FrameworkComputer/InputModules/Electrical/MinimalSmallInputModule/README.md

# Minimal Small Input Module


This is a blank Small Input Module that you can start from.

## License
Input Modules © 2023 by Framework Computer Inc is licensed under CC BY 4.0. To view a copy of this license, visit http://creativecommons.org/licenses/by/4.0/

## Fabrication and Assembly
We recommend using either a 0.8mm or 1.0mm PCB for Input Modules.
