FrameworkComputer/InputModules/Mechanical/Touchpad.md

# Touchpad

Touchpad mechanical CAD has been published in the
[Framework-Laptop-16](https://github.com/FrameworkComputer/Framework-Laptop-16/tree/main/Touchpad)
repository.
