FrameworkComputer/InputModules/Electrical/LEDMatrix/README.md

# LED Matrix Input Module
This is a 34x9 LED Matrix powered by a Raspberry Pi RP2040 microcontroller.

## Pre-production Unit
rp2040

Note that the KiCAD version of this project is incomplete and untested, and is only provided as a reference.

The Atemitech prototype was made and tested, but is missing
use of the #SLEEP signal in the current revision.
It is not the version that is shipping to customers.

## Mass Production Unit

Below are the pinouts of the mass production units.

###### RP2040 MCU Pinouts

| Pin | Name | To | Direction | Config |
|---|---|---|---|---|
| GPIO0  | Sleep | EC | IN | Pullup, low active |
| GPIO25 | DIP1 | DIP Switch | IN | Pullup |
| GPIO26 | I2C1_SDA | IS31FL3741 | IN/OUT | |
| GPIO27 | I2C1_SCL | IS31FL3741 | OUT | |
| GPIO28 | INTB | IS31FL3741 | IN | Floating (unused)  |
| GPIO29 | SDB | IS31FL3741 | OUT | High active |

###### Test Pads

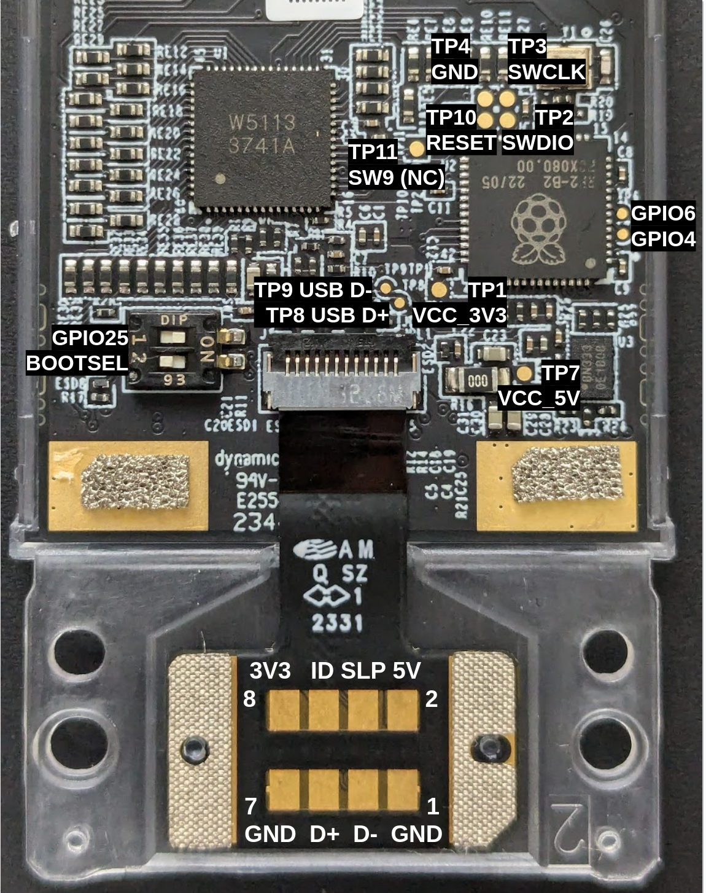
[picture p9: Electrical/LEDMatrix/test-pads.png]
Annotated picture with test pads


| Pad  | Name | Function |
|---|---|---|
| TP1  | VCC_3V3  | |
| TP2  | SWDIO | SWD Debug  |
| TP3  | SWCLK | SWD Debug  |
| TP4  | GND | SWD Debug  |
| TP5  | GPIO4 | |
| TP6  | GPIO5 | |
| TP7  | VCC_5V | |
| TP8  | USB DP | USB 2.0 |
| TP9  | USB DM | USB 2.0 |
| TP10 | RESET | |
| TP11 | SW9 | |
| DIP1 | GPIO25 | |
| DIP2 | BOOTSEL  | |

TP2-4 are used for SWD debugging and can be used with [picoprobe](https://www.raspberrypi.com/documentation/microcontrollers/debug-probe.html) or similar.

RESET and BOOTSEL are also useful. If RESET is shorted to GND it resets the RP2040.
If BOOTSEL is shorted to GND while the RP2040 comes out of reset, it boots into UF2 bootlaoder for firmware update.

###### IS31FL3741 LED Controller

[Documentation](https://www.lumissil.com/applications/industrial/appliance/major-appliances/range-hood/is31fl3741a)
and [Datasheet](https://www.lumissil.com/assets/pdf/core/IS31FL3741A_DS.pdf)
of this controller are publicly available.

It drives a matrix of 9x34 (306) LEDs.

| Pin | To | Direction | Config |
|---|---|---|---|
| SDA | RP2040 | IN/OUT | |
| SCL | RP2040 | IN | |
| INTB | RP2040 | OUT | Floating (unused) |
| SDB | RP2040 | IN | High active |
| ISET | 27k to GND  | | |
| ADDR | 100k to GND | | |
| SW1-SW8  | LED | OUT | See table below |
| SW9 | NC | | Unused |
| CS1-CS39 | LED | OUT | See table below |

The ISET and ADDR wiring results in I2C Address 0x30.

Below is the table describing how the LEDs are placed on the matrix
and how they are wired up to the LED controller.

- X is the X location in the matrix (from left to right)
- Y is the Y location in the matrix (from bottom to top)
- ID is the numerical identifier of the LED
- Address and Page describe the memory location in the IS31FL3741's registers
- SW and CS are the pins

Please refer to the controller's datasheet for additional information about how to
program it.

| X | Y  | ID  | Address | Page | SW | CS |
|---|----|-----|---|---|----|----|
| 1 | 1  | 1 | 0x00 | 0 | 1  | 1  |
| 2 | 1  | 2 | 0x1e | 0 | 2  | 1  |
| 3 | 1  | 3 | 0x3c | 0 | 3  | 1  |
| 4 | 1  | 4 | 0x5a | 0 | 4  | 1  |
| 5 | 1  | 5 | 0x78 | 0 | 5  | 1  |
| 6 | 1  | 6 | 0x96 | 0 | 6  | 1  |
| 7 | 1  | 7 | 0x00 | 1 | 7  | 1  |
| 8 | 1  | 8 | 0x1e | 1 | 8  | 1  |
| 9 | 1  | 9 | 0x5f | 1 | 1  | 36 |
| 1 | 2  | 10  | 0x01 | 0 | 1  | 2  |
| 2 | 2  | 11  | 0x1f | 0 | 2  | 2  |
| 3 | 2  | 12  | 0x3d | 0 | 3  | 2  |
| 4 | 2  | 13  | 0x5b | 0 | 4  | 2  |
| 5 | 2  | 14  | 0x79 | 0 | 5  | 2  |
| 6 | 2  | 15  | 0x97 | 0 | 6  | 2  |
| 7 | 2  | 16  | 0x01 | 1 | 7  | 2  |
| 8 | 2  | 17  | 0x1f | 1 | 8  | 2  |
| 9 | 2  | 18  | 0x60 | 1 | 1  | 37 |
| 1 | 3  | 19  | 0x02 | 0 | 1  | 3  |
| 2 | 3  | 20  | 0x20 | 0 | 2  | 3  |
| 3 | 3  | 21  | 0x3e | 0 | 3  | 3  |
| 4 | 3  | 22  | 0x5c | 0 | 4  | 3  |
| 5 | 3  | 23  | 0x7a | 0 | 5  | 3  |
| 6 | 3  | 24  | 0x98 | 0 | 6  | 3  |
| 7 | 3  | 25  | 0x02 | 1 | 7  | 3  |
| 8 | 3  | 26  | 0x20 | 1 | 8  | 3  |
| 9 | 3  | 27  | 0x61 | 1 | 1  | 38 |
| 1 | 4  | 28  | 0x03 | 0 | 1  | 4  |
| 2 | 4  | 29  | 0x21 | 0 | 2  | 4  |
| 3 | 4  | 30  | 0x3f | 0 | 3  | 4  |
| 4 | 4  | 31  | 0x5d | 0 | 4  | 4  |
| 5 | 4  | 32  | 0x7b | 0 | 5  | 4  |
| 6 | 4  | 33  | 0x99 | 0 | 6  | 4  |
| 7 | 4  | 34  | 0x03 | 1 | 7  | 4  |
| 8 | 4  | 35  | 0x21 | 1 | 8  | 4  |
| 9 | 4  | 36  | 0x62 | 1 | 1  | 39 |
| 1 | 5  | 37  | 0x04 | 0 | 1  | 5  |
| 2 | 5  | 41  | 0x22 | 0 | 2  | 5  |
| 3 | 5  | 45  | 0x40 | 0 | 3  | 5  |
| 4 | 5  | 49  | 0x5e | 0 | 4  | 5  |
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

## License
Input Modules © 2023 by Framework Computer Inc is licensed under CC BY 4.0. To view a copy of this license, visit http://creativecommons.org/licenses/by/4.0/
