FrameworkComputer/InputModules/Mechanical/Medium/fw_b_size_design_ref_0-1.dxf

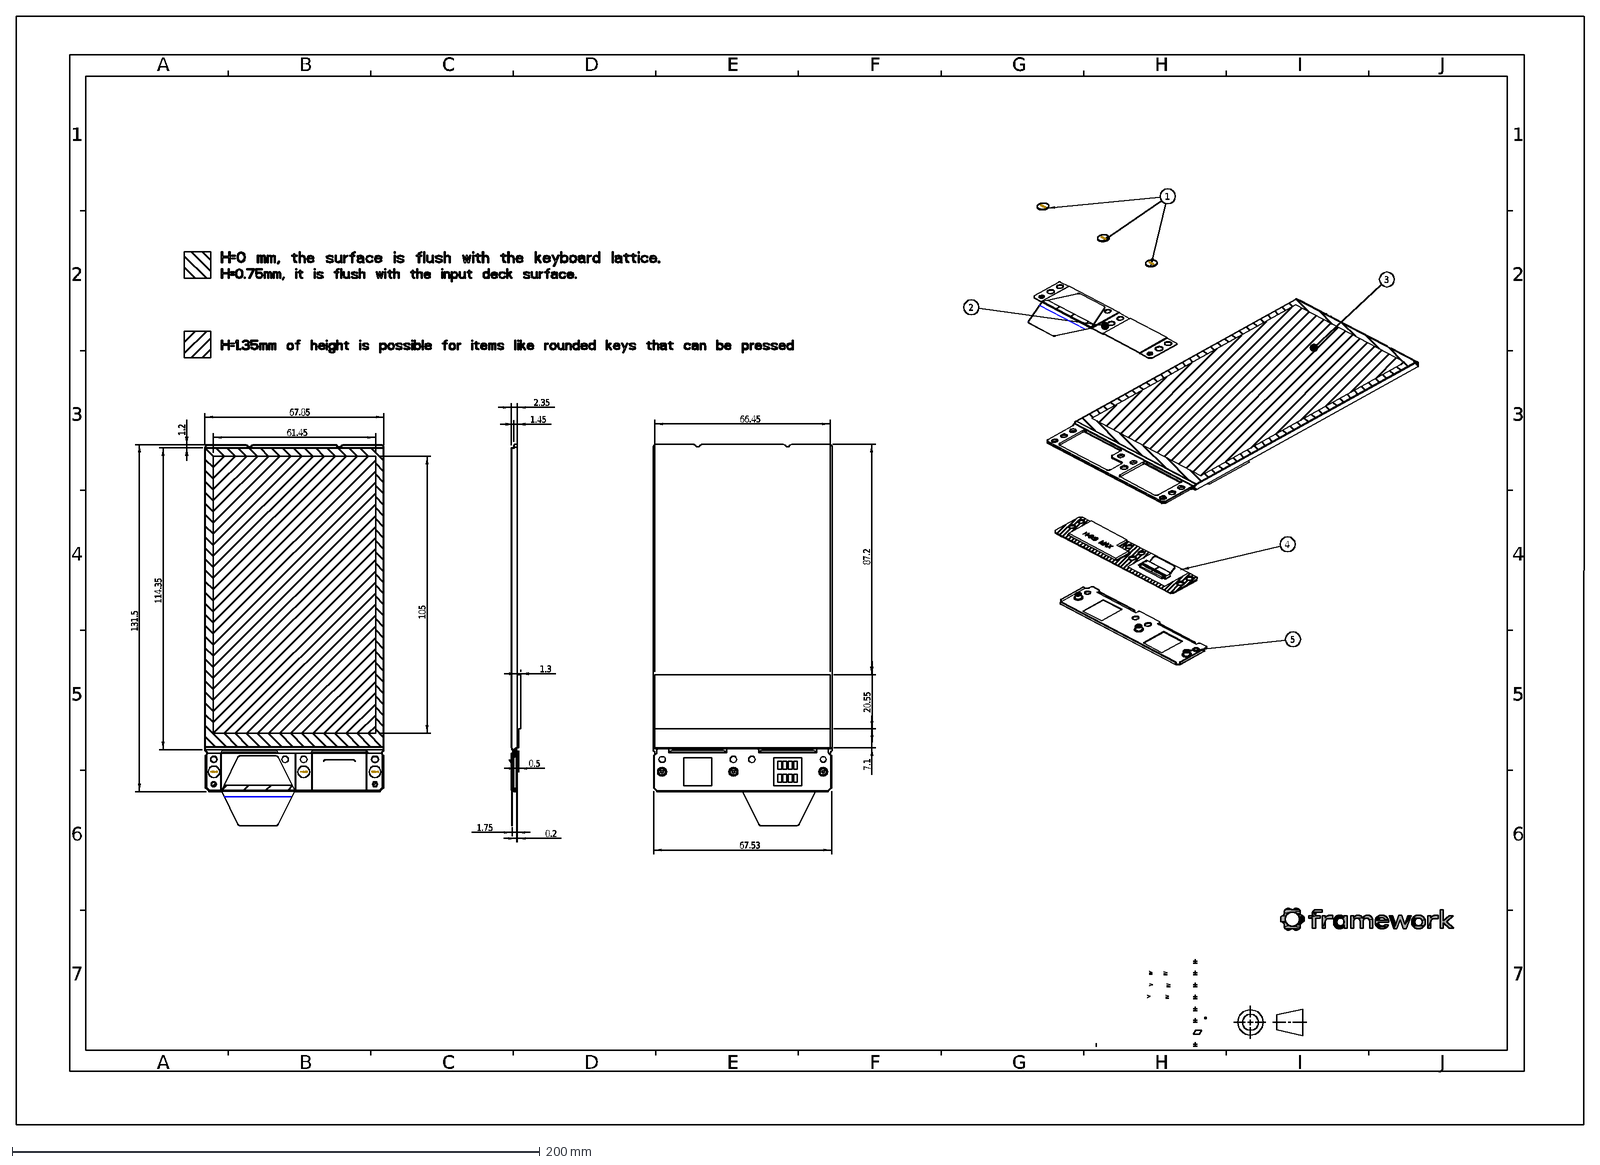
[picture p10: CAD file, 2023-03-12]
Mechanical/Medium/fw_b_size_design_ref_0-1.dxf
A
7
6
5
C
B
D
1
4
3
2
E
F
G
H
I
J
67.85
131.5
2.35
1.45
1.2
114.35
105
61.45
1.3
0.5
0.2
1.75
67.53
87.2
20.55
7.1
66.45
