FrameworkComputer/InputModules/Mechanical/Small/Module/c1_design_space_ref_3.dxf

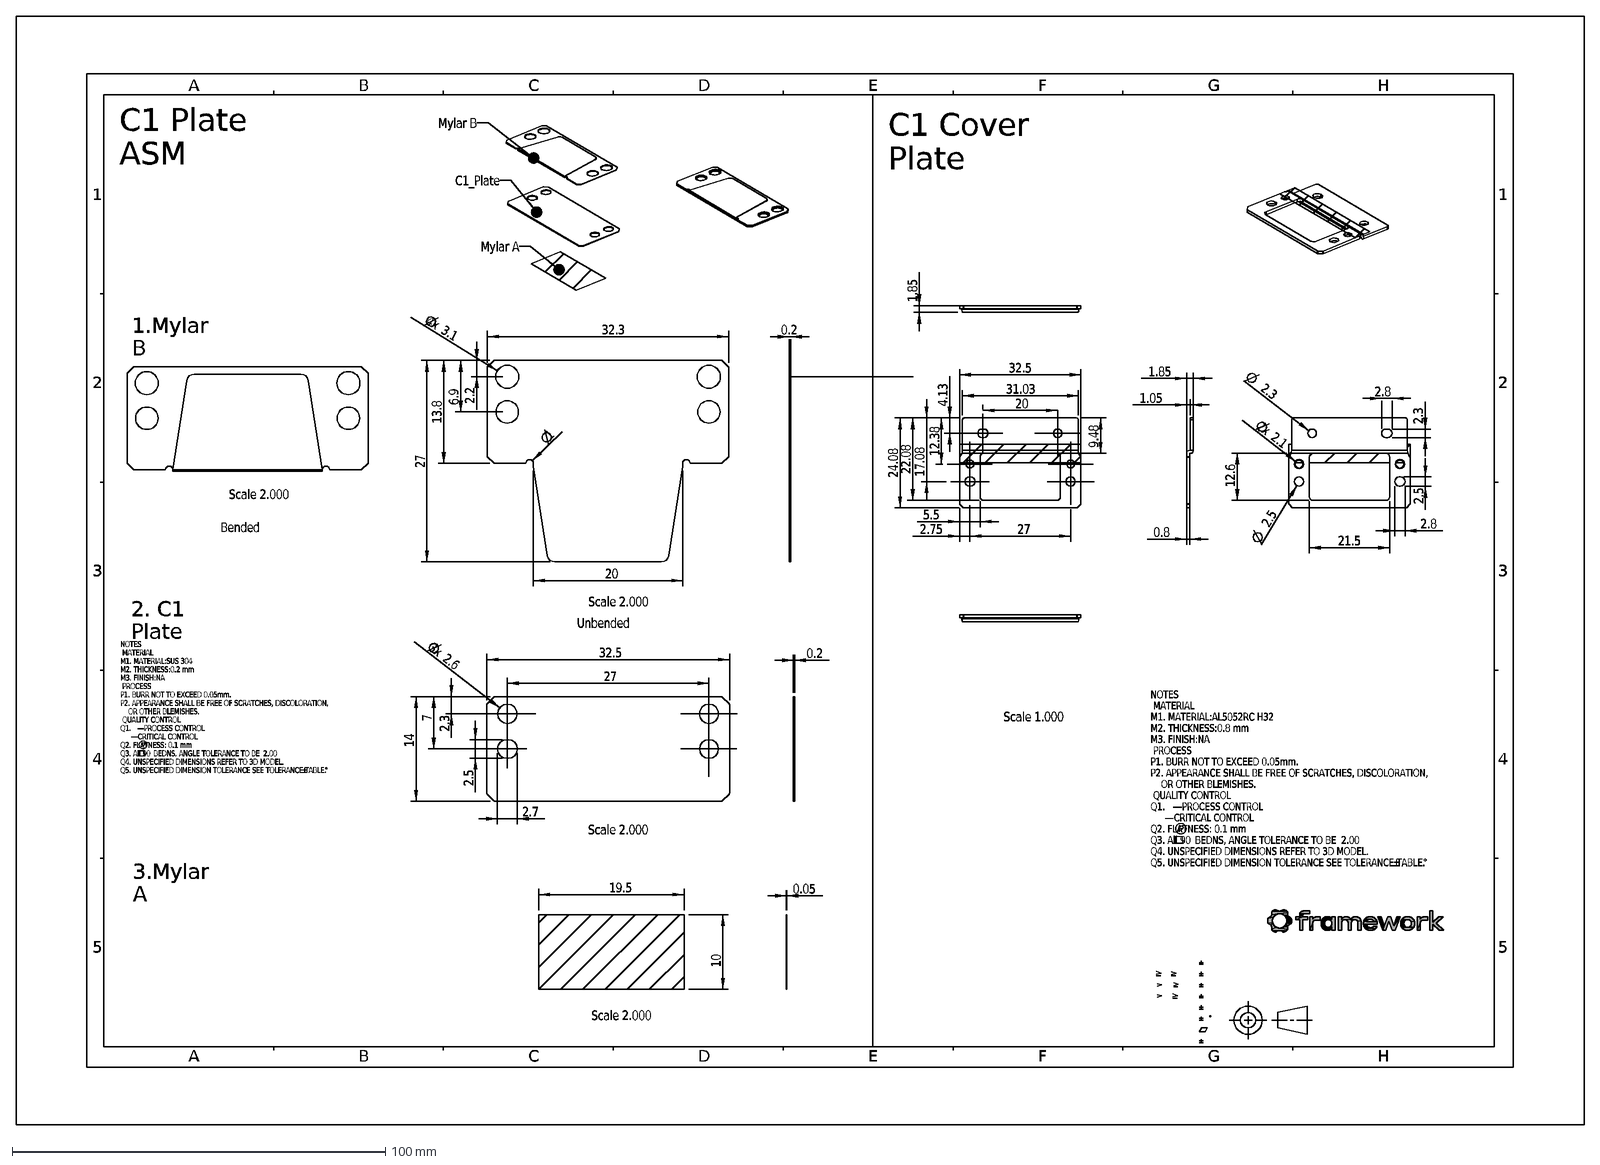
[picture p11: CAD file, 2023-03-12]
Mechanical/Small/Module/c1_design_space_ref_3.dxf
A
B
5
4
3
2
1
C
D
E
F
G
H
32.5
14
27
2.3
0.2
32.3
3x \~2.6
2.5
2.7
4x \~3.1
7
13.8
2.2
6.9
20
19.5
10
0.05
31.03
2x \~2.1
2.8
1.85
0.8
1.05
24.08
22.08
12.38
4.13
17.08
21.5
12.6
2.75
5.5
9.48
NOTES MATERIAL M1. MATERIAL:SUS 304 M2. THICKNESS:0.2 mm M3. FINISH:NA PROCESS P1. BURR NOT TO EXCEED 0.05mm. P2. APPEARANCE SHALL BE FREE OF SCRATCHES, DISCOLO
Bended
Unbended
C1 Plate ASM
1.Mylar B
3.Mylar A
2. C1 Plate
C1 Cover Plate
NOTES MATERIAL M1. MATERIAL:AL5052RC H32 M2. THICKNESS:0.8 mm M3. FINISH:NA PROCESS P1. BURR NOT TO EXCEED 0.05mm. P2. APPEARANCE SHALL BE FREE OF SCRATCHES, DI
Scale 2.000
Mylar B
C1_Plate
Mylar A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
