FrameworkComputer/InputModules/Mechanical/Small/PCB/c1_pcb_concept_design_ref_2.dxf

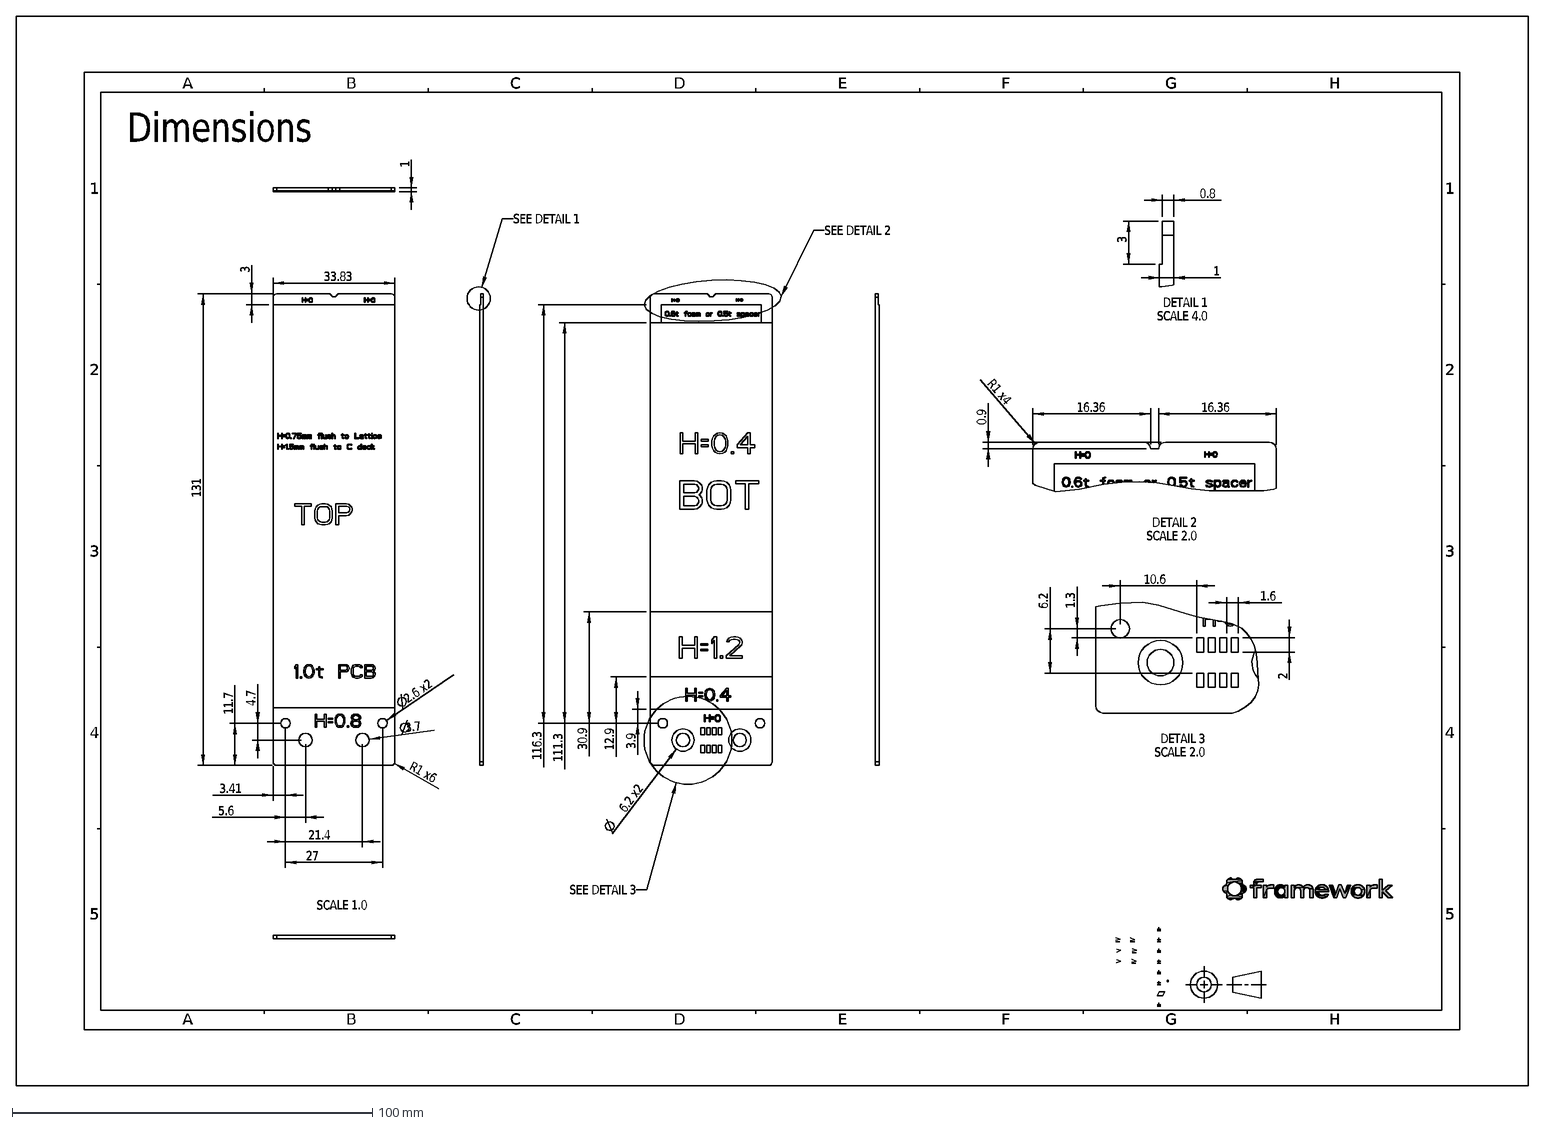
[picture p12: CAD file, 2023-03-12]
Mechanical/Small/PCB/c1_pcb_concept_design_ref_2.dxf
A
B
5
4
3
2
1
C
D
E
F
G
H
33.83
131
0.8
16.36
0.9
R1 x4
R1 x6
11.7
2.6 x2
3.7
3.41
5.6
4.7
27
21.4
3.9
12.9
30.9
111.3
116.3
6.2 x2
10.6
1.3
6.2
1.6
Dimensions
SCALE 1.0
SEE DETAIL 1
SEE DETAIL 2
SEE DETAIL 3
DETAIL 1 SCALE 4.0
DETAIL 2 SCALE 2.0
DETAIL 3 SCALE 2.0
