FrameworkComputer/InputModules/OneKeyModule/Mechanical/One_Key_Module_CAD.stp

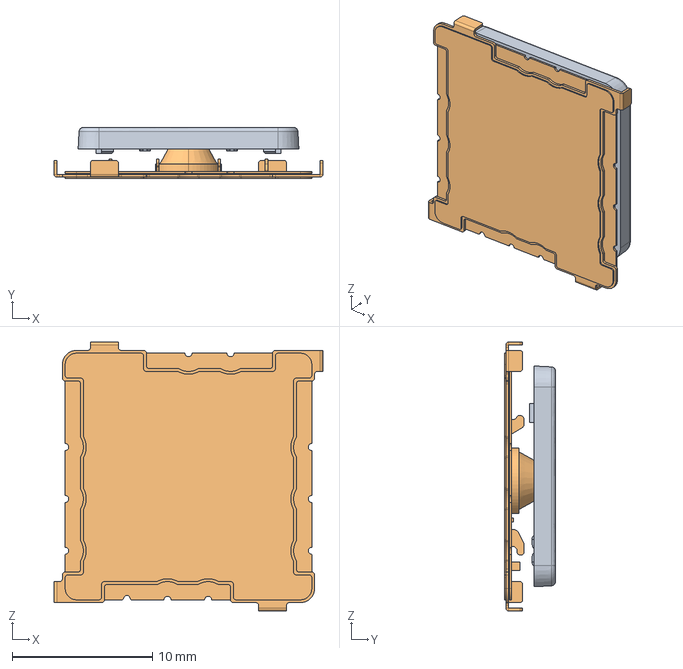
[picture p13: CAD file, 2025-12-29]
OneKeyModule/Mechanical/One_Key_Module_CAD.stp
19.2 x 3.64 x 19.2 mm
