FrameworkComputer/InputModules/Mechanical/Medium/fw_b_size_design_ref_0-2.dxf

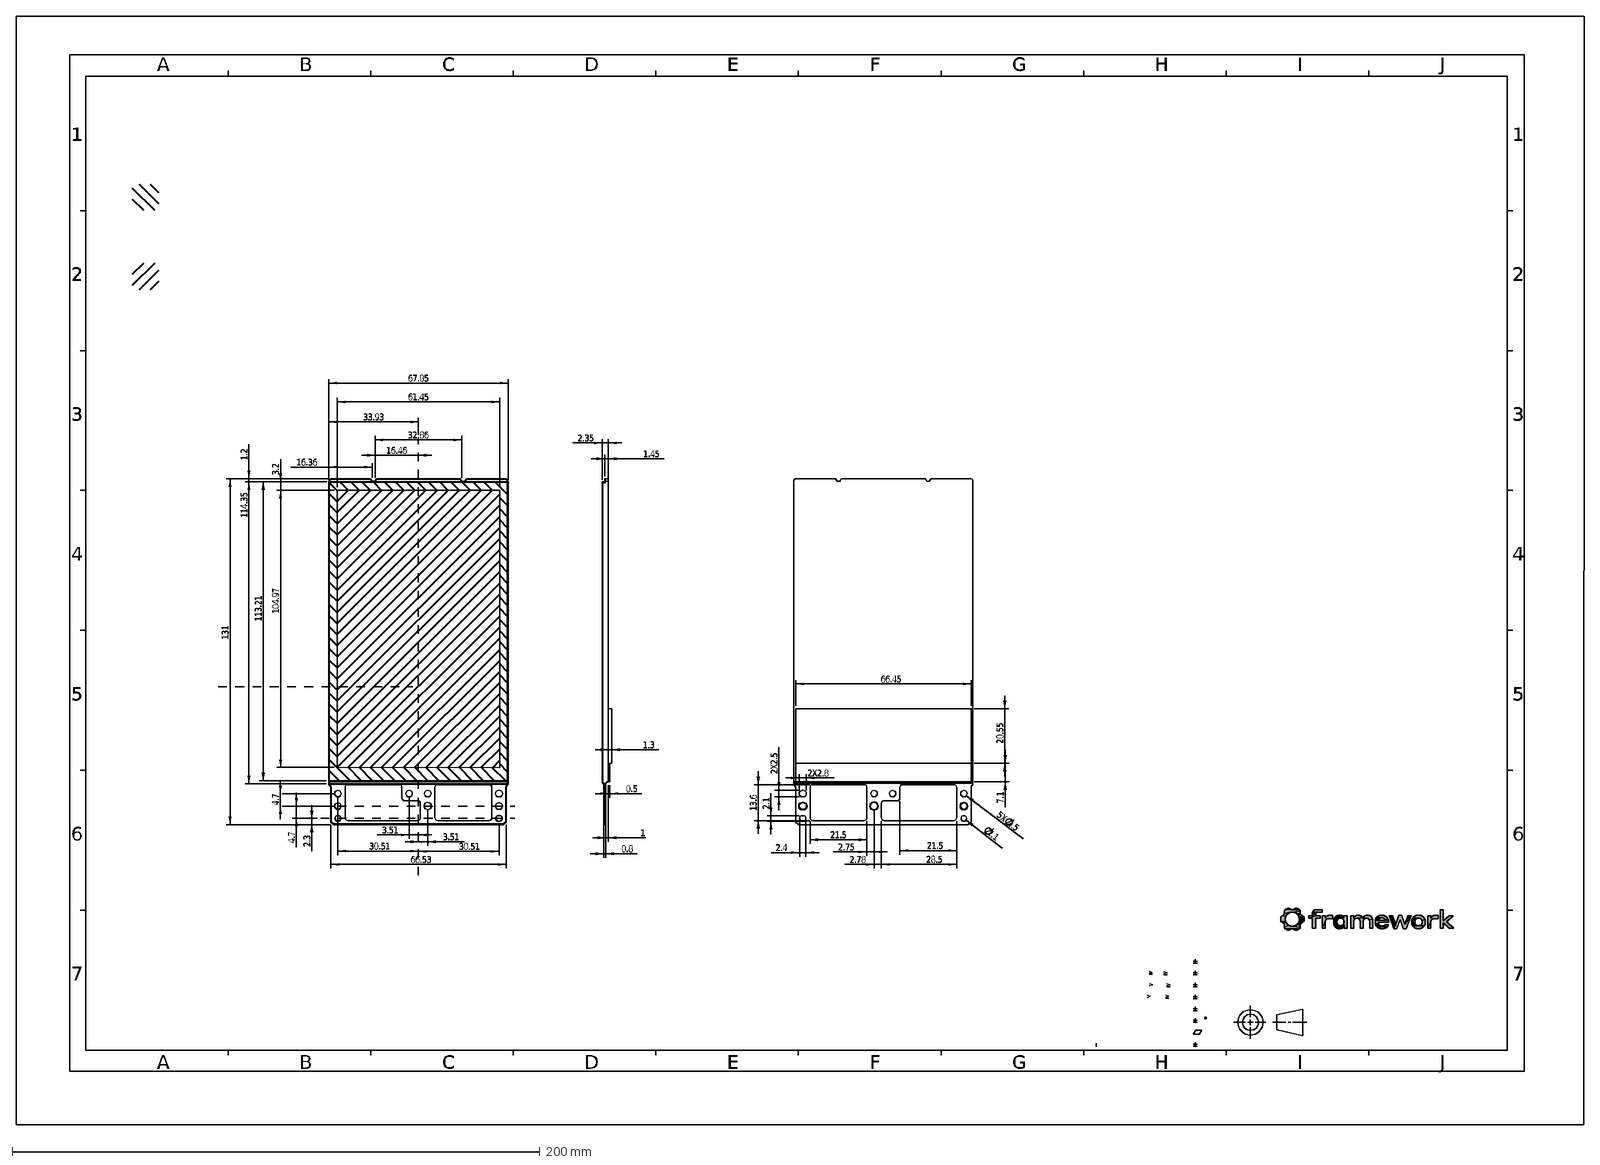
[picture p14: CAD file, 2023-03-12]
Mechanical/Medium/fw_b_size_design_ref_0-2.dxf
A
7
6
5
C
B
D
1
4
3
2
E
F
G
H
I
J
16.46
33.93
3.51
30.51
2.3
4.7
67.85
32.86
16.36
1.2
131
114.35
104.97
3.2
113.21
61.45
66.53
2.35
1.45
0.8
0.5
1.3
66.45
20.55
7.1
13.6
21.5
28.5
2.78
2.75
2.1
5X \~2.5
2.4
2X2.8
2X2.5
