FrameworkComputer/InputModules/Mechanical/Small/Module/c1_design_space_ref_4.dxf

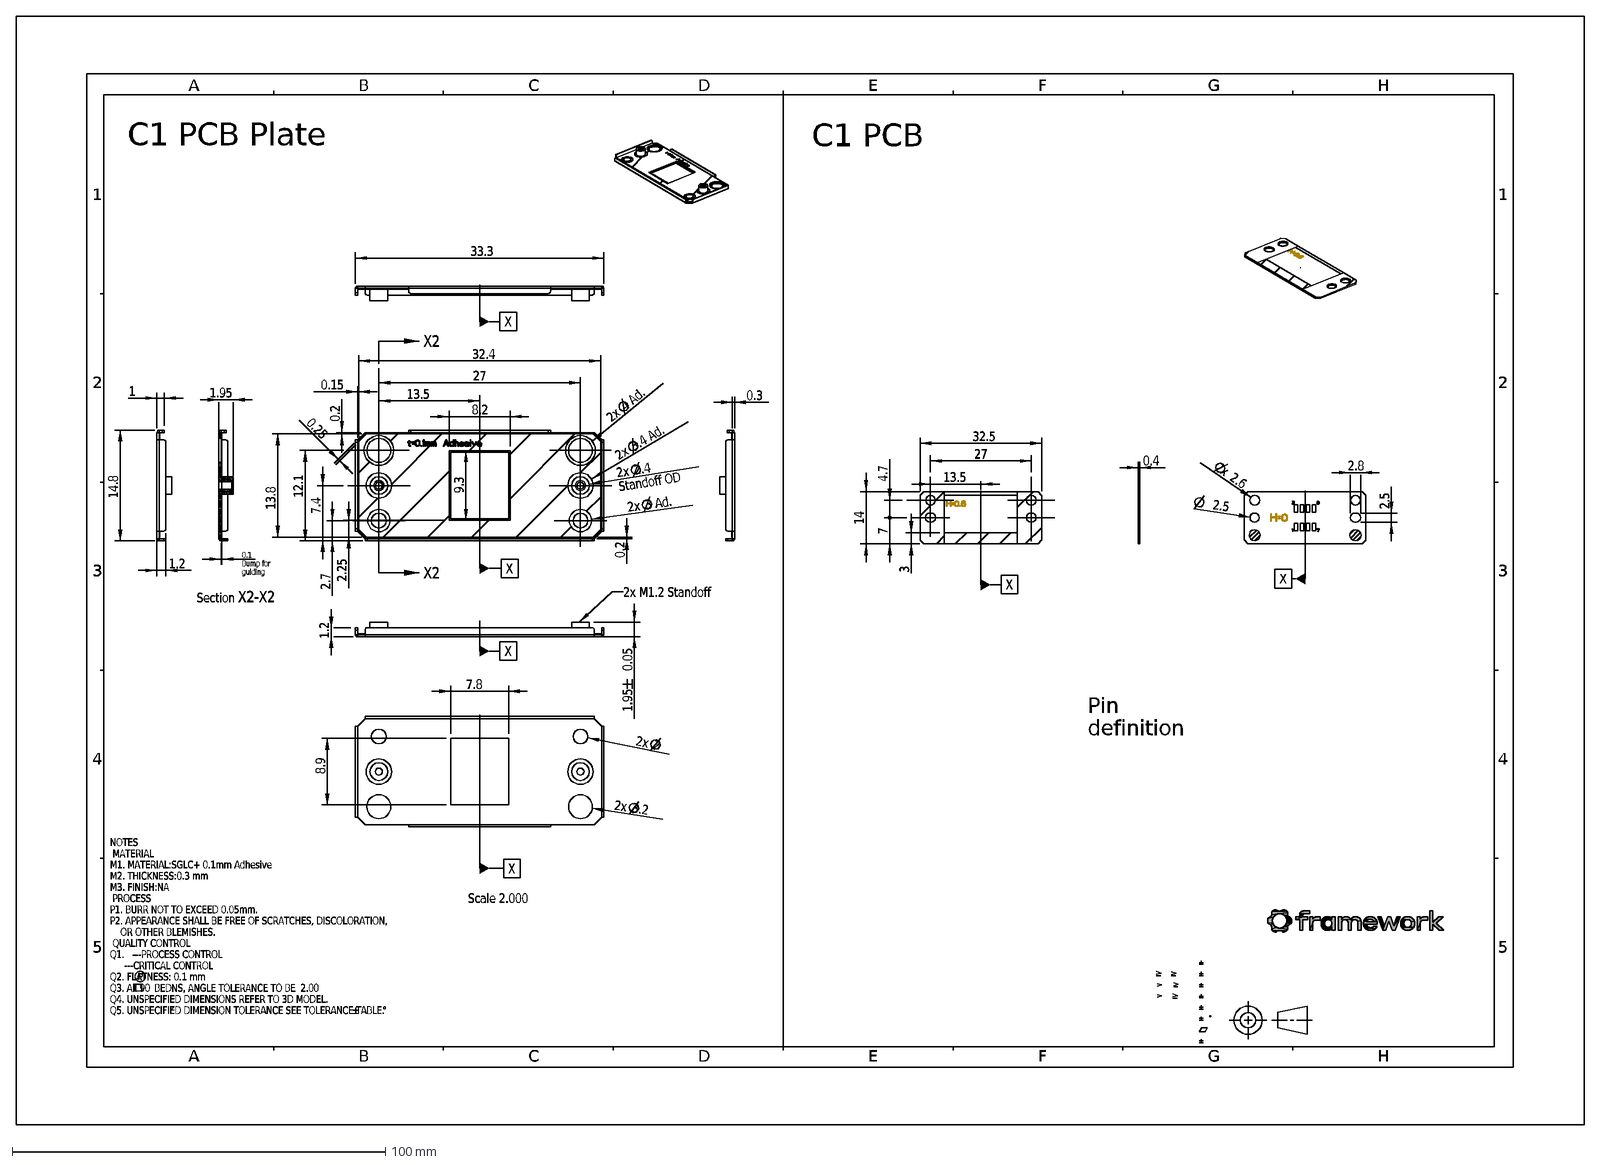
[picture p15: CAD file, 2023-03-12]
Mechanical/Small/Module/c1_design_space_ref_4.dxf
A
B
5
4
3
2
1
C
D
E
F
G
H
X
X2
33.3
14.8
8.9
7.8
1.95
0.05
13.5
27
12.1
2.7
7.4
0.2
0.15
0.25
2x \~4 Ad.
2x \~3.4 Ad.
2x \~3 Ad.
8.2
9.3
2.25
32.4
13.8
0.3
1.2
2x \~2.4 Standoff OD
2x \~2
2x \~3.2
0.4
32.5
14
4.7
7
2x \~2.6
2.5
2.8
0.1 Bump for guiding
C1 PCB Plate
NOTES MATERIAL M1. MATERIAL:SGLC+ 0.1mm Adhesive M2. THICKNESS:0.3 mm M3. FINISH:NA PROCESS P1. BURR NOT TO EXCEED 0.05mm. P2. APPEARANCE SHALL BE FREE OF SCRAT
C1 PCB
Pin definition
Scale 2.000
2x M1.2 Standoff
Section X2-X2
