FrameworkComputer/InputModules/Mechanical/Small/PCB/c1_pcb_concept_design_ref_1.dxf

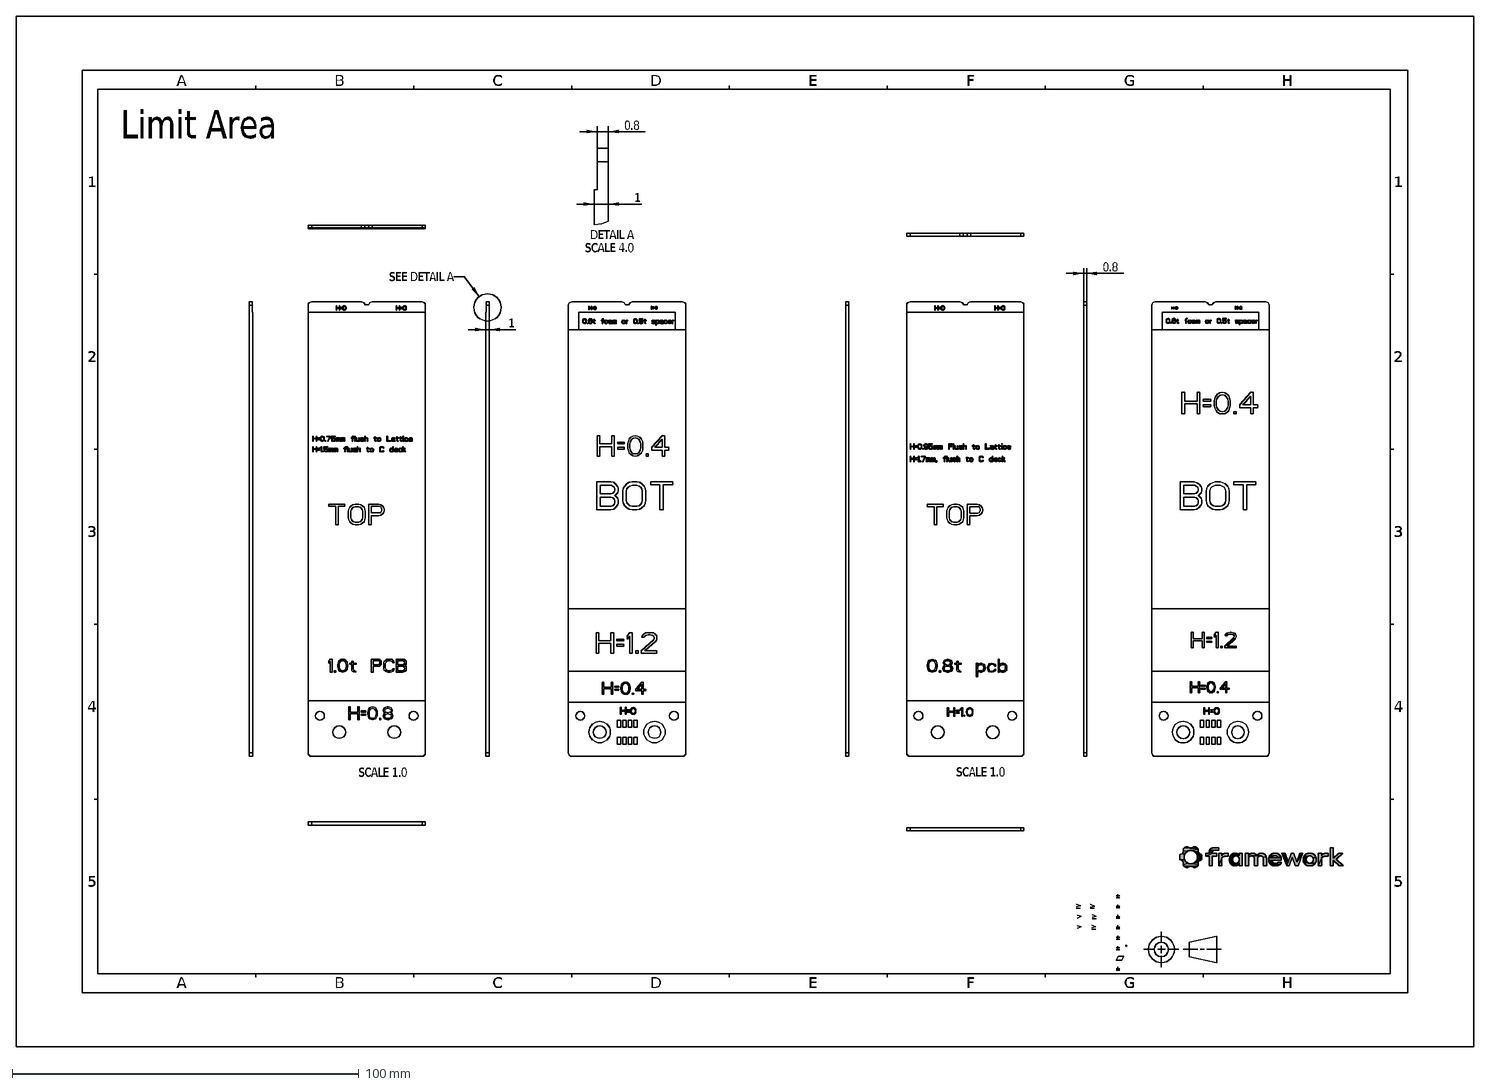
[picture p16: CAD file, 2023-03-12]
Mechanical/Small/PCB/c1_pcb_concept_design_ref_1.dxf
A
B
5
4
3
2
1
C
D
E
F
G
H
0.8
Limit Area
SCALE 1.0
SEE DETAIL A
DETAIL A SCALE 4.0
