FrameworkComputer/InputModules/Mechanical/Medium/fw_b_size_design_ref_0-3.dxf

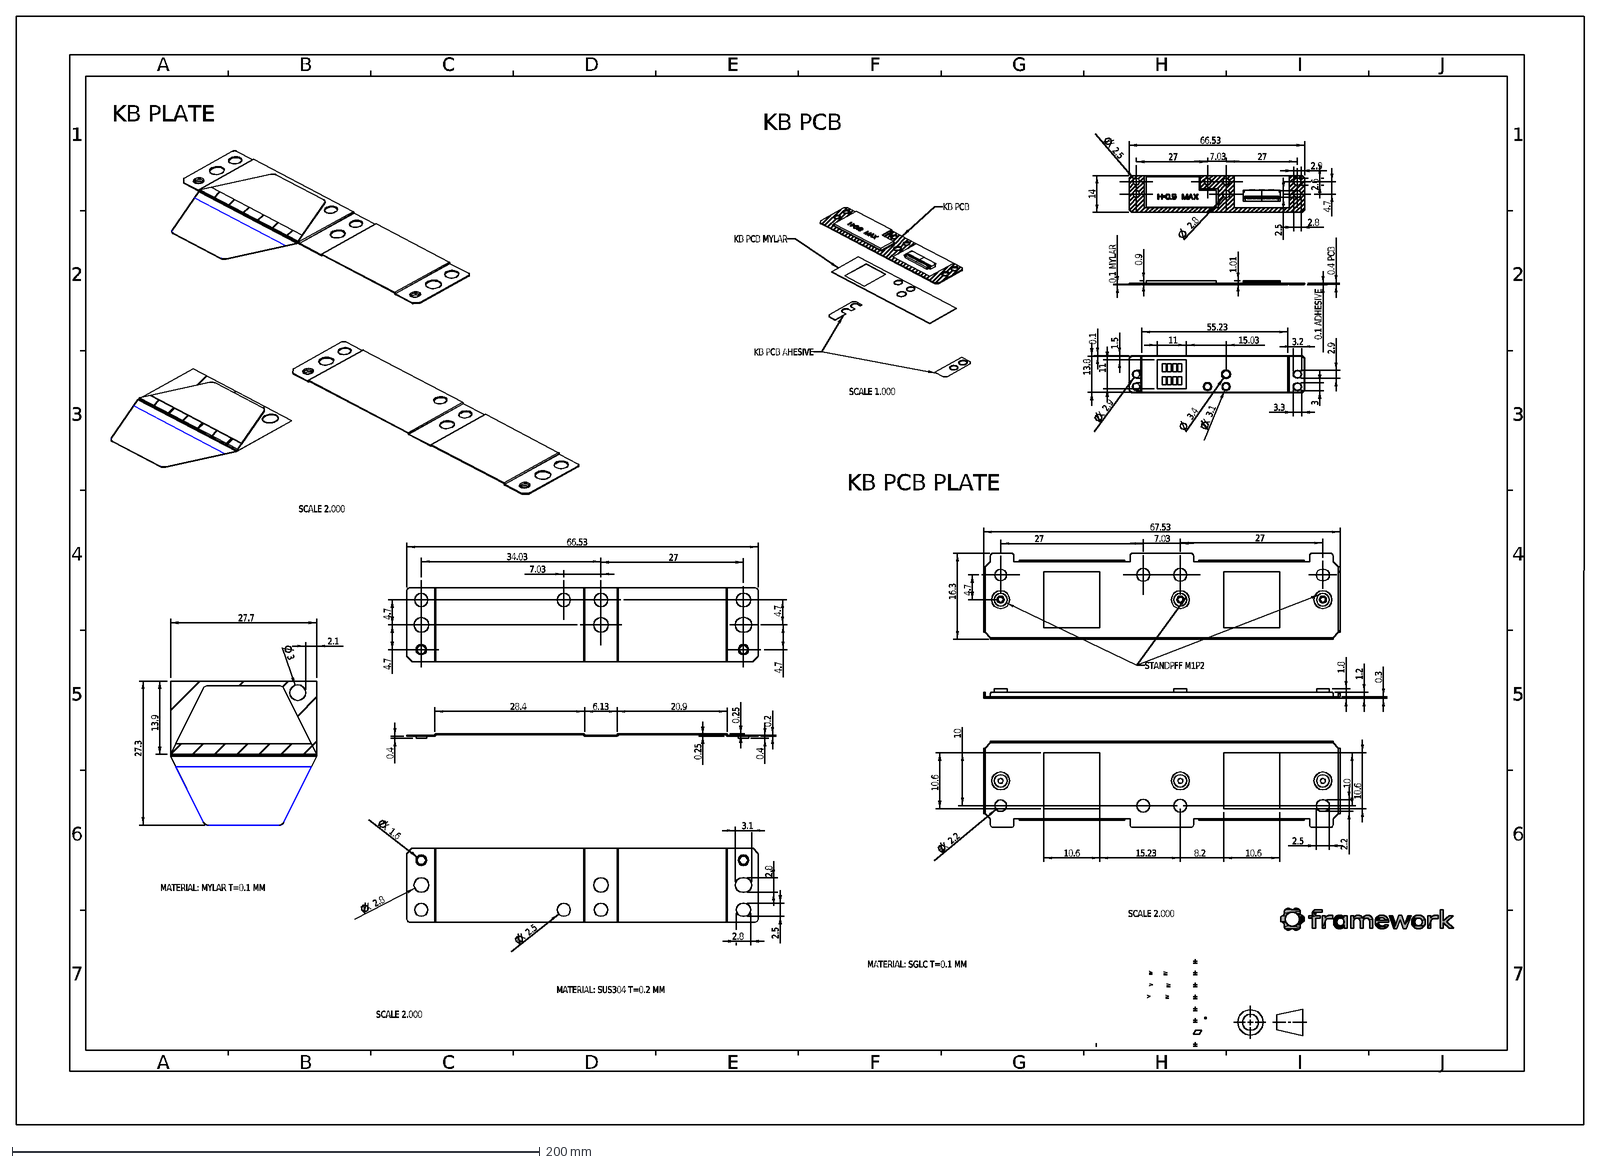
[picture p17: CAD file, 2023-03-12]
Mechanical/Medium/fw_b_size_design_ref_0-3.dxf
A
7
6
5
C
B
D
1
4
3
2
E
F
G
H
I
J
66.53
14
27
7.03
4.7
0.4 PCB
0.1 ADHESIVE
0.9
1.01
0.1 MYLAR
2.8
4X \~2.5
2.9
2.6
2.5
11
1.5
15.03
2X \~2.9
3.4
2X \~3.1
3.2
3.3
13.8
0.1
55.23
67.53
16.3
0.3
1.2
1.8
10.6
15.23
10
8.2
3X \~2.2
2.2
34.03
0.4
0.2
0.25
6.13
28.4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
