FrameworkComputer/InputModules/Mechanical/Small/Module/c1_design_space_ref_1.dxf

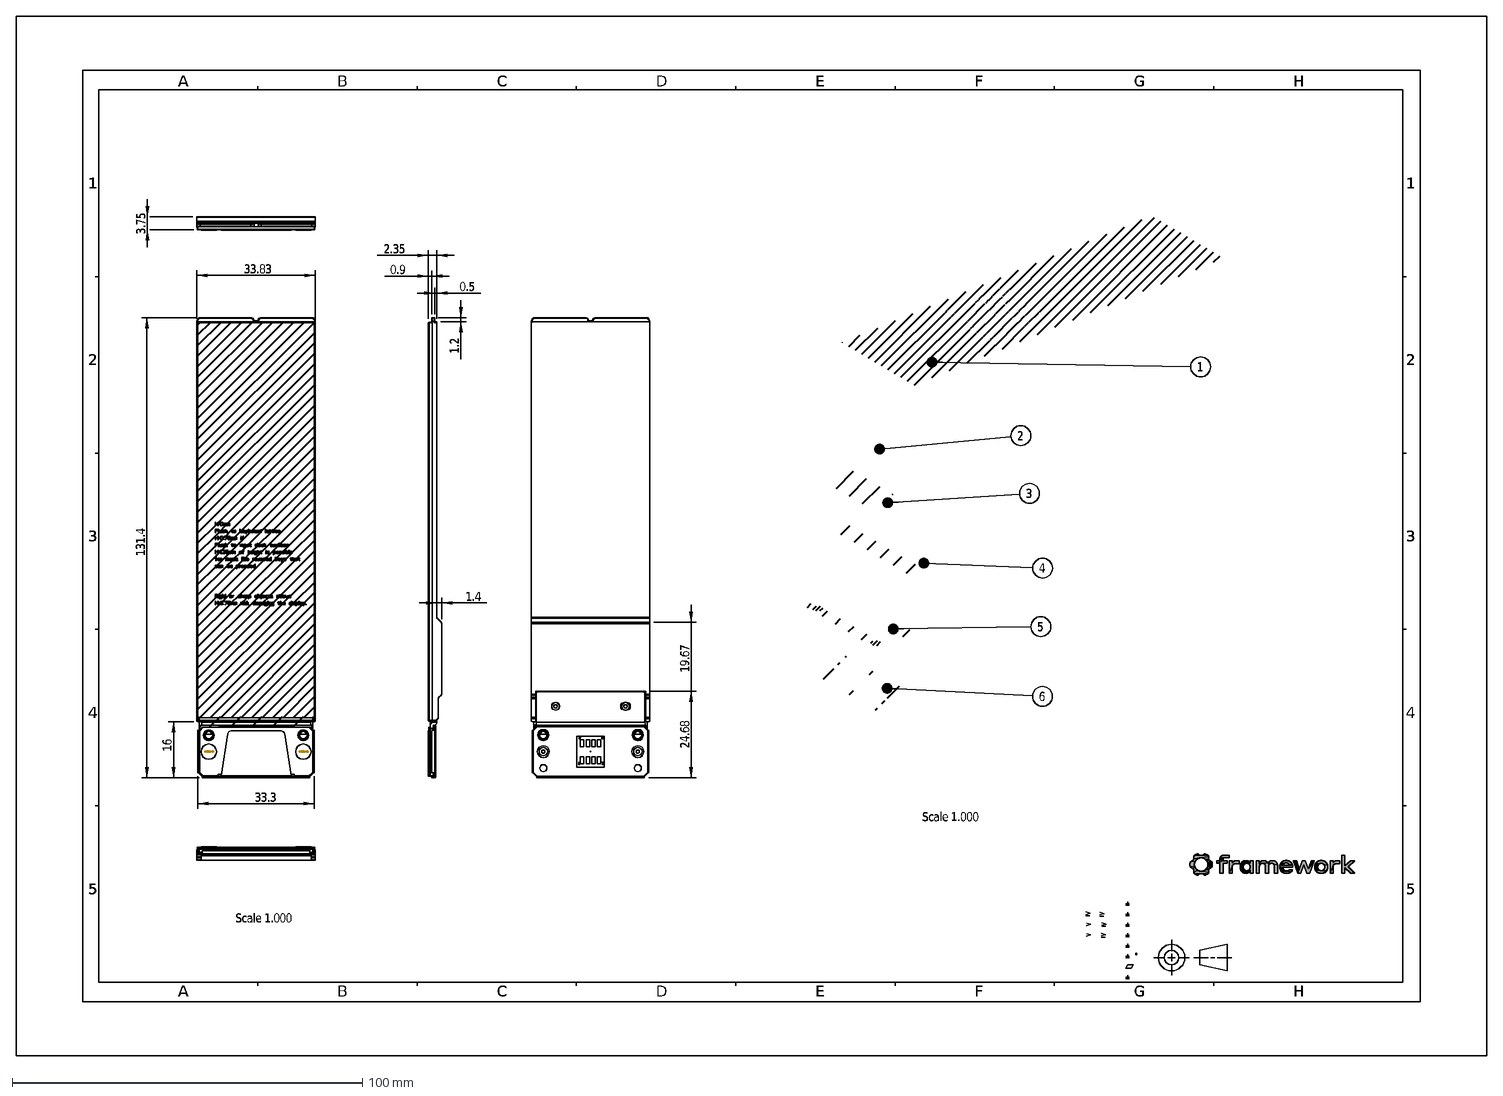
[picture p18: CAD file, 2023-03-12]
Mechanical/Small/Module/c1_design_space_ref_1.dxf
A
B
5
4
3
2
1
C
D
E
F
G
H
131.4
33.83
0.9
2.35
0.5
1.2
33.3
16
3.75
24.68
19.67
1.4
Scale 1.000
6
