FrameworkComputer/InputModules/Mechanical/Small/PCB/C1_pcb_ref_design_0_8t_00.stp

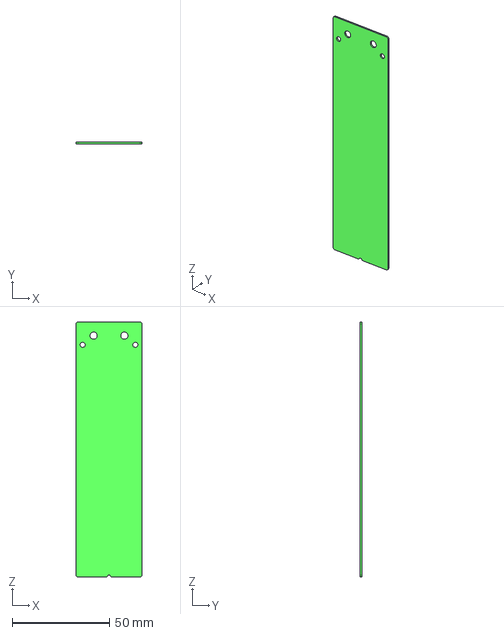
[picture p19: CAD file, 2023-03-12]
Mechanical/Small/PCB/C1_pcb_ref_design_0_8t_00.stp
33.8 x 0.8 x 131.0 mm
