FrameworkComputer/InputModules/Mechanical/Small/Module/c1_design_space_ref_2.dxf

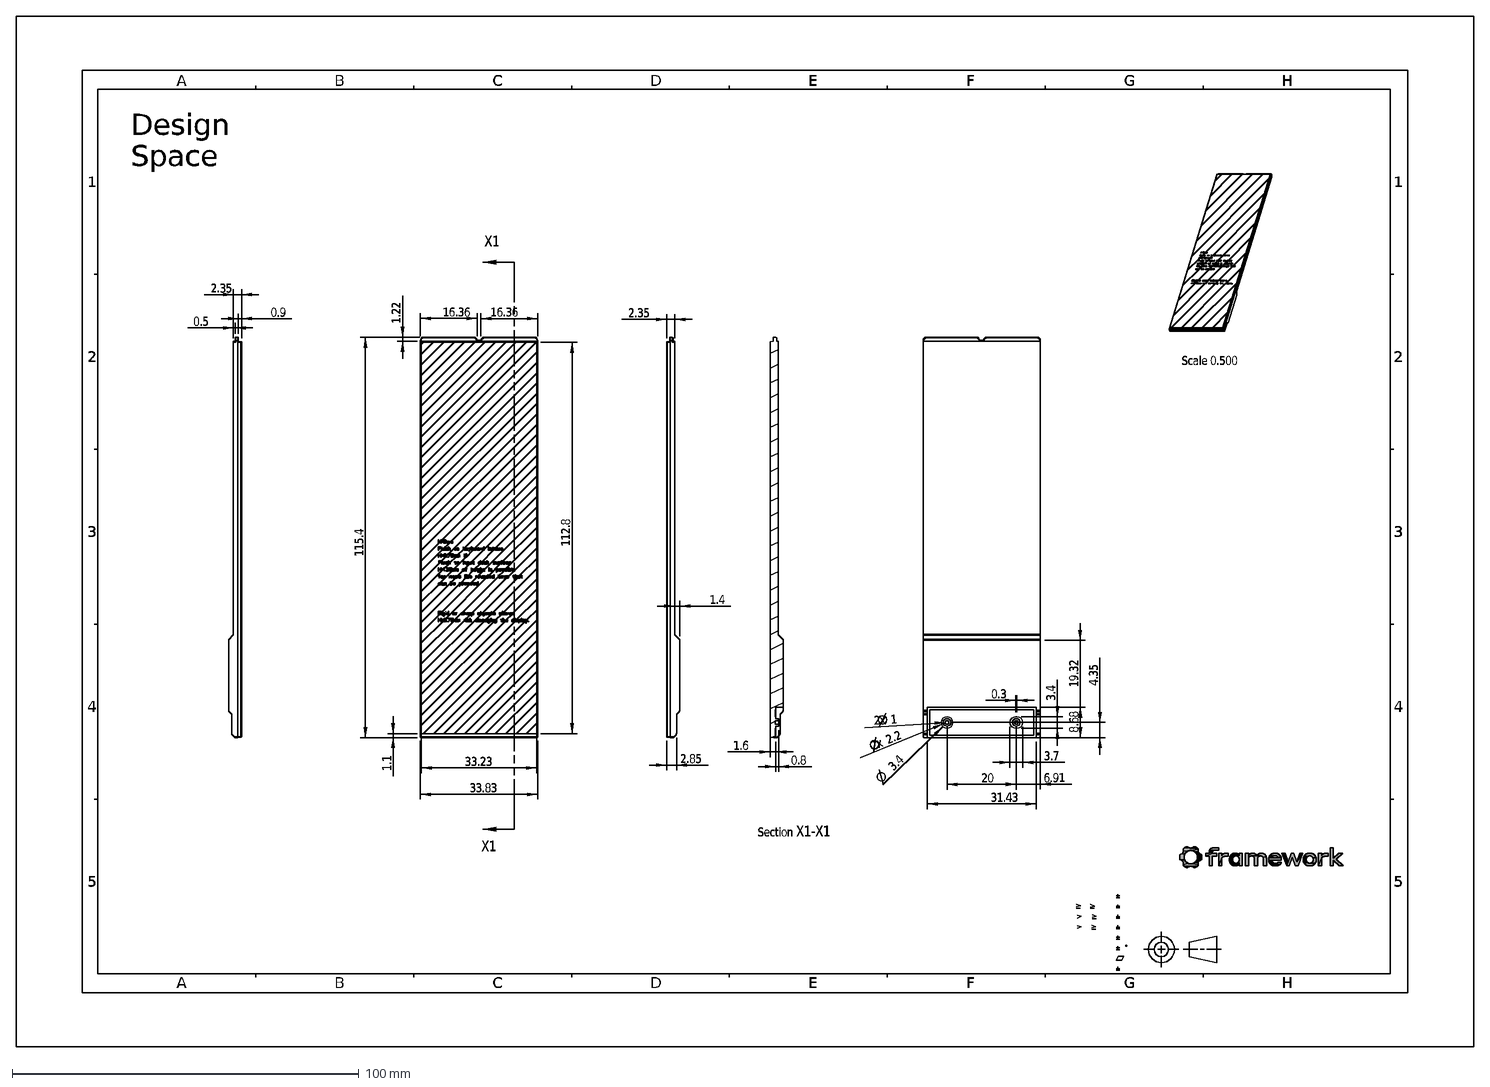
[picture p20: CAD file, 2023-03-12]
Mechanical/Small/Module/c1_design_space_ref_2.dxf
A
B
5
4
3
2
1
C
D
E
F
G
H
X1
115.4
1.22
16.36
112.8
33.23
33.83
1.1
0.5
0.9
2.35
1.4
2x \~2.2
2x \~1
3.4
8.68
19.32
31.43
20
6.91
0.3
3.7
0.8
1.6
4.35
2.85
Design Space
Scale 0.500
Section X1-X1
