FrameworkComputer/InputModules/Mechanical/Small/PCB/C1_pcb_ref_design_1_0t_00.stp

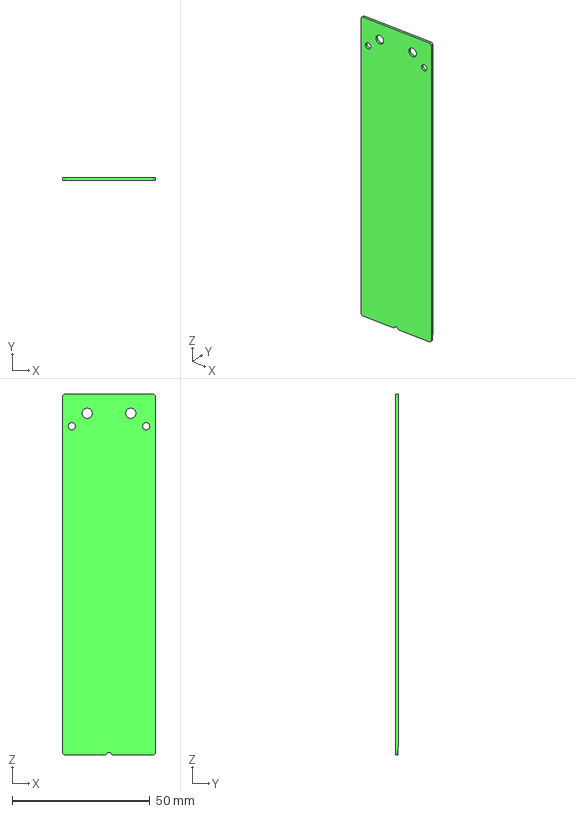
[picture p21: CAD file, 2023-03-12]
Mechanical/Small/PCB/C1_pcb_ref_design_1_0t_00.stp
33.8 x 1.00 x 131.0 mm
