FrameworkComputer/InputModules/Mechanical/Small/Module/c1_design_space_ref.stp

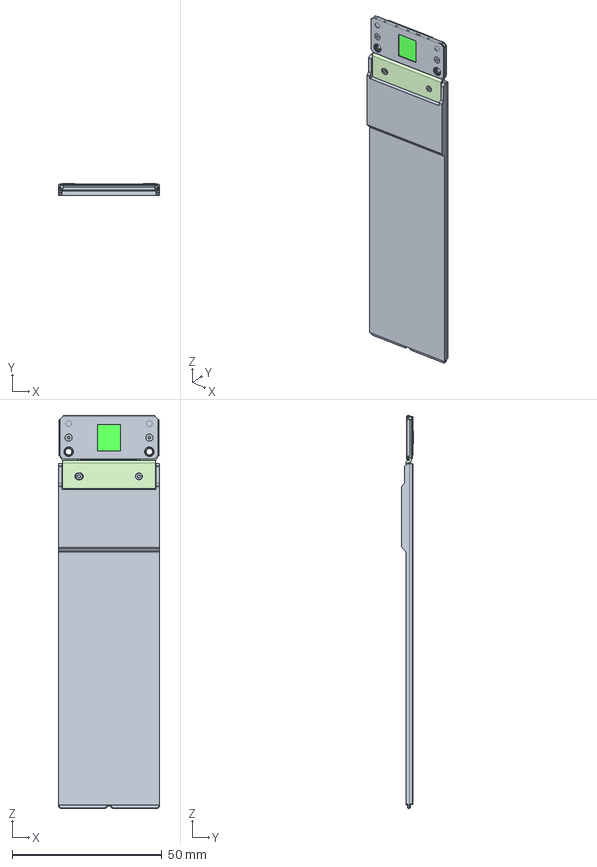
[picture p22: CAD file, 2023-03-12]
Mechanical/Small/Module/c1_design_space_ref.stp
33.8 x 3.85 x 131.4 mm
IFGP6_C1_DATUM
IFGP6_C1_COVER_PLATE
IFGP6_C1_PLATE
IFGP6_C1_PLATE_MYLAR_A
IFGP6_C1_PLATE_MYLAR_B_3D
IFGP6_C1_PCB
IFGP6_C1_PCB_PLATE
IFW70_STANDOFF_C_M1P2 x 2
IFGP6_C1_PCB_PLATE_ADHESIVE
IFW70_SCREW_M1P2_A x 2
C1_DESIGN_SPACE_F_T_LATTICE
