FrameworkComputer/InputModules/(list of files, cad)

Other CAD files:
Mechanical/Large/a1_module_design_ref_00_1.dxf
