FrameworkComputer/InputModules/(threads)

Thread 1 (2023-03-24):

Trackpoint please, please *please*

chx, 2023-03-24:
The IBM patents have expired... https://patents.google.com/patent/US6115030A/en

I am sure https://tex.com.tw/ have the modules for an agreeable price.

jyancat, 2023-03-26:
Issues are not for feature requests, this is generally for reporting issues with anything in this repository. If you want to request a feature/new module you can use the forums [https://community.frame.work/](url)

eclecticc, 2023-04-15:
@jyancat 's comment is correct.  Closing out.

chx, 2023-04-15:
Extremely disappointing.

eclecticc, 2023-04-15:
To be clear, @jyancat 's correct comment is that GitHub Issues are for reporting bugs or adding enhancements within the code or CAD that exists in the repository.  Feature requests for the product itself go in the Framework Community.

cscott, 2024-01-23:
See https://community.frame.work/t/thinkpad-keyboard-mod-super-early-stages/38484 for active discussion.

Closed 2023-04-15.

Thread 2 (2023-03-24):

compatible key switches

stuart-warren, 2023-03-24:
I'm very excited by this project, especially the usb support.

If we were to build homebrew input modules that are more ergonomic what key-switches would even fit under the screen?

Kailh choc switches look like they may not, and I don't believe cherry mx ultra low profile are even available to the public in small quantities.

Ideally I'd like to build (assuming you won't provide) an input module in a similar style to
* https://golem.hu/board/Choctopus44-439.html
* https://golem.hu/board/Zephirum-440.html

carcinization, 2023-03-24:
the question i have is more "what parts are going to be used in the keyboard it deploys with?" because if they open up that information, that will make it easier for us to just remix that design without worrying about sourcing new parts to fit and reinventing the wheel. obviously the keyboard it deploys with probably won't be mechanical, but I figure it's more important to have flexibility of layout than having the actual mechanical switches. plus then we could re-use the keycaps from the original keyboard module!

eclecticc, 2023-04-15:
Closing this since it isn't addressable within this repository.  There is ongoing discussion around keyswitches in the Framework Community: https://community.frame.work/t/input-module-keyboard-switches/28294/8

Closed 2023-04-15.

Thread 3 (2023-07-22):

SK6812MINI-E Logic Voltage

jyancat, 2023-07-22:
In [https://github.com/FrameworkComputer/InputModules/tree/main/Electrical/MicrocontrollerInputModule](url) there is a SK6812MINI-E RGB LED driven by 3V3 logic, while this probably will work it's not optimal, better to add a level shifter (up to 5V logic) or note this in the folder readme.

cscott, 2024-01-24:
The datasheet specifies that VIH is "3.4V typical" so yeah, this is technically operating the SK6812 out of spec.
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

cscott, 2024-07-10:
A 74LVC1G34GW would be a compact solution.

JohnAZoidberg, 2024-10-13:
> this probably will work

You're right, it does work :D

This really is just a quick and dirty reference that's not supposed to be used for anything and also supposed to be as simple as possible.
We made a couple test boards to see if it works, but nothing more.

So if you could make a PR to add a level shifter that would be great.
Otherwise I think we'll just add a comment to the README noting that the design is functional but perhaps not optimal.

Thread 4 (2023-09-08):

Empty PCB file for LED Matrix

corndog2000, 2023-09-08:
The PCB file in the Kicad project Electrical->LEDMatrix is empty. The schematic looks fine. But, opening the PCB file just shows a blank drawing.

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

CyrilSLi, 2025-01-01:
I suppose this is intentional.. read the [raw file](https://github.com/FrameworkComputer/InputModules/blob/main/Electrical/LEDMatrix/LEDMatrix.kicad_pcb
), there isn't any useful data in there :/

Thread 6 (2024-01-23):

BOARD_ID resistor definitions

cscott, 2024-01-23:
Under "Pinout", the [README.md](https://github.com/FrameworkComputer/InputModules#pinout) says,
> 4 	BOARD_ID 	Pull to GND through BOARD_ID resistor defined below

but the BOARD_ID resistor values aren't actually defined anywhere in the repo.

I'm particularly interested in knowing how many of the 8 different pogo pin groups need to be connected in order for the BIOS to be happy.  To pick two specific examples: if I created a "double height" keyboard+touchpad module, but left all four side spacers in place, would I need two different pogo pin pads, or could I do with just one and a "this is really two modules" resistor value?

cscott, 2024-01-24:
For anyone wondering, the "microcontroller" example has a 180k resistor from BOARD_ID to ground, so that's apparently the correct value for a "small" module.  No info yet on appropriate values for other size modules.

eclecticc, 2024-01-30:
Added in https://github.com/FrameworkComputer/InputModules/commit/8348517b89d8de535c8a948ec6aa91f2cee6927c

cscott, 2024-01-31:
And for my second question above, I'm guessing that if I have a big "keyboard plus touchpad" module I'd need two separate pogo pads with two separate resistors, one for the "keyboard" and another for the "touchpad"?

eclecticc, 2024-01-31:
Yes, as currently defined.  That is something we could define in the future
though.

On Wed, Jan 31, 2024 at 8:07 AM C. Scott Ananian ***@***.***>
wrote:

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

Closed 2024-01-30.

Thread 7 (2024-01-31):

STEP file for midplate

cscott, 2024-01-31:
It would be incredible helpful for test-fitting input modules to have a STEP model of the [Framework 16 midplate](https://frame.work/products/16-mid-plate-kit) in this repository.

That could be imported into CAD along with the 3d model emitted by kicad, etc, to allow virtually test fitting modules, or else 3d printed to make a handy mockup to physically test prototypes against.

Thread 8 (2024-01-31):

Pinout and design files for trackpoint module

cscott, 2024-01-31:
I'm working on a "double-height" keyboard module that will replace both the keyboard and the touchpad module.  [We don't have any documentation on the touchpad module](https://community.frame.work/t/mechanical-electrical-specs-for-touchpad-module/40833) other than that it has a [different pinout than the other modules](https://community.frame.work/t/input-module-placement-qs/34494/2) and [the board ID resistor value](https://github.com/FrameworkComputer/InputModules/issues/6).

Even just knowing where the board ID and GND pins were on the touchpad module (the same as for the input modules? or different?) would help my particular use case, since I just want to assure the FW16 EC that the touchpad is "present".

eclecticc, 2024-02-01:
https://github.com/FrameworkComputer/InputModules/commit/02588e58b65d8cc1fac26795650c8f1eb097ab79

cscott, 2024-02-01:
Fantastic!  I think the final image there might be flipped, though, as described here: https://community.frame.work/t/input-module-placement-qs/34494/6

Closed 2024-02-01.

Thread 10 (2024-02-02):

I2C protocol for touchpad module

cscott, 2024-02-02:
Again, thanks so much for the information provided in #8.

There have been requests to create [alternate touchpads](https://community.frame.work/t/touchpad-with-2-buttons-instead-of-clickpad/36343), and the missing piece to do this (other than #9, the mechanical specs) would be details of the I2C protocol spoken by the touchpad.  There is a "[HID over I2C](https://github.com/torvalds/linux/blob/master/drivers/hid/i2c-hid/i2c-hid-core.c)" thing, and if that's what's going on here than probably just stating so would be enough.  If its a bespoke protocol, then we'd probably need the datasheet for the stock touchpad used in the FW16 so we could emulate it properly.

JohnAZoidberg, 2024-10-13:
I2C is connected to the CPU, so you can do whatever you want, as long as you have an OS driver that supports it.
Our modules do HID over I2C (on Framework 16 but also on Framework 13).
I see you came to the same conclusion already :smiley:  https://community.frame.work/t/touchpad-with-2-buttons-instead-of-clickpad/36343/18?u=daniel_schaefer
Sorry the the late response.

The same I2C bus is also connected to the EC. So that if you boot to your OS without the touchpad connected, the EC will pretend to be a touchpad. This is so that the windows driver won't freak out. See https://github.com/FrameworkComputer/EmbeddedController/commit/9d49389919c36e44e451514b8278b9eb7ee6ed1e

Closed 2024-11-20.

Thread 9 (2024-02-02):

Mechanical drawings for touchpad module

cscott, 2024-02-02:
Thank you so much for the touchpad electrical specs requested in issue #8!

Just for tracking purposes, I'm opening this task for the mechanical information about the touchpad module, which is all that is now missing to be able to make a "blank spacer" type touchpad module, or to make a "double-height" keyboard module.  This sort of overlaps with issue #7, in that with drawings for the midplate one could probably figure this out, but it would be nice to have drawings of the touchpad module with the same level of detail as were given for the small and medium input modules.

Thread 14 (2024-07-11):

Off by 0.1mm in allowed thickness calculations for input module

cscott, 2024-07-11:
Between the spacer dimensions in `Mechanical/Small/Module/c1_design_space_ref.pdf` and the PCB limit area dimensions in `Mechanical/Small/PCB/c1_pcb_concept_design_ref.pdf` there appears to be an "off by 0.1mm" error, caused by double-counting the 0.1mm difference between the nominal 0.9mm thickness of the top edge alignment feature and the 0.8mm thickness of the PCB (and this applies also for the "1.0 mm thick PCB" variant, which appears to be based on the 0.8mm thick PCB and assumes the top edge of the PCB is milled down 0.2mm, and so inherits the mistake from the 0.8mm PCB design).

There appears to be /second/ 0.1mm of "clearance" in the PCB design.

Apologies for lack of a diagram, here's the pure math.  Starting from the non-PCB design, which appears to match the actual production spacer hardware I have in measuring 2.35mm thick at the top edge, with an alignment feature 0.9mm thick, and installed it sits flush with the keyboard lattice.  Starting from the midplate and working up, that 2.35mm of thickness is divided up as:

* 0.50mm below the top edge alignment feature
* 0.90mm for the top edge alignment feature
* 0.95mm above the top edge alignment feature

The stack up for the PCB design *should* be, I believe:
* 0.1mm of "clearance" below bottom-side components **<- this is not indicated**
* 0.4mm for bottom-side components
* 0.8mm for the PCB, sitting flush to the bottom of the 0.9mm allowance for the alignment feature
* 1.05mm above the top of the PCB **<- this is the error, it is marked as 0.95mm**

If you expected the PCB to sit flush with the *top* of the 0.9mm allowance for the alignment feature, then the stackup would be:
* 0.1mm of "clearance" below bottom-side components
* 0.5mm for bottom side components **<- this would be the error in this case**
* 0.8mm for the PCB, sitting flush to the *top* of the 0.9mm allowance for the alignment feature
* 0.95mm above the top of the PCB

This second option is less desirable as most folks are concerned with maximizing the availability of space on the top side of the PCB.  It could be presented as an alternative if additional space for bottom-side components were useful.

It seems that the root cause here was not taking account the 0.1mm thickness difference between the 0.8mm PCB and the nominal 0.9mm alignment feature in recomputing the top side allowances.

The "0.1mm of clearance below bottom side components" is also not clearly marked on the PCB-concept drawings, but is easily inferred from the "0.5t spacer" which *is* marked.  If the spacer is 0.5mm tall and there is only 0.4mm height allowance for bottom-side components, the difference must be due to an undocumented clearance provided; especially since the non-PCB CAD drawing clearly indicates 0.5mm thickness below the alignment feature for that entire portion.

I'm certain this is splitting hairs, but I'm posting this in case it helps other folks staring at the top sets of CAD design files and trying to make the numbers add up.  The allowed thickness above the PCB has been a recurrent concern for input module design (especially in the keyboard area!) so I'm sure the additional 0.1mm will be welcomed by some. :)  Certainly I'd appreciate confirmation that my understanding is correct.

cscott, 2024-07-11:
(If my understanding is correct, there's another interesting PCB stackup as well which would provide an additional 0.4mm assuming no bottom-side components in the top portion of the input module: a 0.4mm PCB (still readily commercially available) could sit *below* two additional PCBs attached with (say) castellated edges: a 0.8mm PCB layered at the top edge would engage the alignment mechanism, and a 0.4mm-1.8mm (!) PCB layered on the bottom edge would contain the pogo pin pads.  I might explore that for my keyboard stackups.  But that's a latent feature to be discovered, not a bug! :) )
