FrameworkComputer/InputModules/OneKeyModule/Mechanical/one_key_module_ref.pdf

A | B | C | D | E

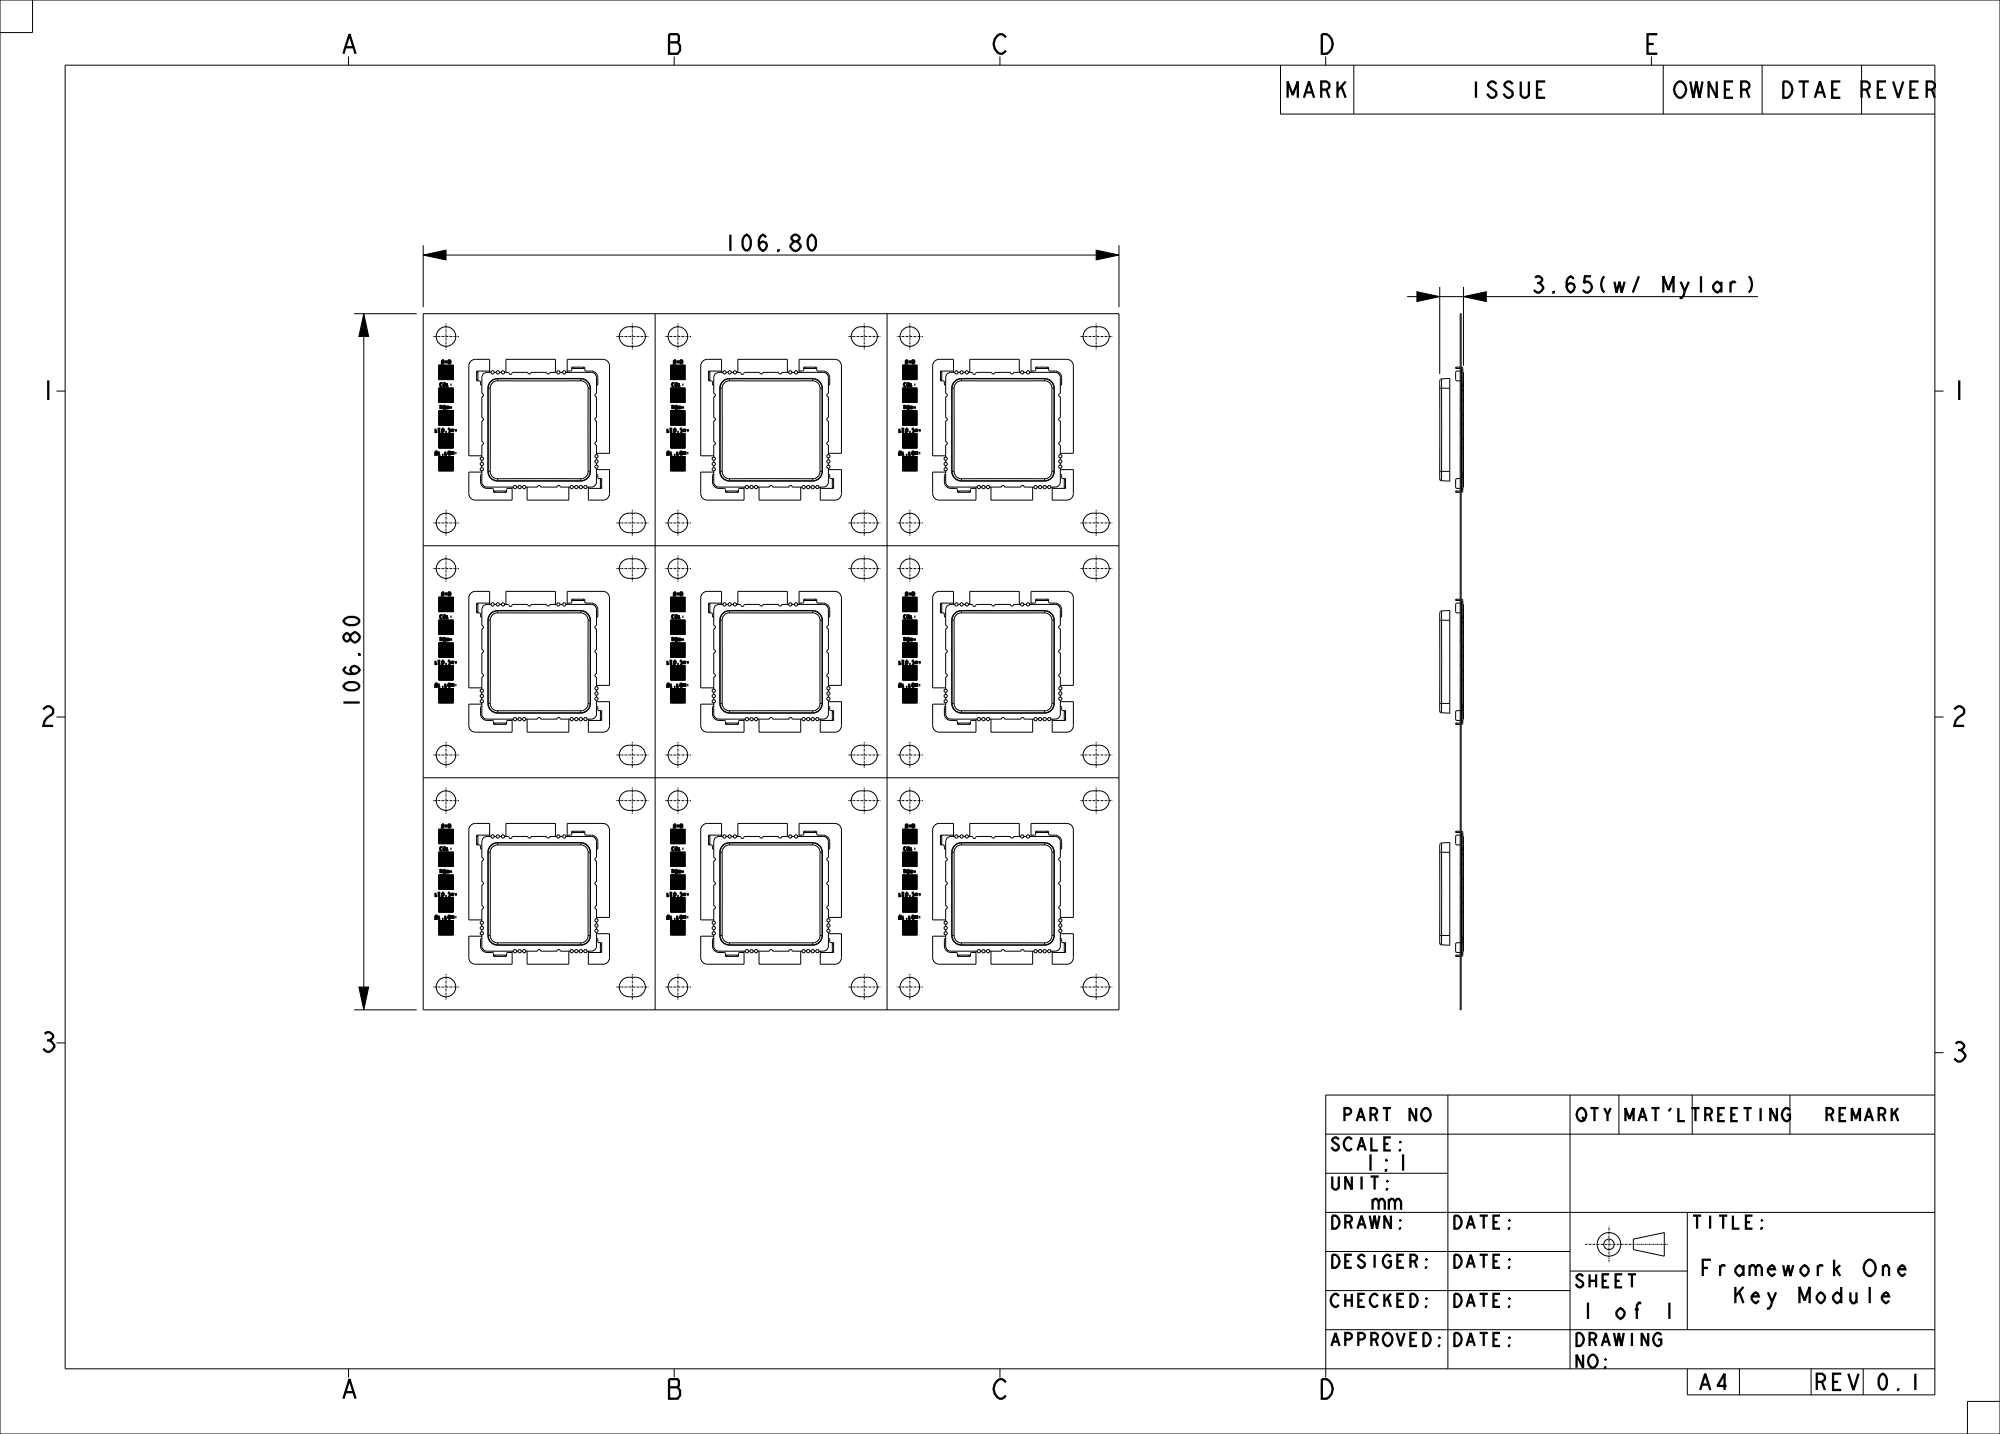
[picture p23: page 1]
3.65(w/ Mylar); DIO; COL-; ROW+; LED_5V+; BL_LOW-; UNIT:; SHEET; REV A; MARK; ISSUE; OWNER; DTAE REVER; Key Module

PART NO | QTY | MAT'L TREETING | REMARK
SCALE:

DRAWN: | DATE: | | TITLE: Framework One
DESIGER: | DATE:
CHECKED: | DATE:
APPROVED: | DATE: | DRAWING

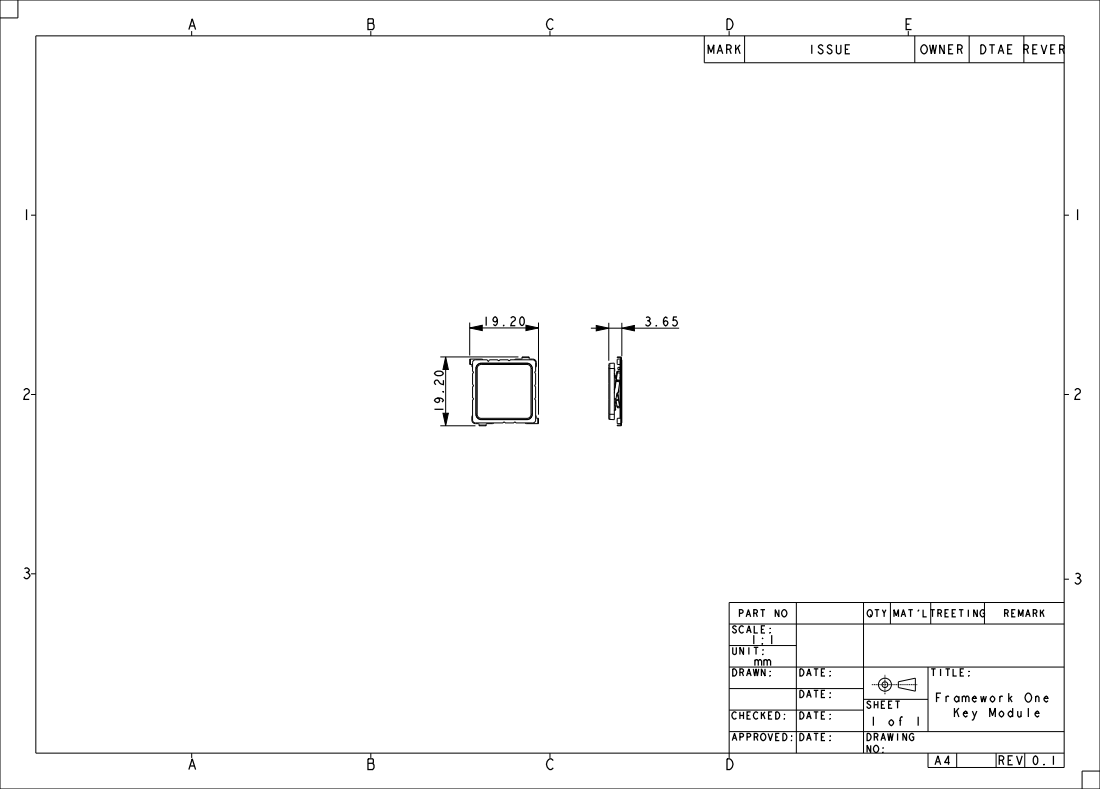
[picture p24: page 2]
UNIT:; SHEET; Key Module

PART NO | QTY | MAT'L TREETING | REMARK
SCALE:

DRAWN: | DATE: | TITLE: Framework One

DATE:

CHECKED: | DATE:

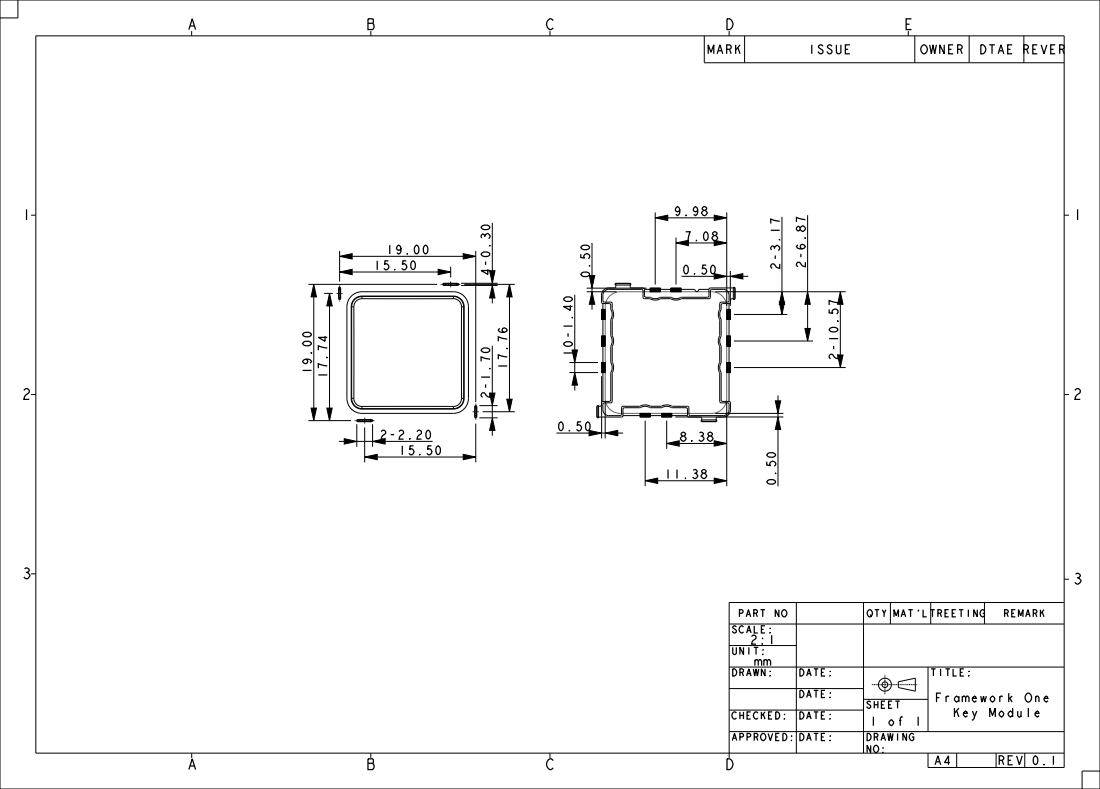
[picture p25: page 3]
UNIT:; SHEET; Key Module

PART NO | QTY | MAT'L TREETING | REMARK
SCALE:

DRAWN: | DATE: | TITLE: Framework One

DATE:

CHECKED: | DATE:
