FrameworkComputer/InputModules/Mechanical/Large/a1_module_design_ref_00.pdf

2

1

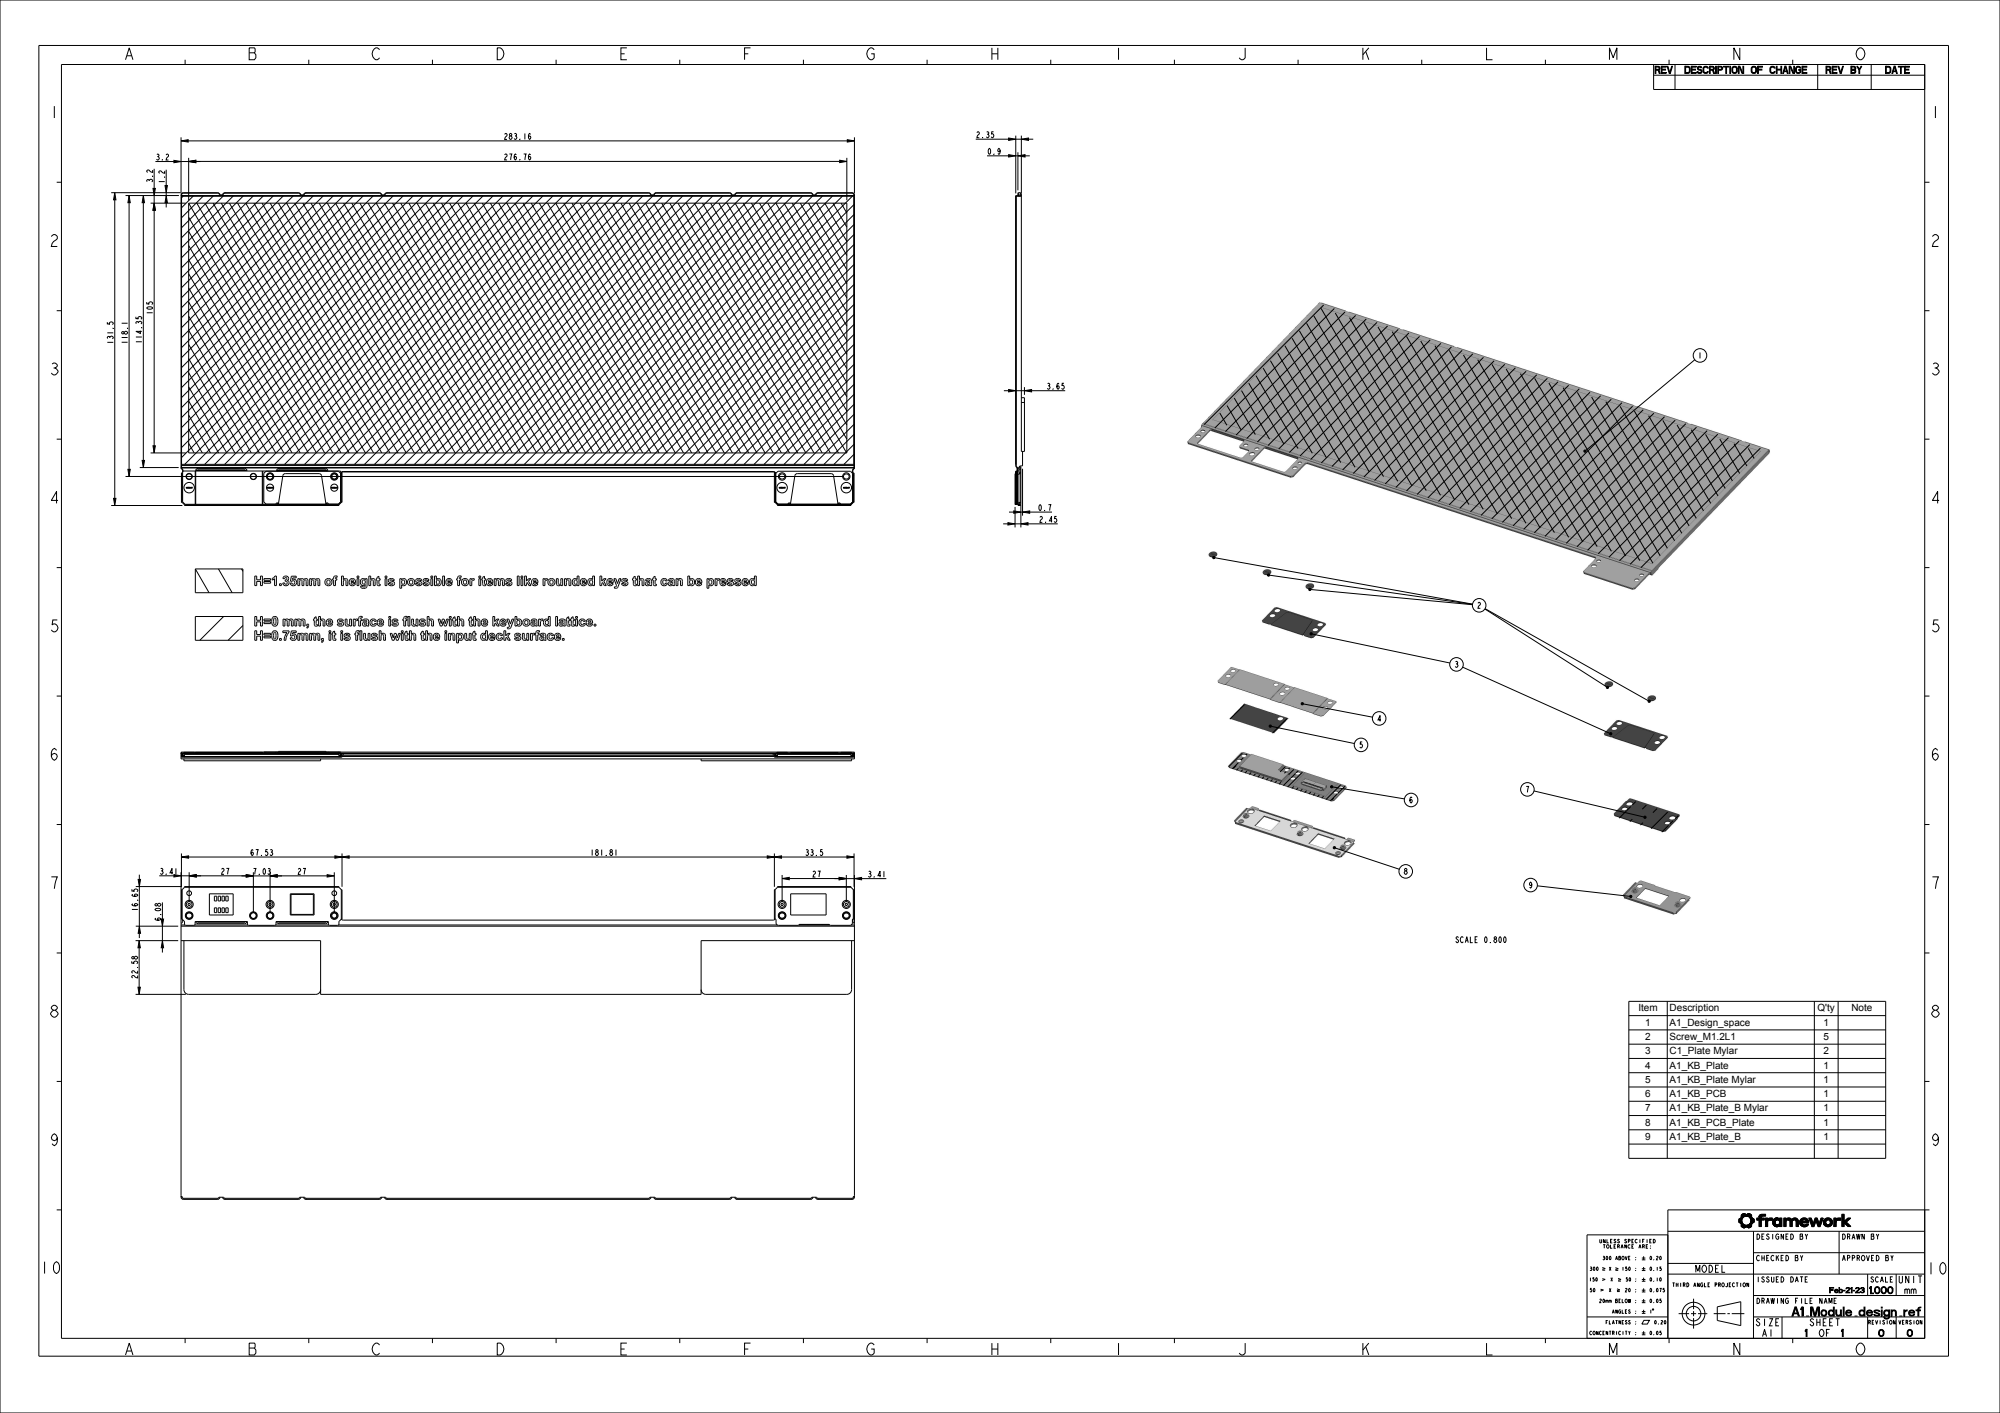
[picture p26: page 1]
MODEL; Feb-21-231.000; SIZE; SHEET; REVISION; VERSION; REV; DESCRIPTION OF CHANGE; DATE; UNLESS SPECIFIED TOLERANCE ARE:; 300 ABOVE :; 20mm BELOW :; ANGLES :; FLATNESS :; CONCENTRICITY :; SCALE 0.800

Item | Description | Q'ty | Note
1 | A1_Design_space | 1
2 | Screw_M1.2L1 | 5
3 | C1_Plate Mylar | 2
4 | A1_KB_Plate | 1
5 | A1_KB_Plate Mylar | 1
6 | A1_KB_PCB | 1
7 | A1_KB_Plate_B Mylar | 1
8 | A1_KB_PCB_Plate | 1
9 | A1_KB_Plate_B | 1

DESIGNED BY | DRAWN BY
CHECKED BY | APPROVED BY

THIRD ANGLE PROJECTION | | ISSUED DATE | SCALE | UNIT

DRAWING FILE NAME
A1_Module_design_ref
