FrameworkComputer/InputModules/Mechanical/Medium/fw_b_size_design_ref_0.pdf

1

2

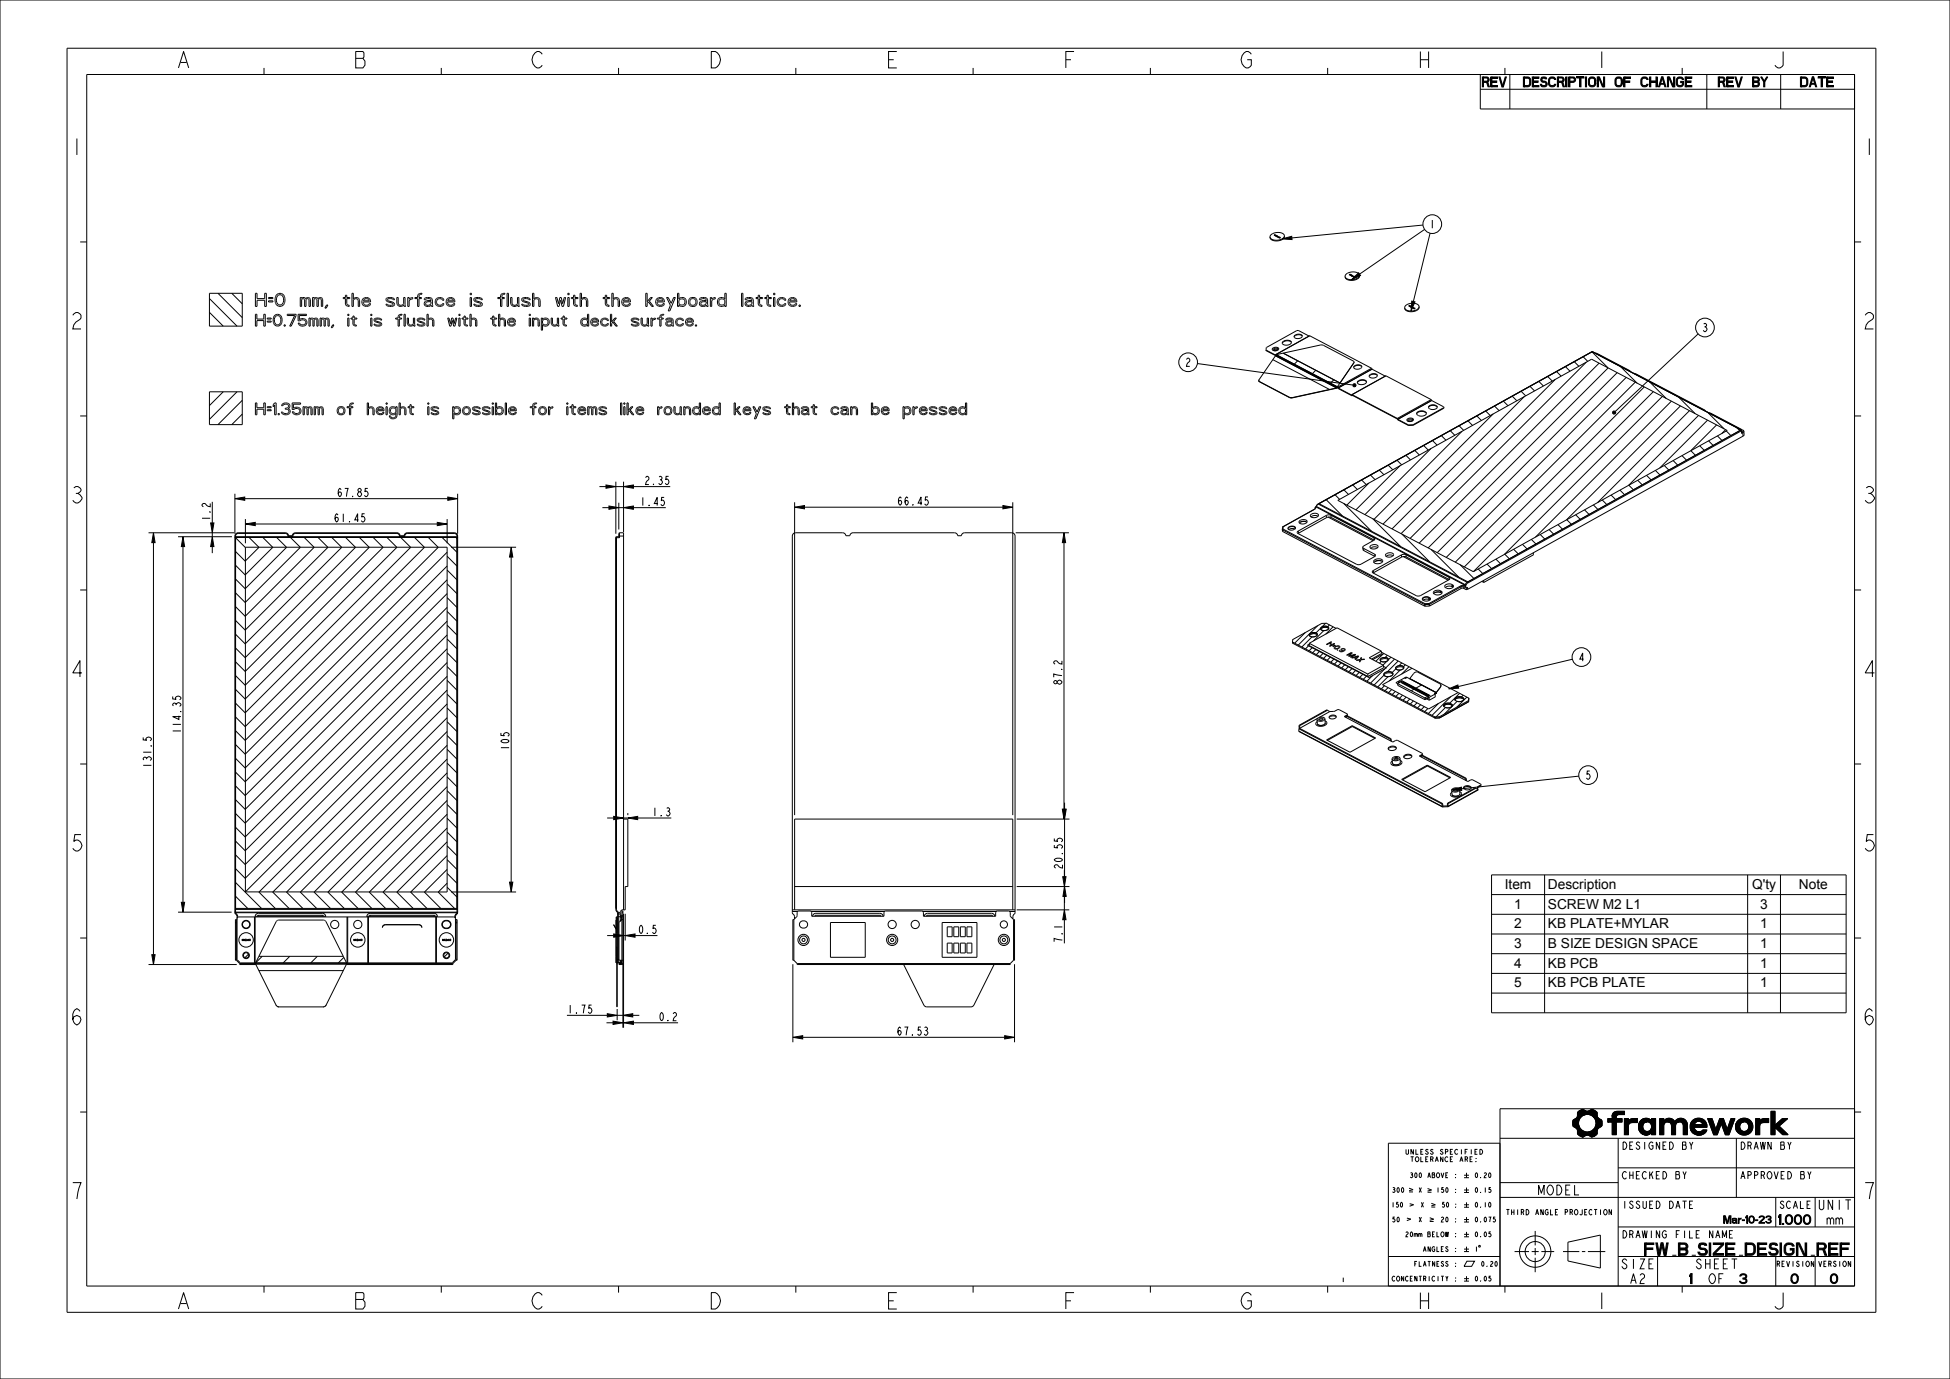
[picture p27: page 1]
REV; DESCRIPTION OF CHANGE; DATE; MODEL; SIZE; SHEET; REVISION; VERSION; UNLESS SPECIFIED TOLERANCE ARE:; 300 ABOVE :; 20mm BELOW :; ANGLES :; FLATNESS :; CONCENTRICITY :

Item | Description | Q'ty | Note
1 | SCREW M2 L1 | 3
2 | KB PLATE+MYLAR | 1
3 | B SIZE DESIGN SPACE | 1
4 | KB PCB | 1
5 | KB PCB PLATE | 1

DESIGNED BY | DRAWN BY
CHECKED BY | APPROVED BY

THIRD ANGLE PROJECTION | | ISSUED DATE Mar-10-231.000 mm | SCALE | UNIT

DRAWING FILE NAME
FW_B_SIZE_DESIGN_REF

1

2

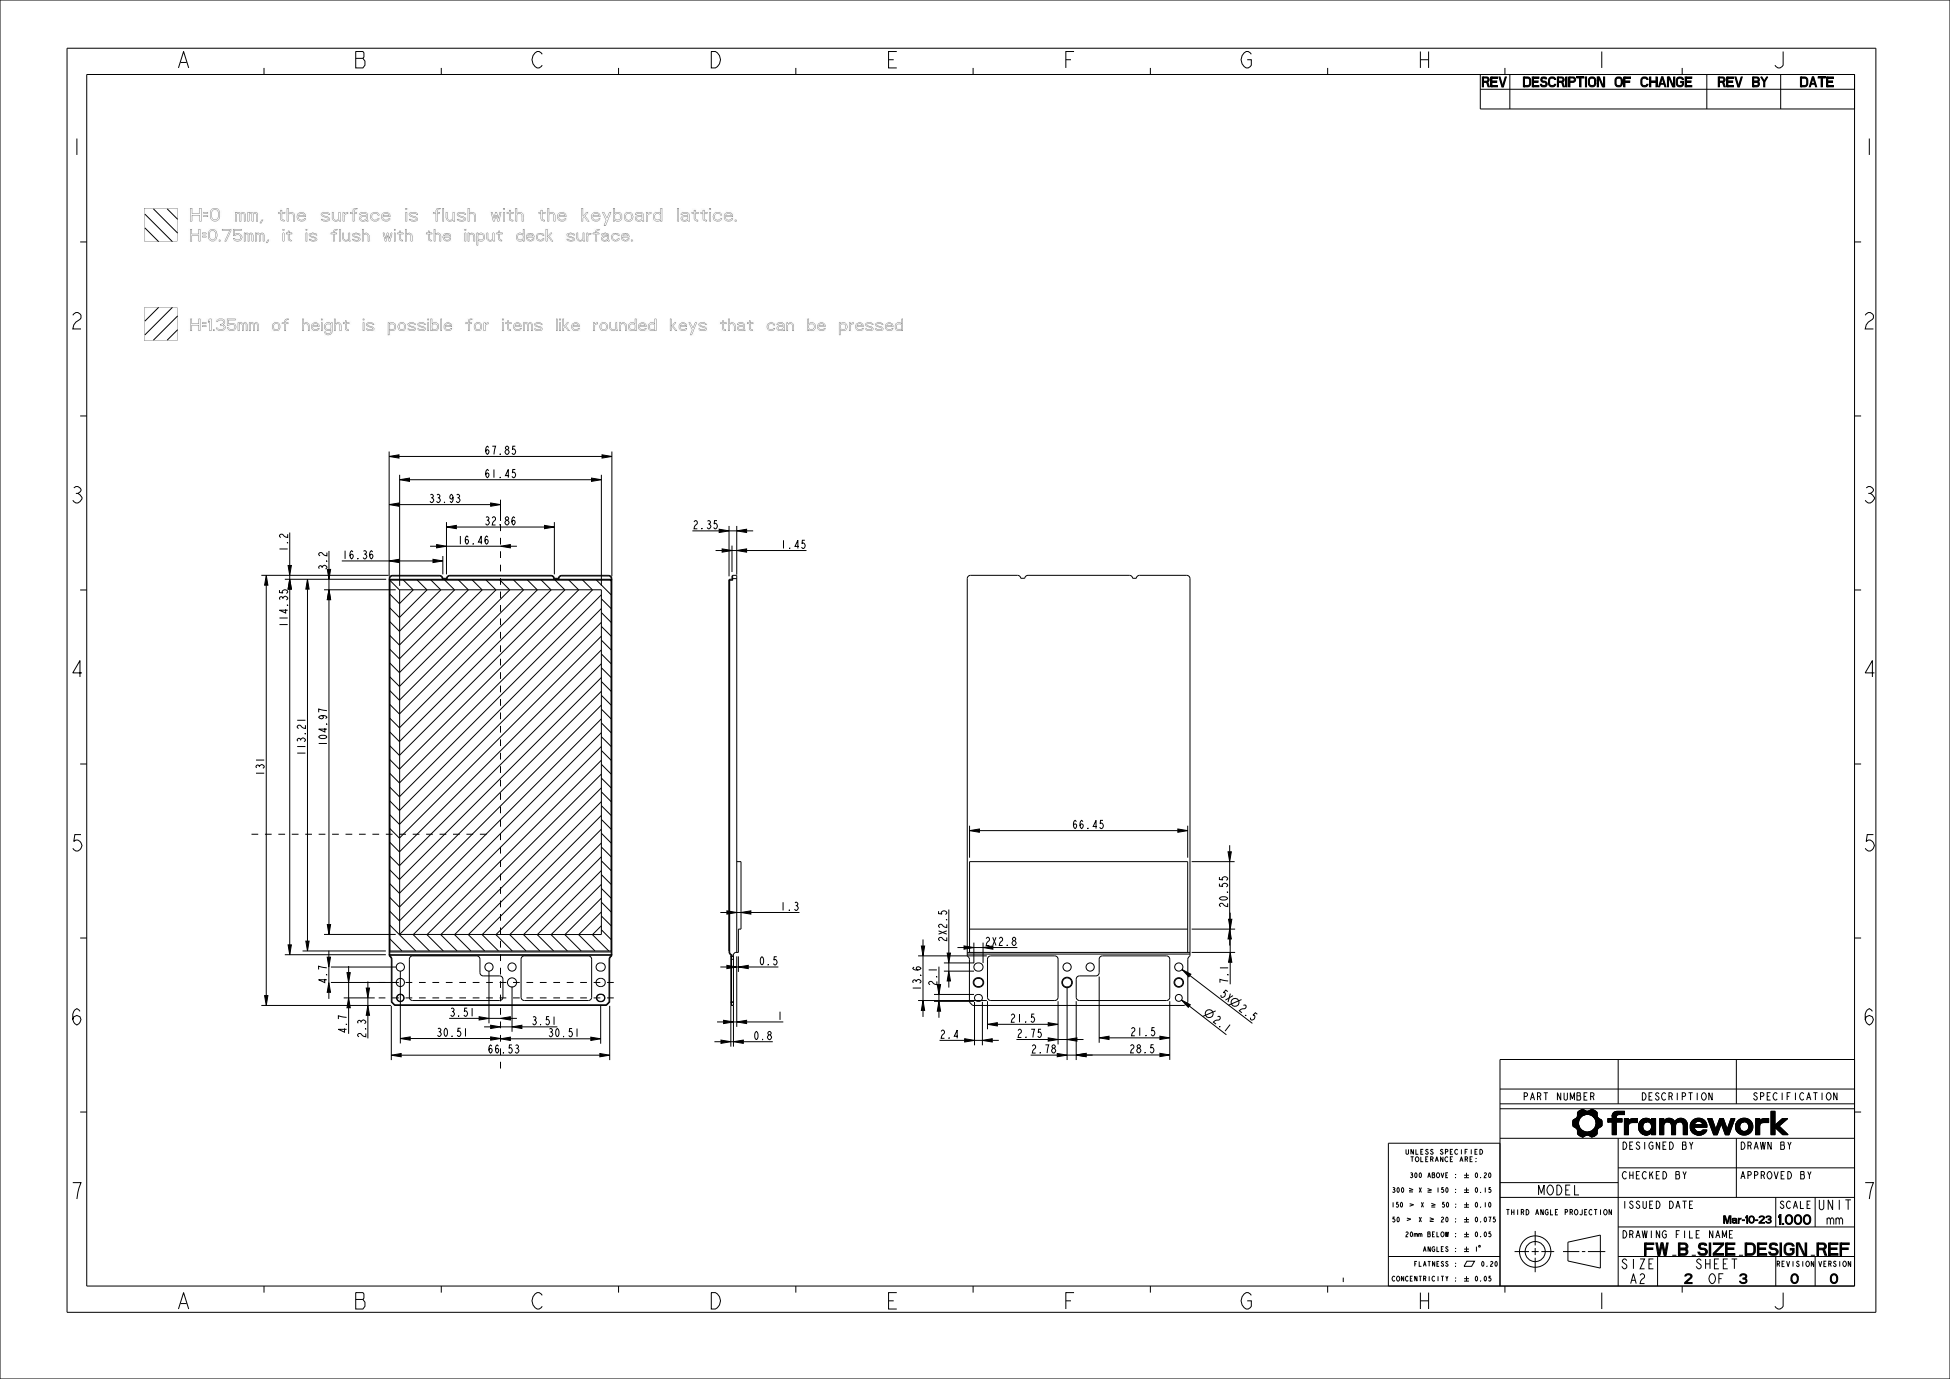
[picture p28: page 2]
PART NUMBER; DESCRIPTION; SPECIFICATION; MODEL; UNLESS SPECIFIED TOLERANCE ARE:; 300 ABOVE :; 20mm BELOW :; ANGLES :

DESIGNED BY | DRAWN BY
CHECKED BY | APPROVED BY

THIRD ANGLE PROJECTION | | ISSUED DATE Mar-10-231.000 mm | SCALE | UNIT

DRAWING FILE NAME
FW_B_SIZE_DESIGN_REF

1

2

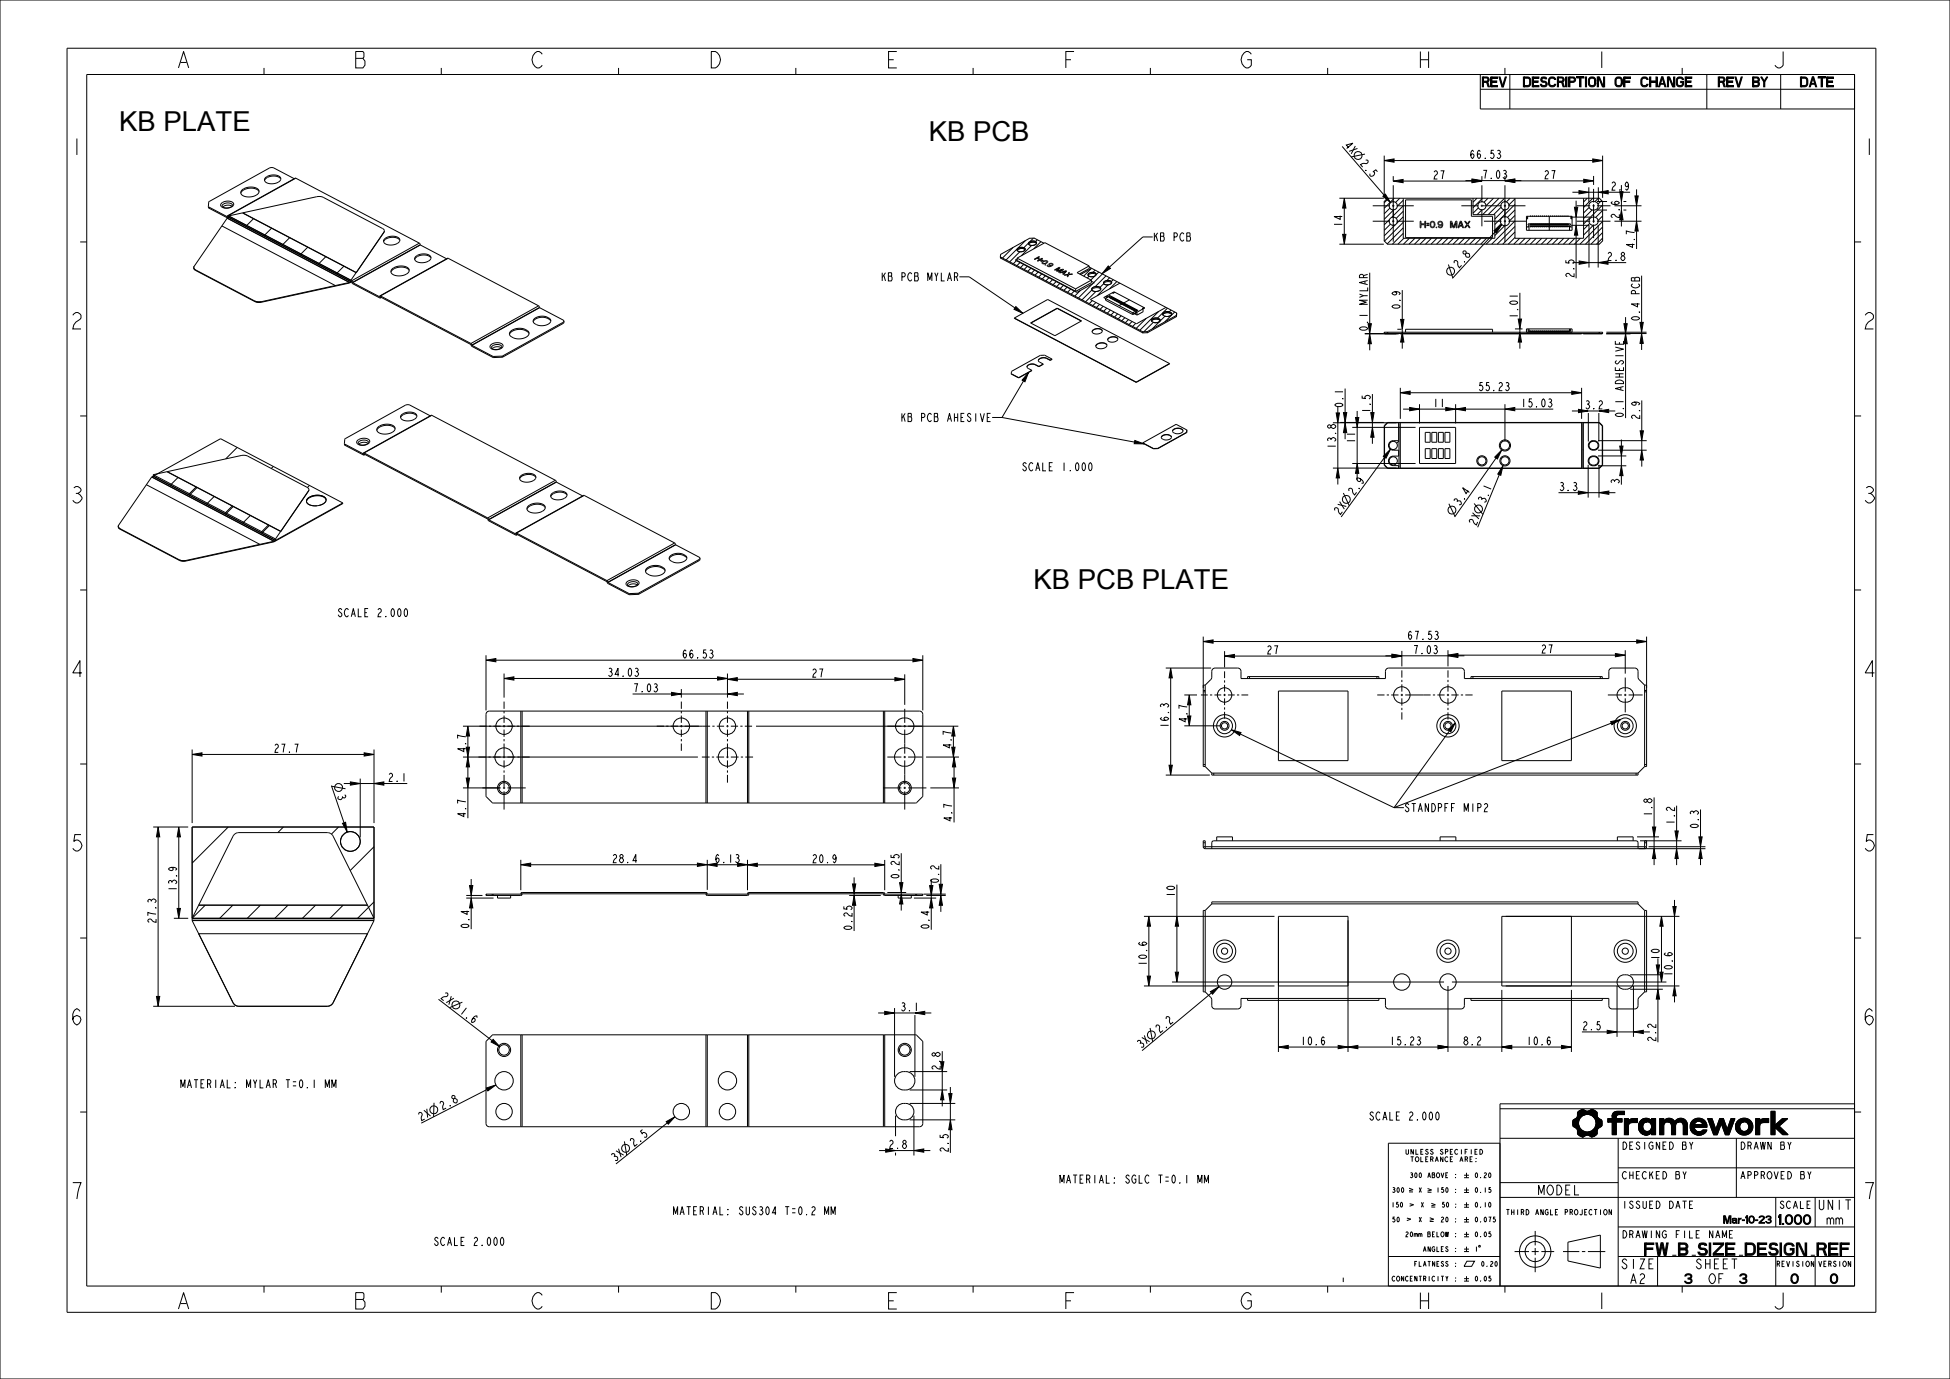
[picture p29: page 3]
4.7 0.4 PCB; 0.1 ADHESIVE; 0.1 MYLAR; MODEL; UNLESS SPECIFIED TOLERANCE ARE:; 300 ABOVE :; 20mm BELOW :; ANGLES :; MATERIAL: MYLAR T=0.1; MATERIAL: SUS304 T=0.2 MM; MATERIAL: SGLC T=0.1; SCALE 2.000; SCALE 1.000; KB PCB; STANDPFF M1P2; KB PLATE

KB PCB MYLAR

KB PCB AHESIVE

KB PCB PLATE

DESIGNED BY | DRAWN BY
CHECKED BY | APPROVED BY

THIRD ANGLE PROJECTION | | ISSUED DATE Mar-10-231.000 mm | SCALE | UNIT

DRAWING FILE NAME
FW_B_SIZE_DESIGN_REF
