FrameworkComputer/InputModules/Mechanical/Small/Module/c1_design_space_ref.pdf

A

1

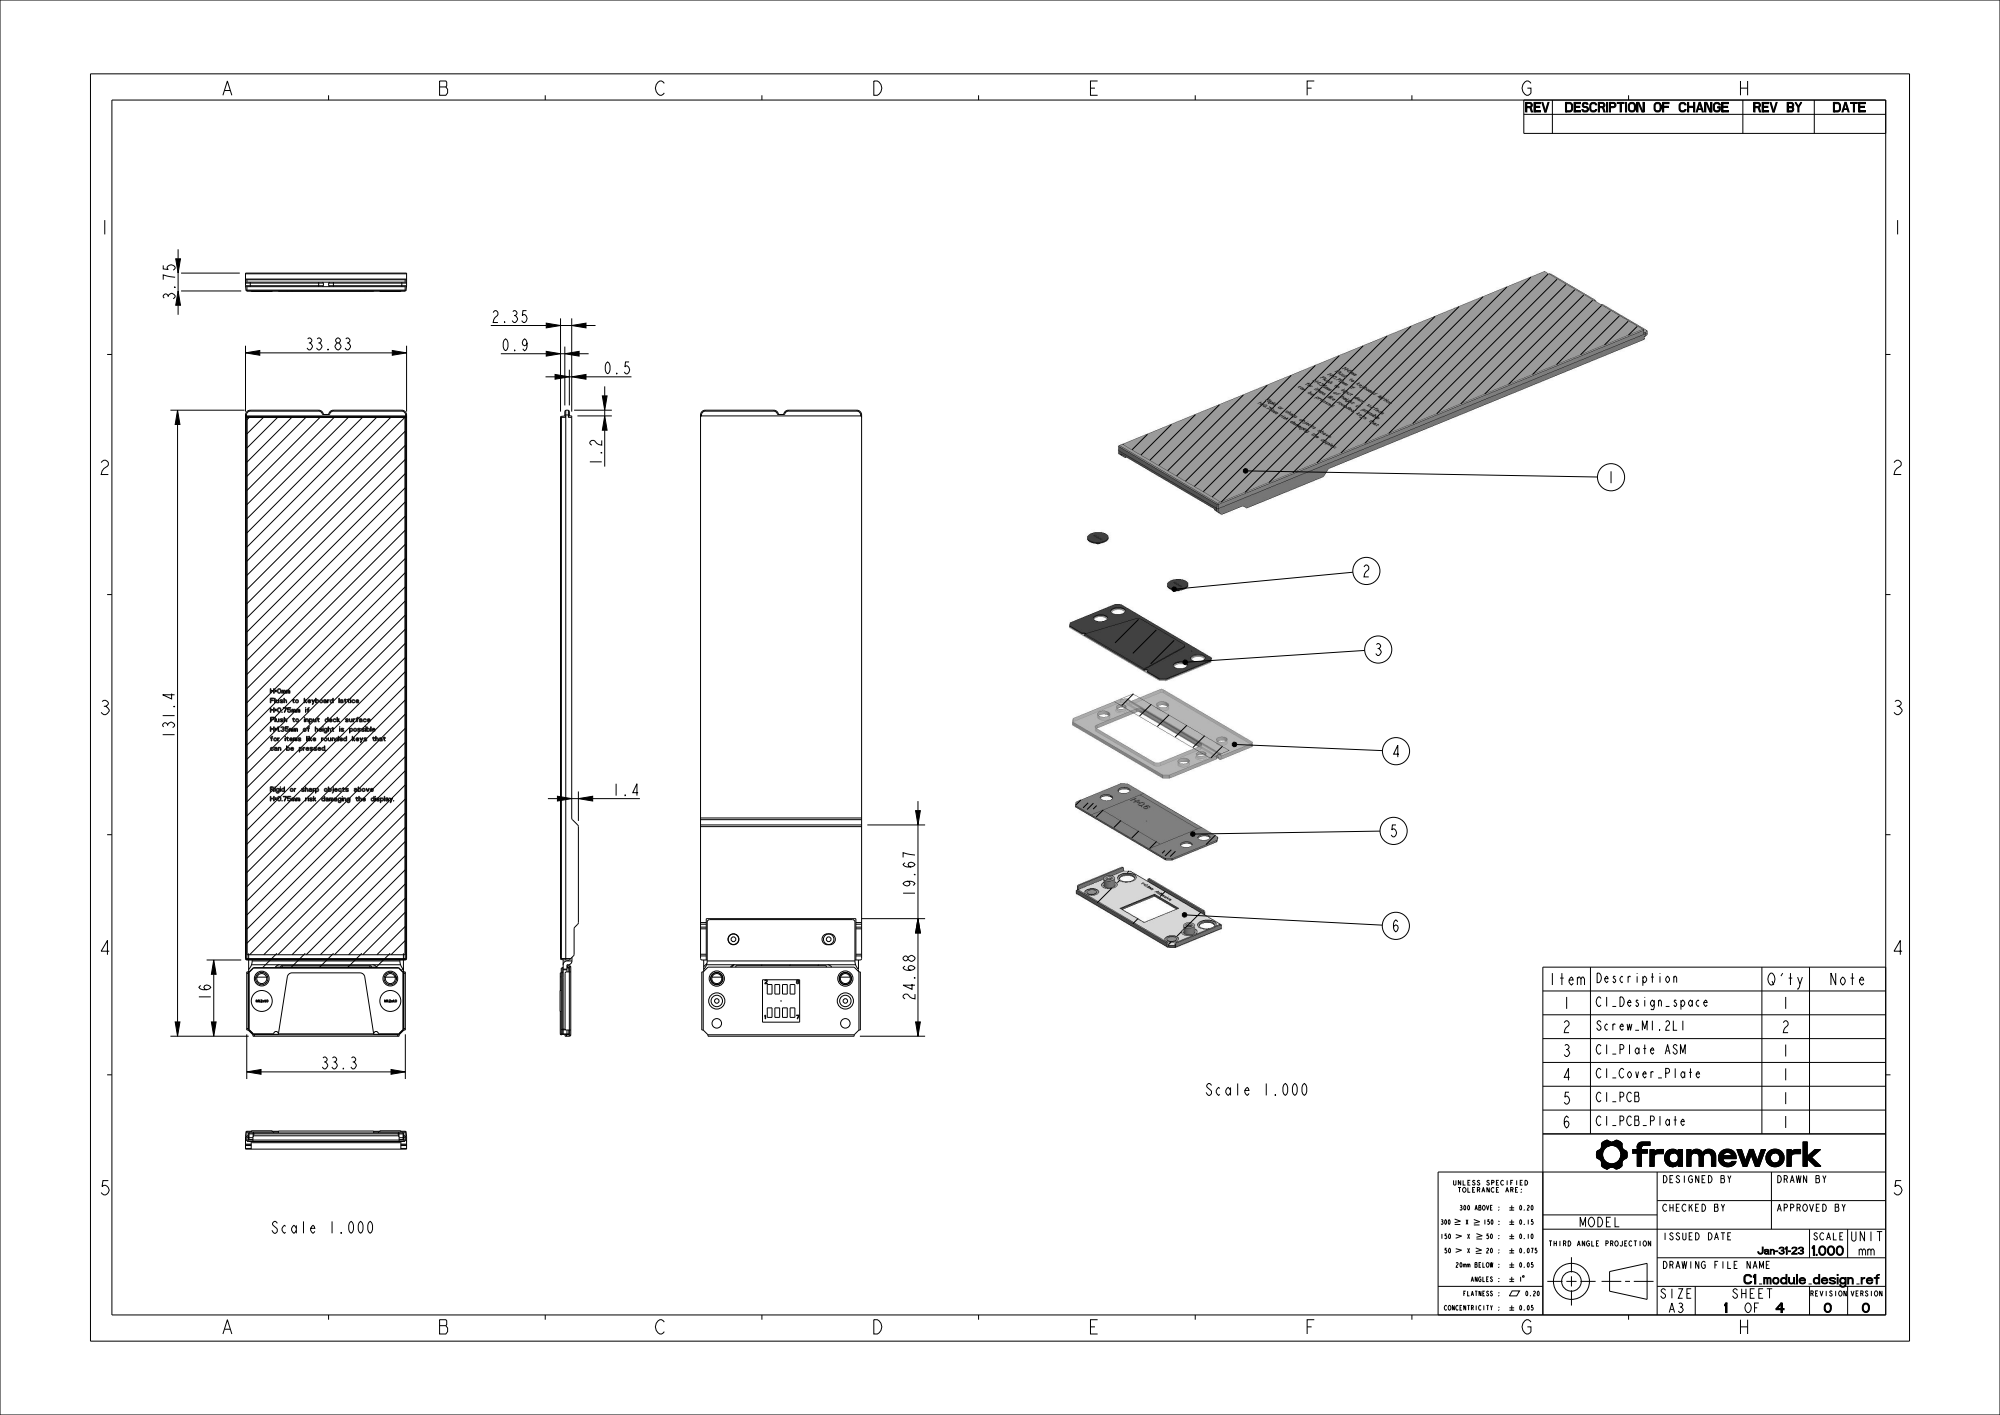
[picture p30: page 1]
REV; DESCRIPTION OF CHANGEREV BY; DATE; MODEL; THIRD ANGLE PROJECTIONISSUED DATE; SCALEUNIT; C1_module_design_ref; SIZE; SHEET; REVISION VERSION; FLATNESS :; CONCENTRICITY : 0.05; Item; Description; Note; C1_Design_space; Screw_M1.2L1; C1_Plate ASM; C1_Cover_Plate; Scale

5 | C1_PCB | 1
6 | C1_PCB_Plate | | 1

UNLESS SPECIFIED TOLERANCE ARE: 300 ABOVE : 0.20 300 X 150 : 0.15 150 X 50 : 0.10 50 X 20 : 0.075 20mm BELOW : 0.05 ANGLES : 1 | | DESIGNED BY | DRAWN BY

CHECKED BY | APPROVED BY

Jan-31-23 | 1.000 | mm

DRAWING FILE NAME

1

1

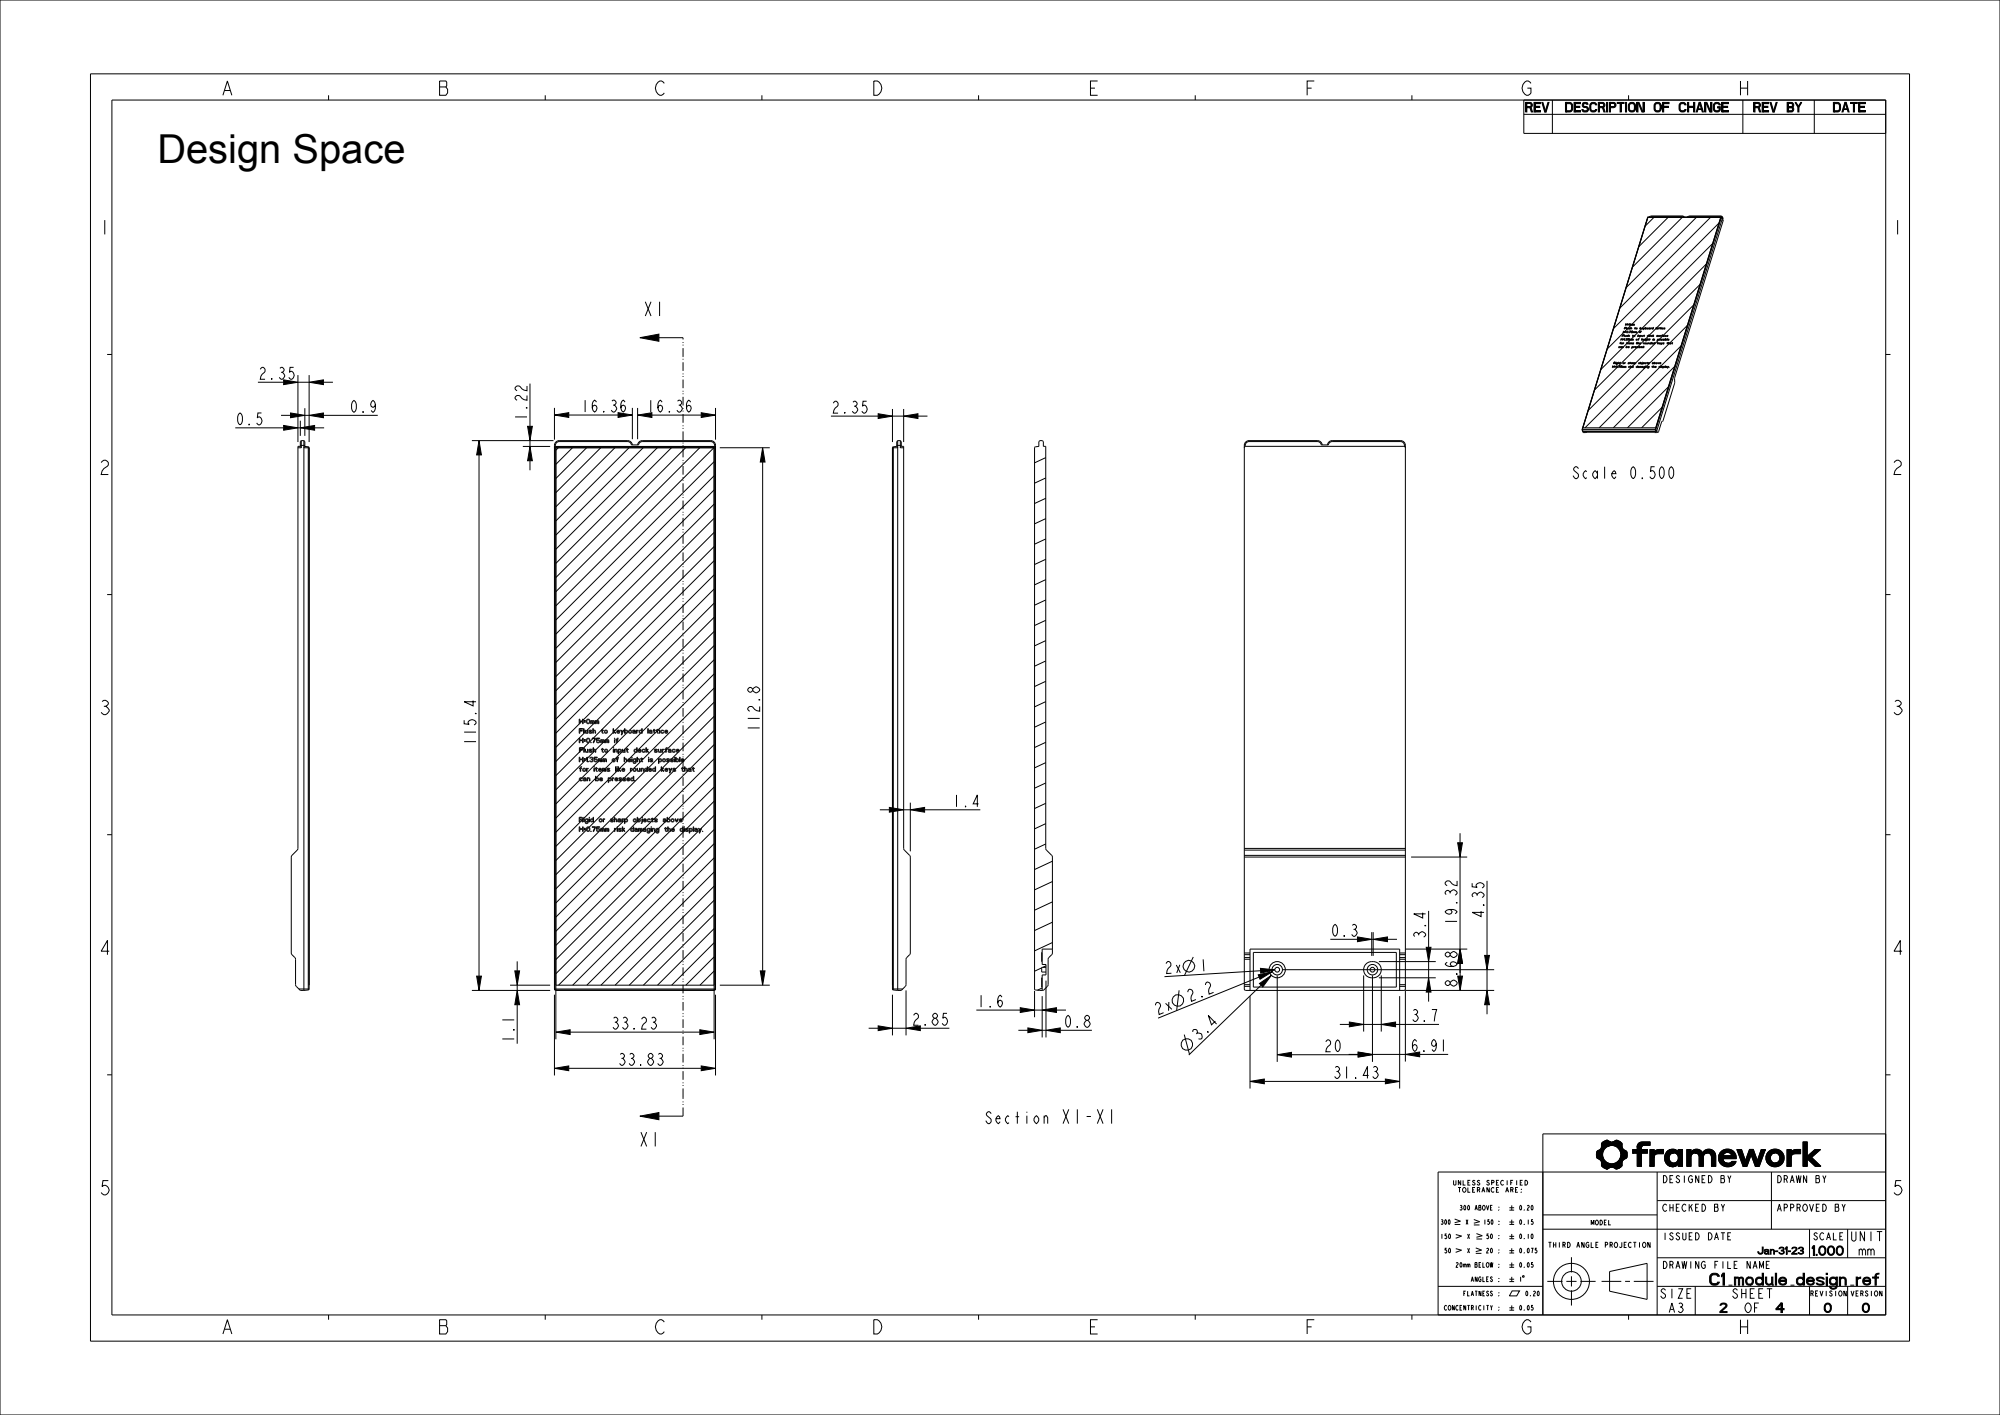
[picture p31: page 2]
MODEL; ISSUED DATE; SCALEUNIT; SIZE; SHEET; REVISION VERSION; Scale 0.500; Section; Design Space

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

CHECKED BY | APPROVED BY

THIRD ANGLE PROJECTION | Jan-31-23 | 1.000 | mm

DRAWING FILE NAME
C1_module_design_ref

1

1

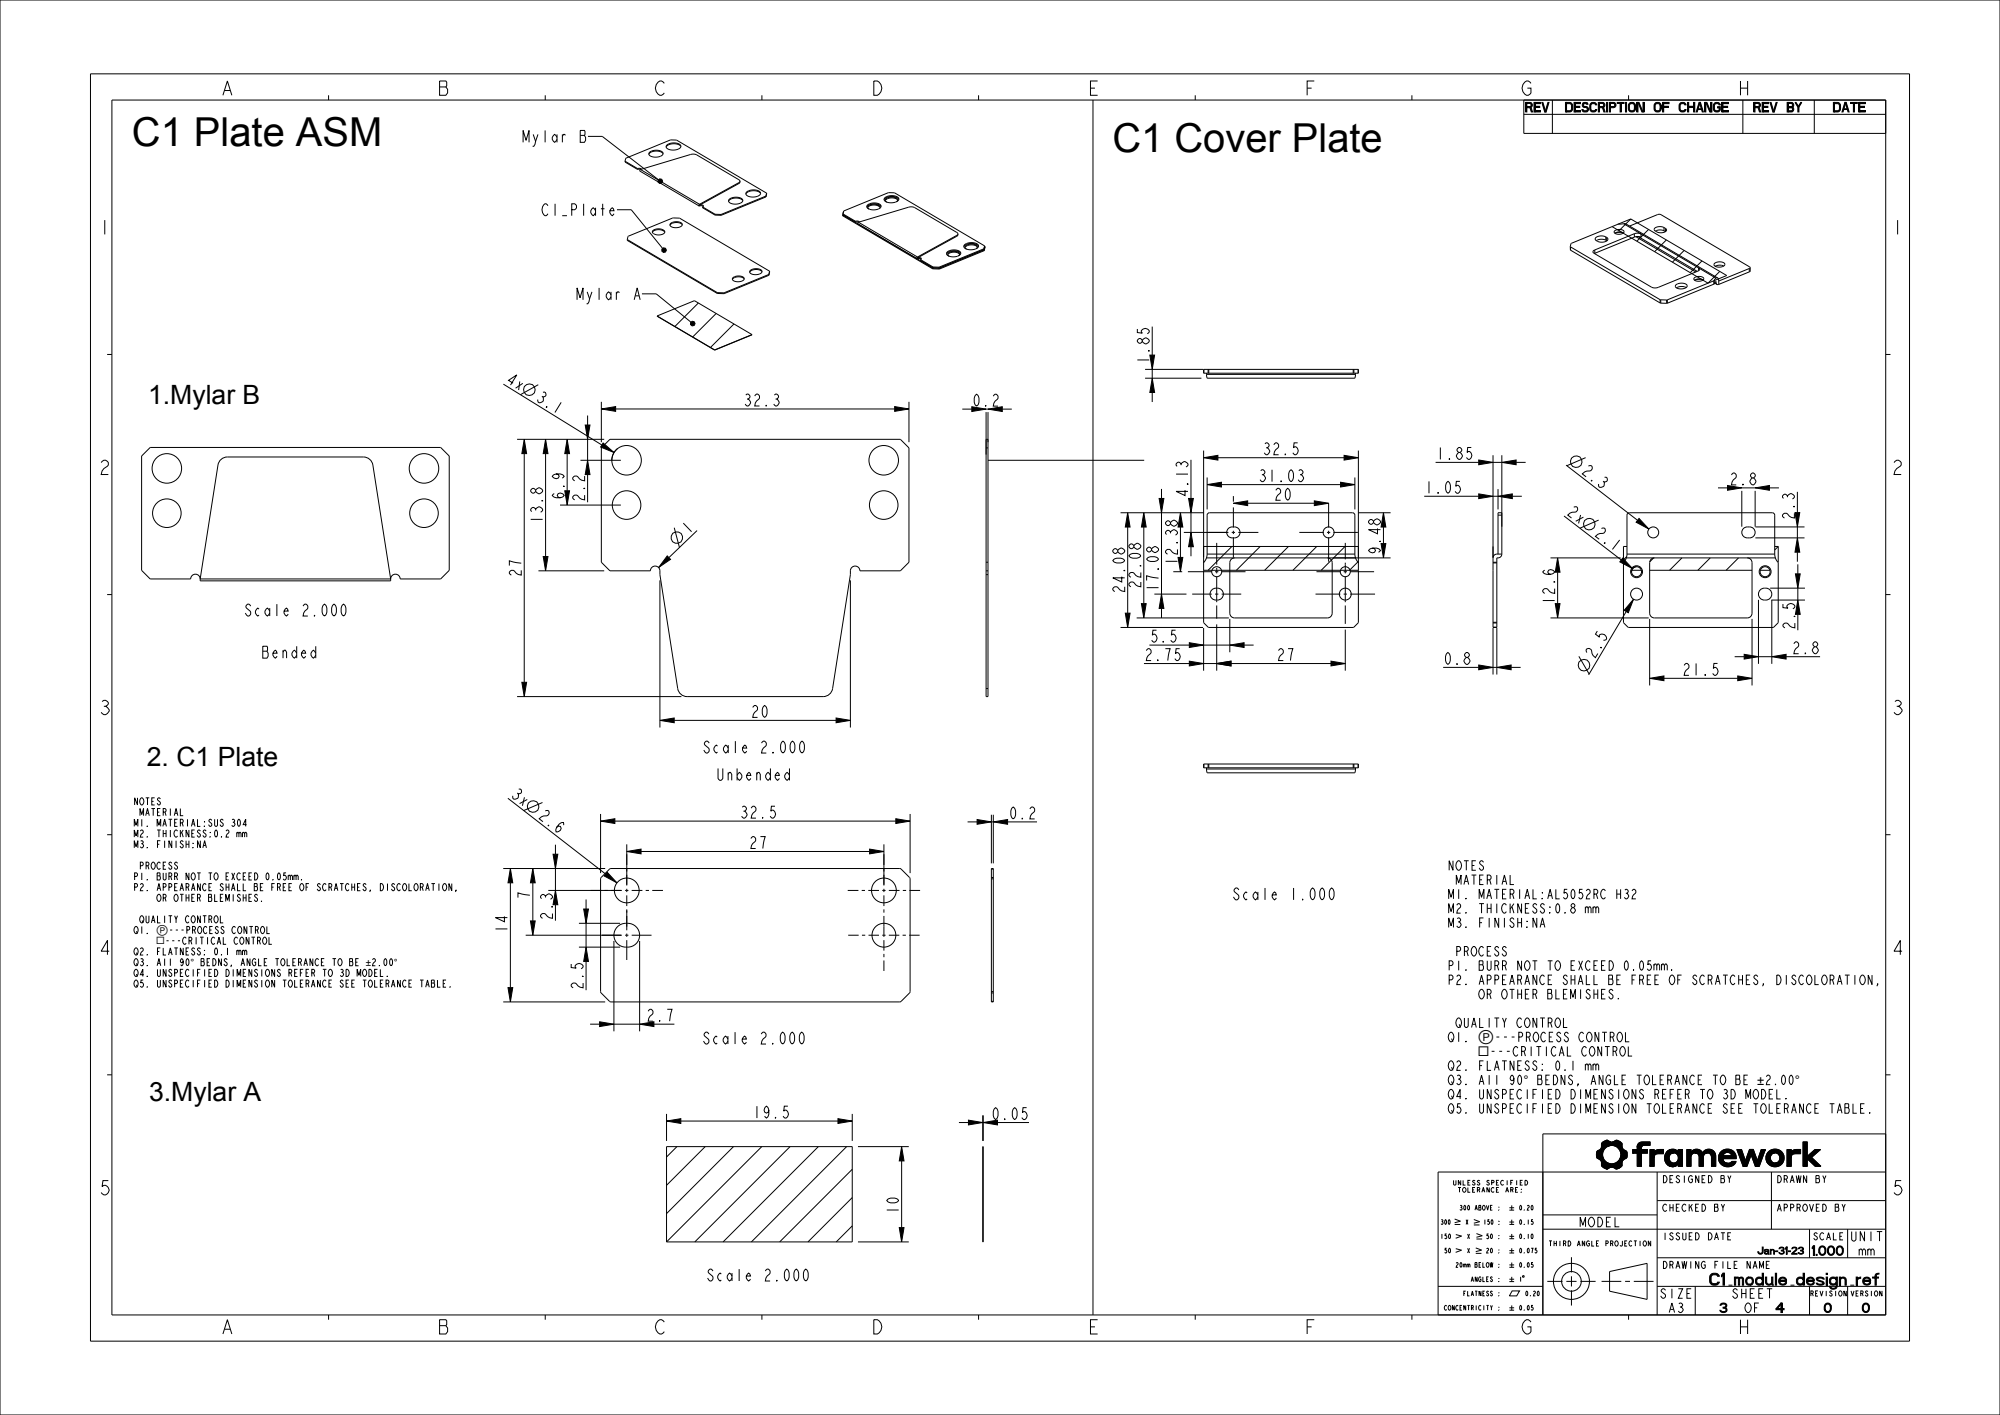
[picture p32: page 3]
MODEL; THIRD ANGLE PROJECTIONISSUED DATE; SCALEUNIT; SIZE; SHEET; REVISION VERSION; NOTES MATERIAL M1. MATERIAL:SUS 304 M2. THICKNESS:0.2 mm M3. FINISH:NA; QUALITY CONTROL Q1. Ⓟ---PROCESS CONTROL; Q3. All 90; ° BEDNS, ANGLE TOLERANCE TO BE; Bended; Unbended; NOTES MATERIAL M1. MATERIAL:AL5052RC H32 M2. THICKNESS:0.8 mm M3. FINISH:NA; Scale 2.000; Mylar B; C1_Plate; Mylar A; Scale; C1 Plate ASM; 1.Mylar B; 3.Mylar A; 2. C1 Plate; C1 Cover Plate

PROCESS
P1. BURR NOT TO EXCEED 0.05mm.
P2. APPEARANCE SHALL BE FREE OF SCRATCHES, DISCOLORATION,
OR OTHER BLEMISHES.
□---CRITICAL CONTROL
Q2. FLATNESS: 0.1 mm
Q4. UNSPECIFIED DIMENSIONS REFER TO 3D MODEL.
Q5. UNSPECIFIED DIMENSION TOLERANCE SEE TOLERANCE TABLE.

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

CHECKED BY | APPROVED BY

Jan-31-23 | 1.000 | mm

DRAWING FILE NAME
C1_module_design_ref

1

1

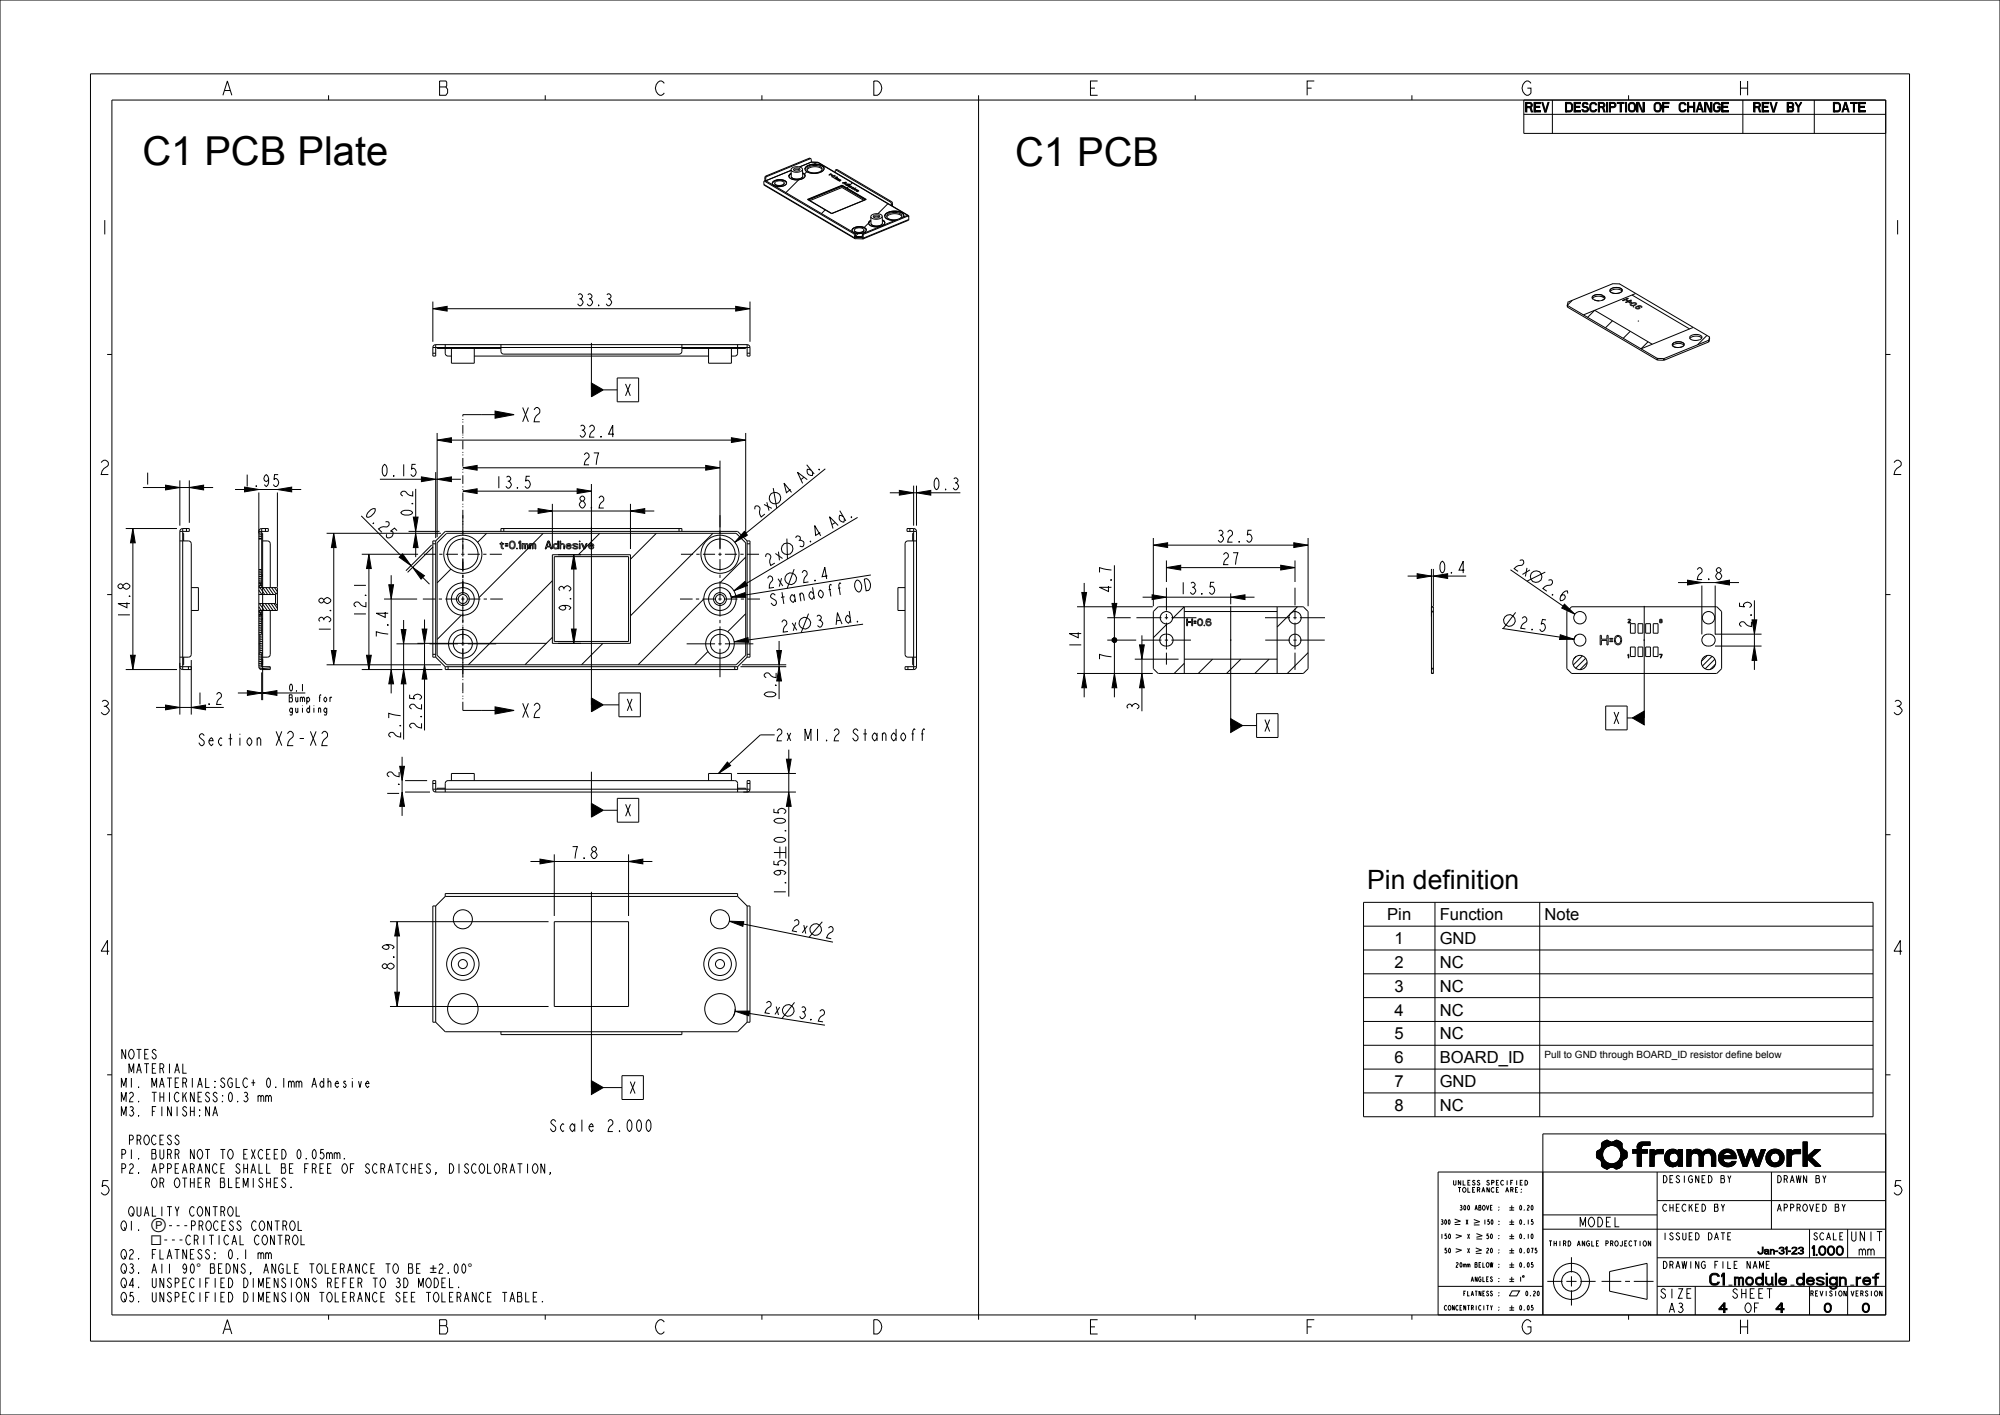
[picture p33: page 4]
2x 2.4 Standoff OD; 0.1 Bump for guiding; MODEL; THIRD ANGLE PROJECTIONISSUED DATE; SCALEUNIT; QUALITY CONTROL Q1. Ⓟ---PROCESS CONTROL; Q3. All 90; ° BEDNS, ANGLE TOLERANCE TO BE; Section; 2x M1.2 Standoff; C1 PCB Plate; C1 PCB; Pin definition

Pin | Function | Note
1 | GND
2 | NC
3 | NC
4 | NC
5 | NC
6 | BOARD_ID | Pull to GND through BOARD_ID resistor define below
7 | GND
8 | NC

NOTES
MATERIAL
M1. MATERIAL:SGLC+ 0.1mm Adhesive
M2. THICKNESS:0.3 mm
M3. FINISH:NA

Scale 2.000

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

CHECKED BY | APPROVED BY

Jan-31-23 | 1.000 | mm

DRAWING FILE NAME
C1_module_design_ref

SIZE | SHEET | REVISION VERSION
