FrameworkComputer/InputModules/Mechanical/Small/PCB/c1_pcb_concept_design_ref.pdf

A

1

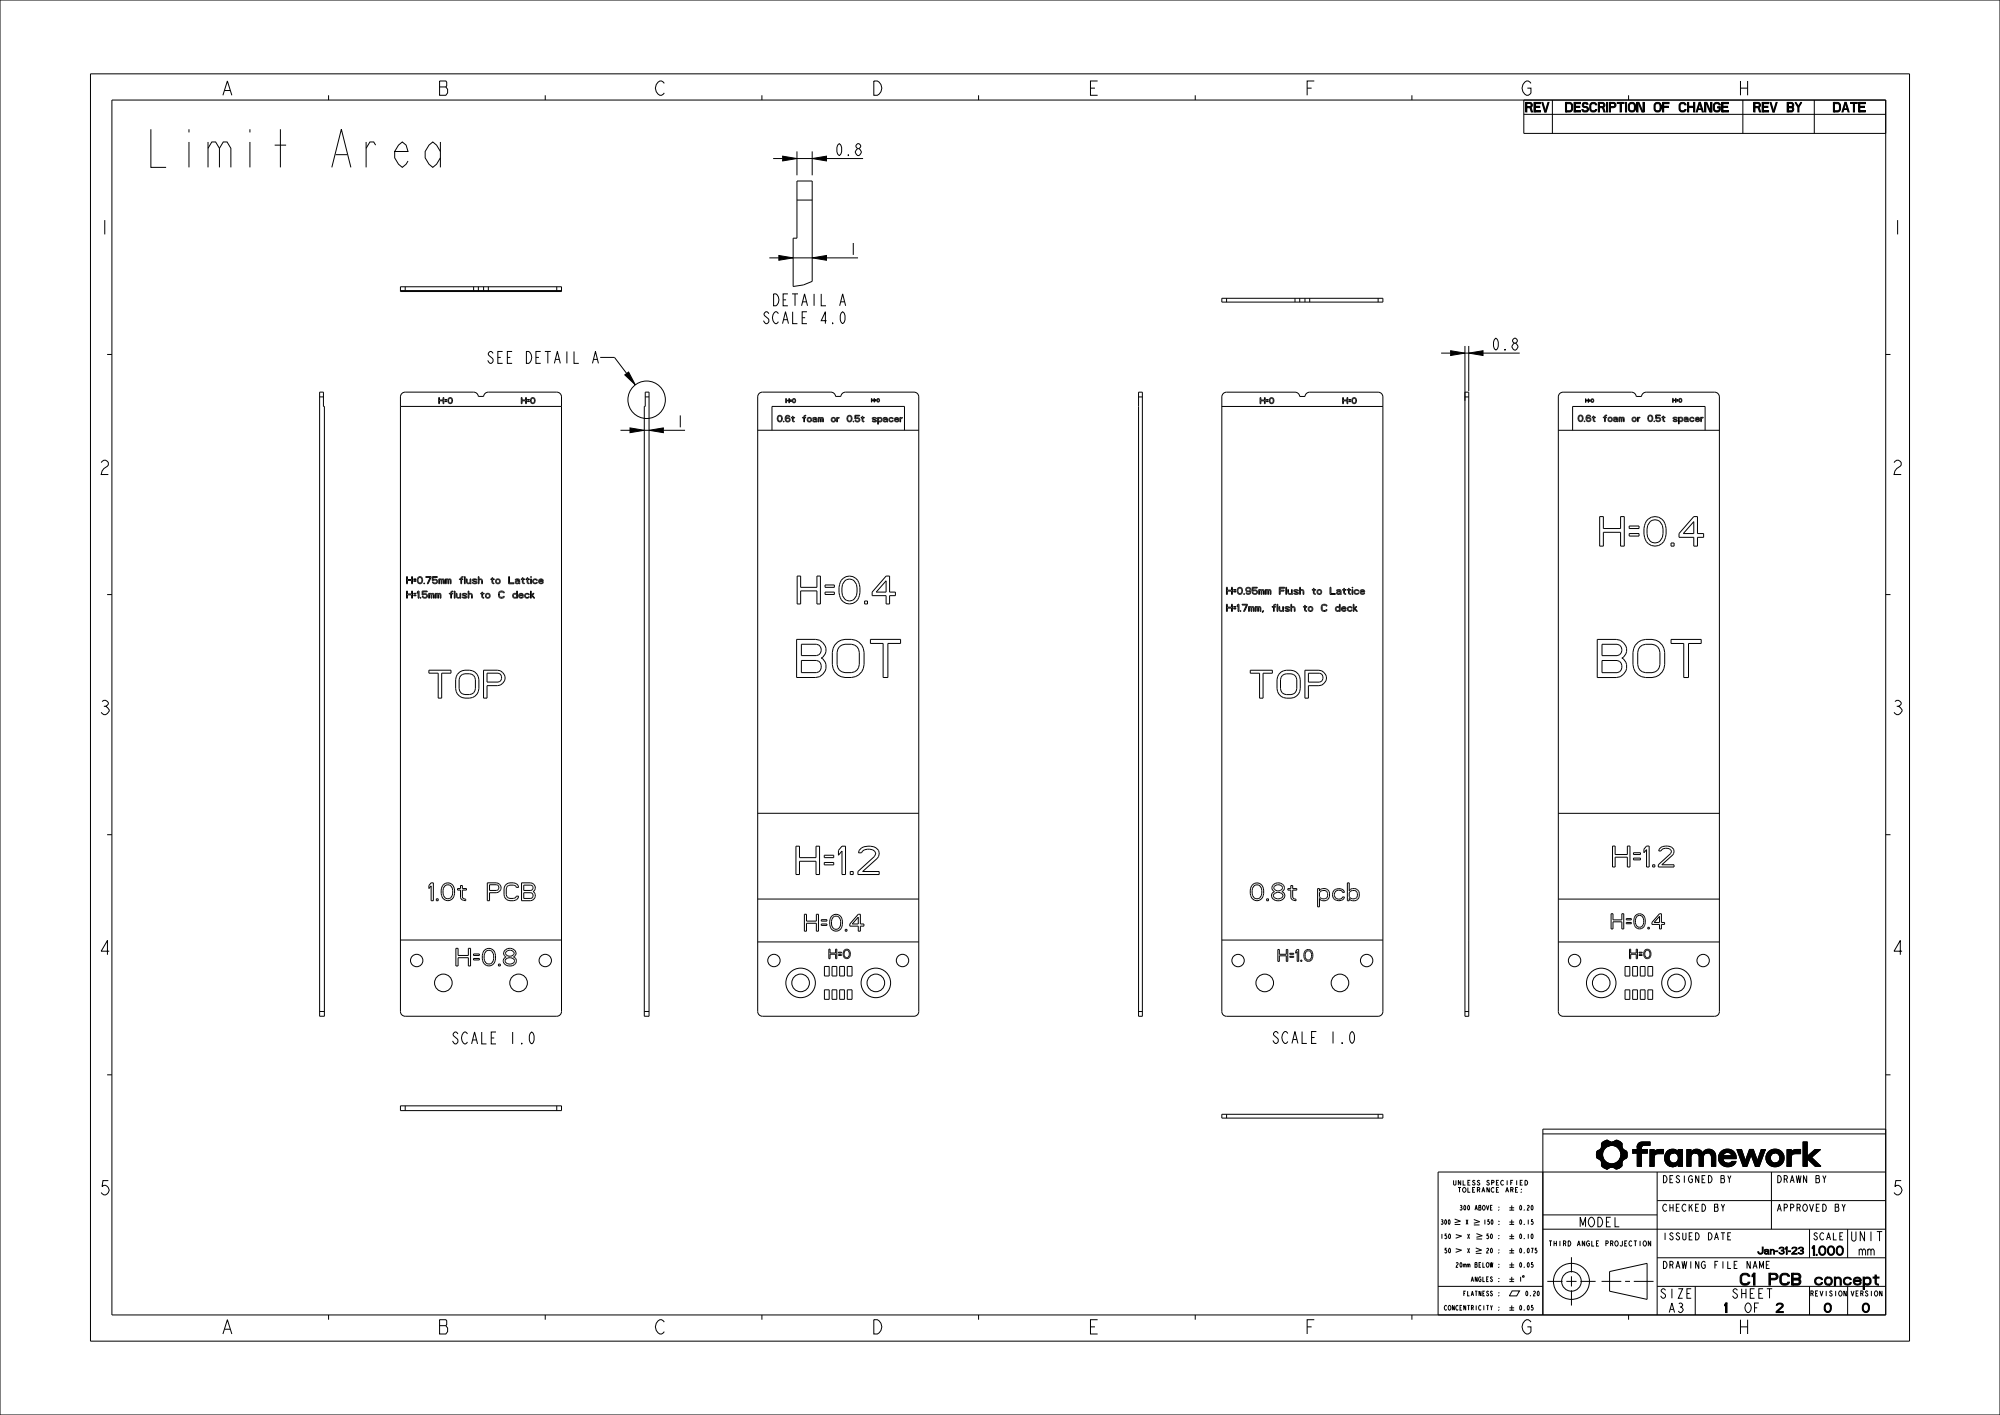
[picture p34: page 1]
MODEL; THIRD ANGLE PROJECTIONISSUED DATE; SCALEUNIT; PCB concept; SIZE; SHEET; REVISION VERSION; FLATNESS :; CONCENTRICITY : 0.05; Limit Area; SCALE 1.0; SEE DETAIL A; SCALE 4.0

DETAIL A | REV | DESCRIPTION OF CHANGEREV BY | DATE

UNLESS SPECIFIED TOLERANCE ARE: 300 ABOVE : 0.20 300 X 150 : 0.15 150 X 50 : 0.10 50 X 20 : 0.075 20mm BELOW : 0.05 ANGLES : 1 | | DESIGNED BY | DRAWN BY

CHECKED BY | APPROVED BY

Jan-31-23 | 1.000 | mm

DRAWING FILE NAME

A

1

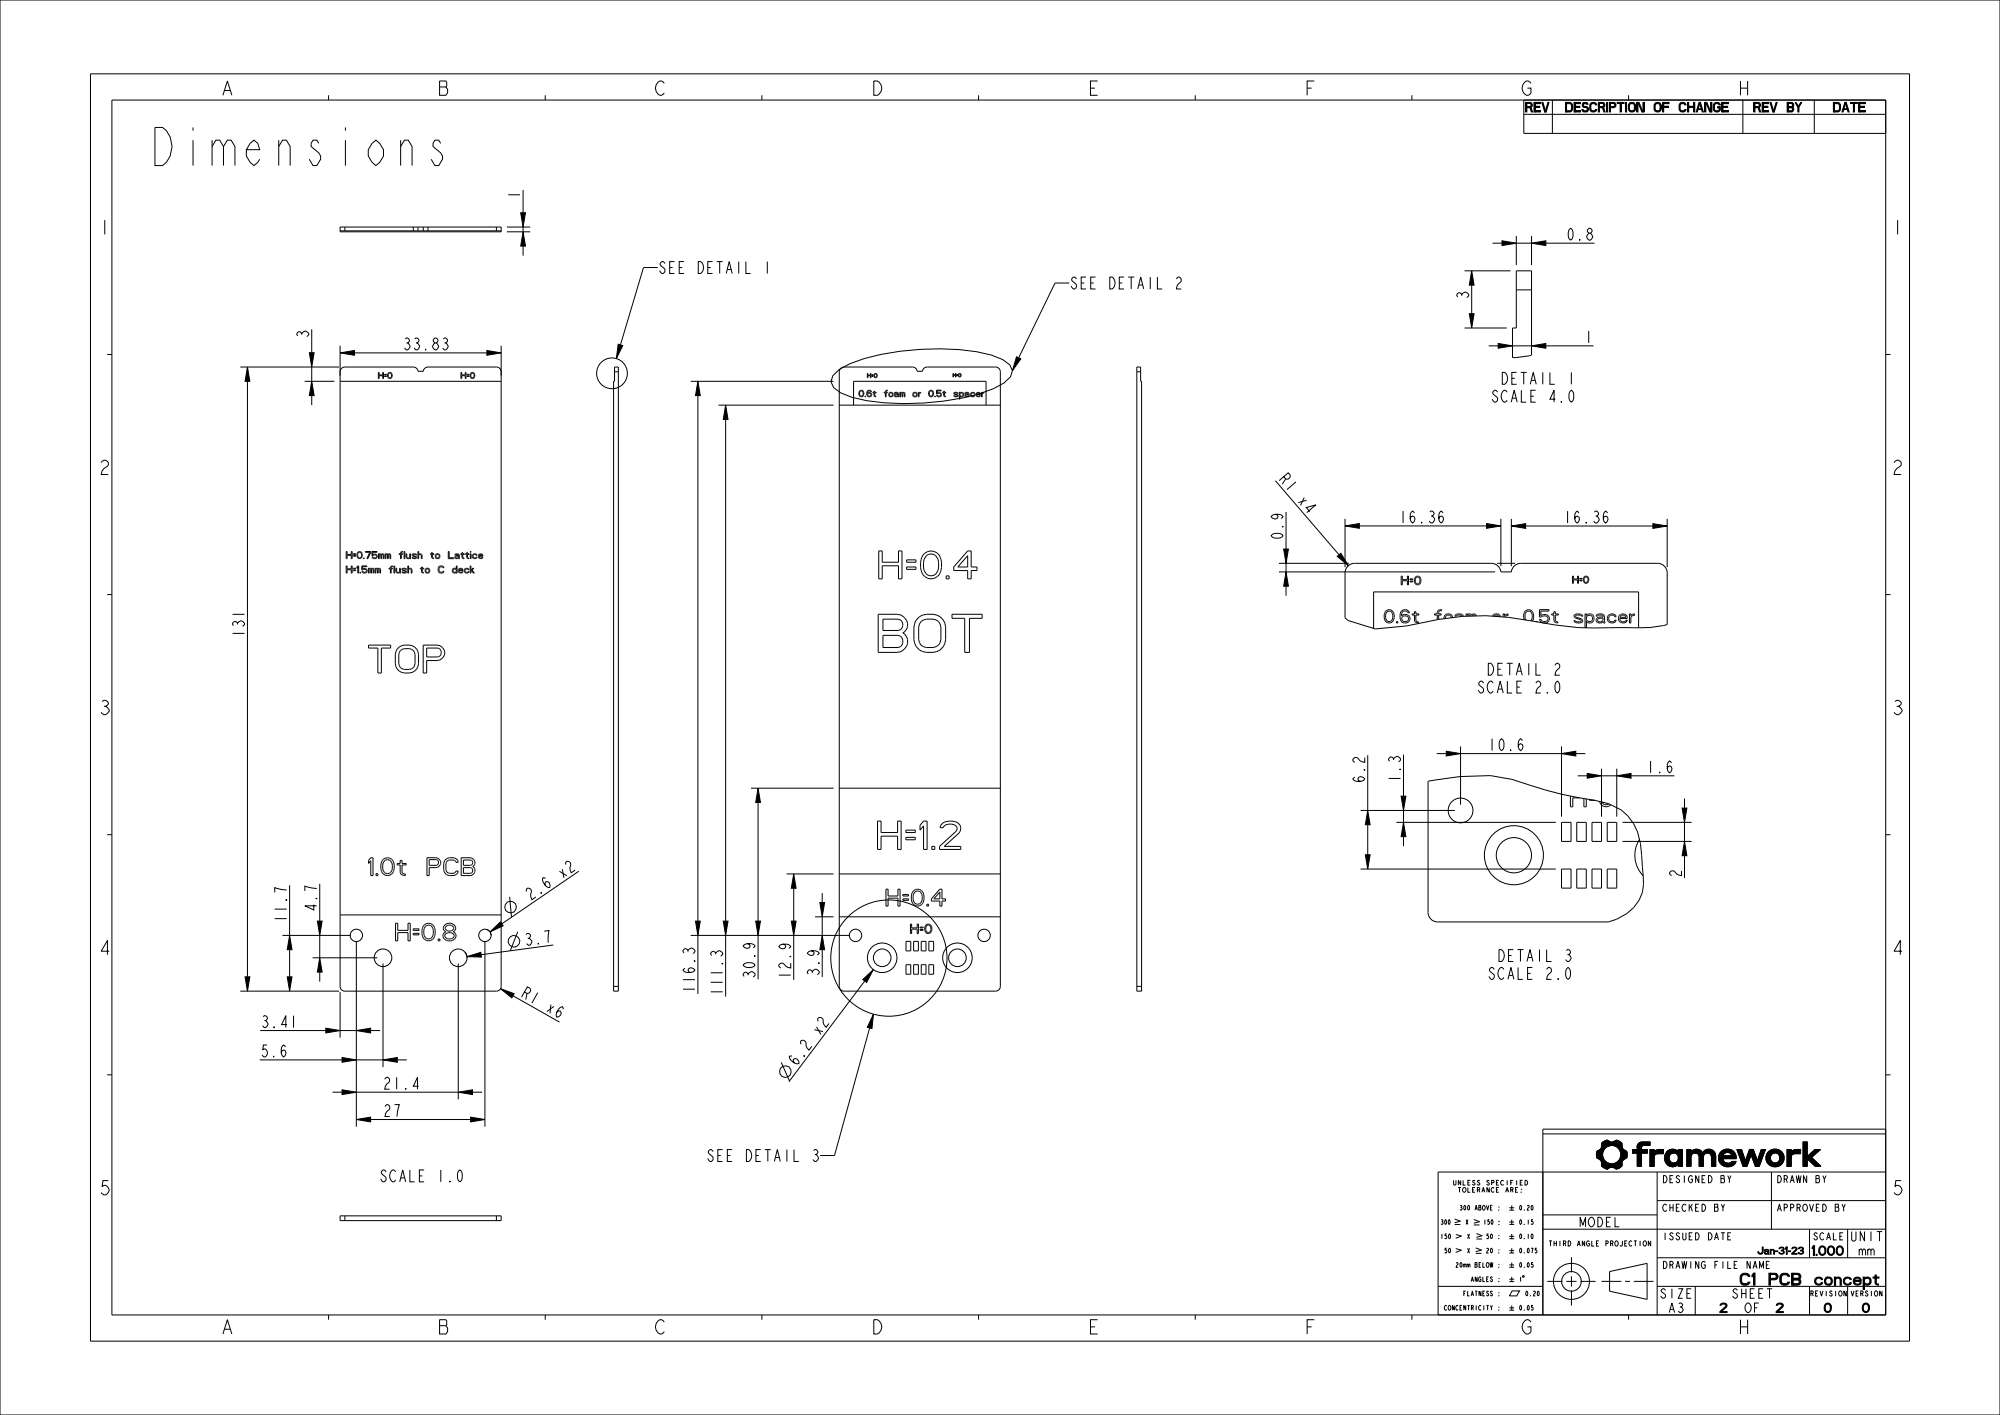
[picture p35: page 2]
MODEL; THIRD ANGLE PROJECTIONISSUED DATE; SCALEUNIT; PCB concept; SIZE; SHEET; REVISION VERSION; FLATNESS :; CONCENTRICITY : 0.05; Dimensions; SCALE 1.0; SEE DETAIL 1; SEE DETAIL 2; SEE DETAIL 3; DETAIL 1 SCALE 4.0; DETAIL 2 SCALE 2.0; DETAIL 3 SCALE 2.0

G H
REV | DESCRIPTION OF CHANGEREV BY | DATE

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

CHECKED BY | APPROVED BY

Jan-31-23 | 1.000 | mm

DRAWING FILE NAME
