FrameworkComputer/InputModules/OneKeyModule/Electrical/Framework One Key Module Lattice.pdf

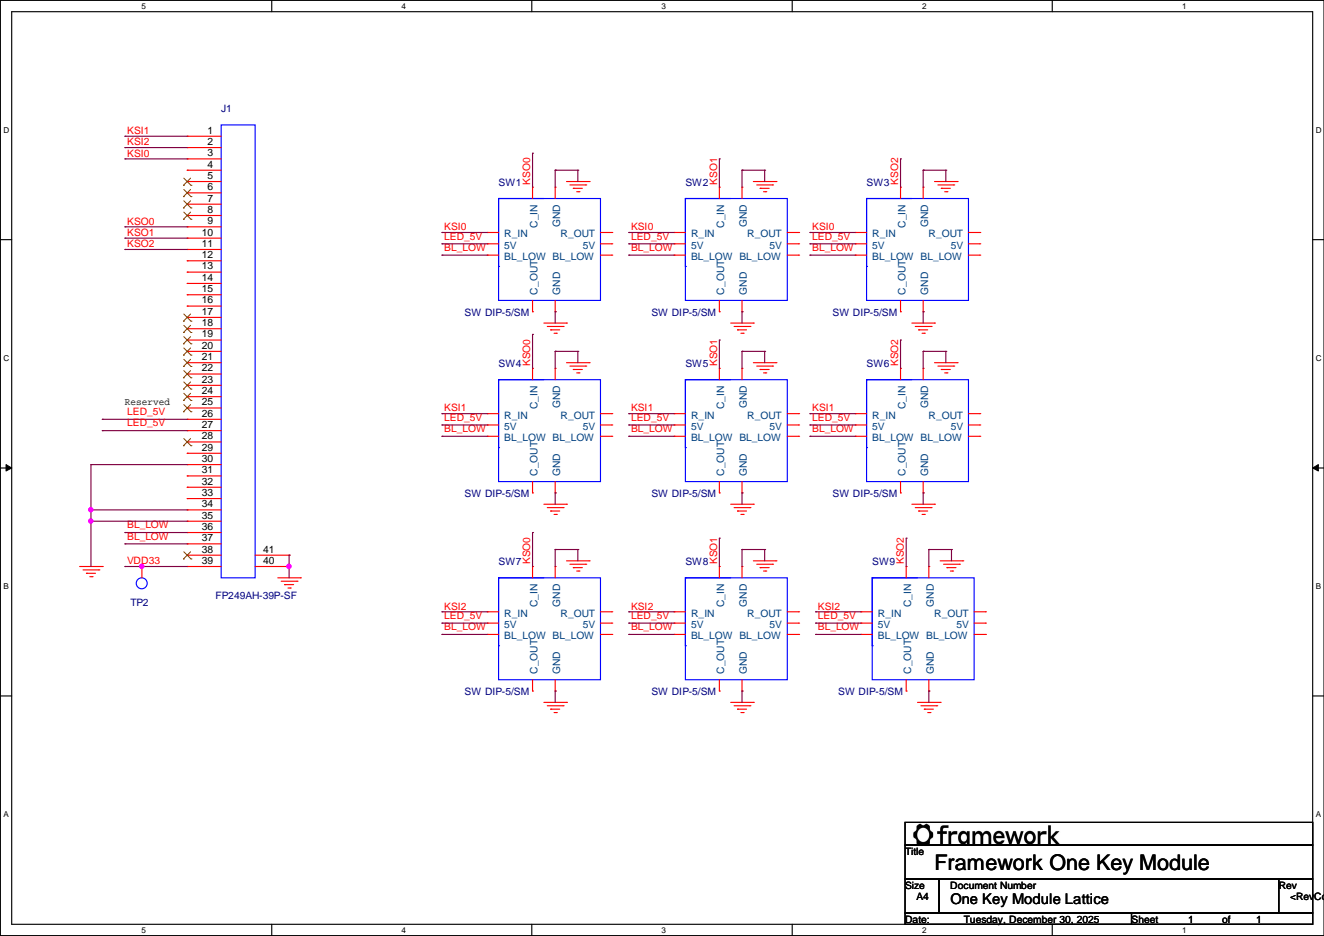
[picture p36: page 1]

Title
Framework One Key Module
