FrameworkComputer/InputModules/OneKeyModule/Electrical/Framework Ony Key Module.pdf

# GND DIO TP11

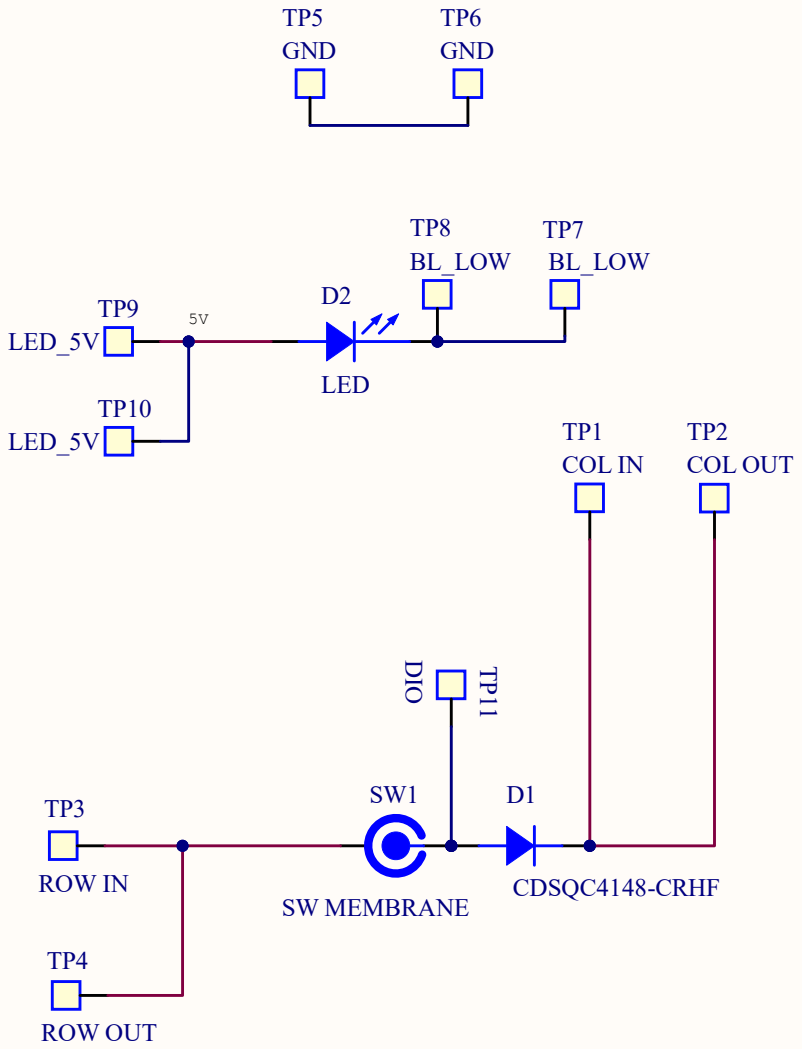
[picture p37: page 1]

Title
Framework One Key Module
One Key Module
