FrameworkComputer/InputModules/Electrical/LEDMatrix/Atemitech LED Matrix.pdf

D | D

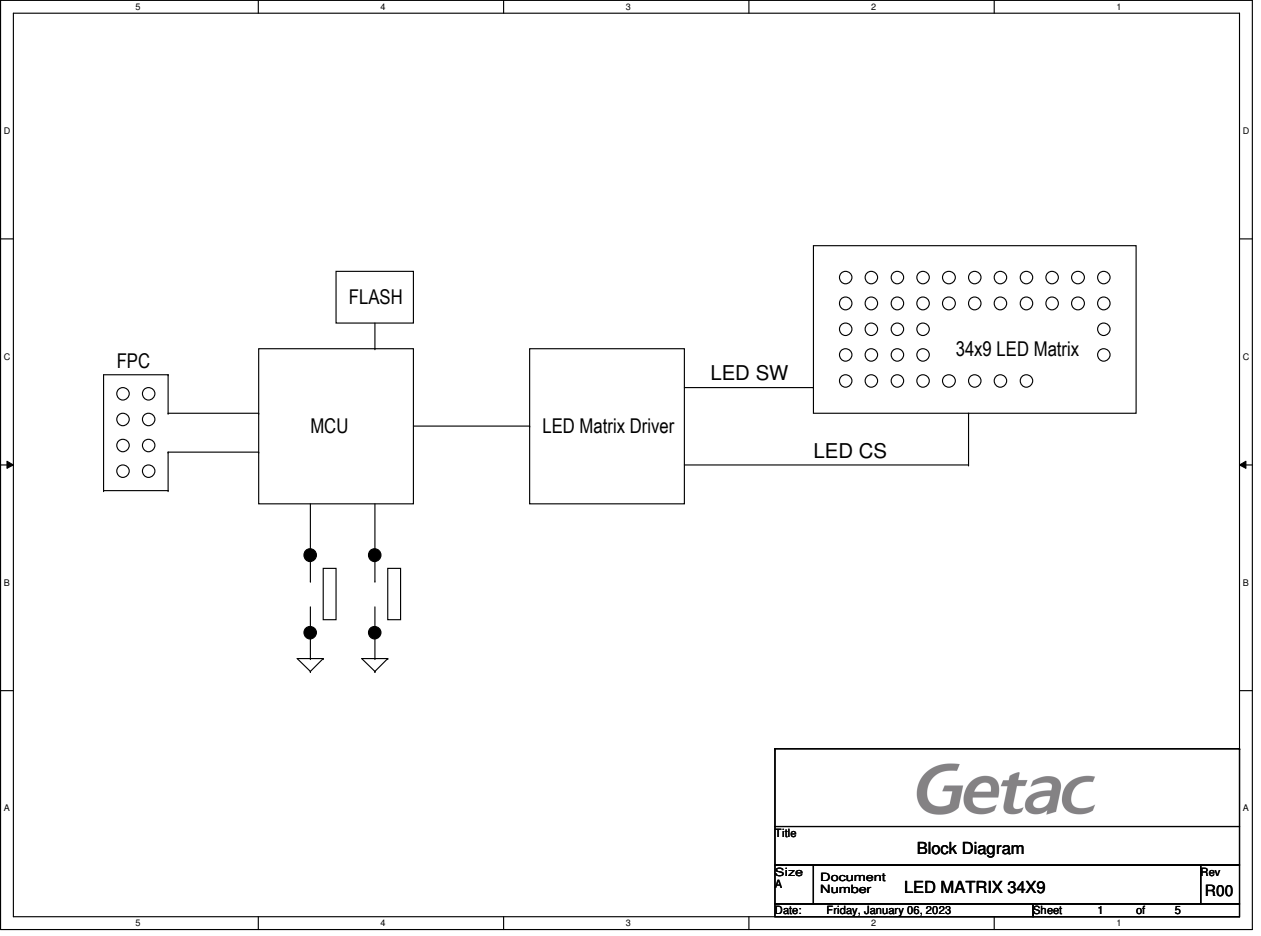
[picture p41: page 1]
34x9 LED Matrix; LED SW; LED CS; MCU; FPC; FLASH; Title; Size; Document; Number; Rev; Date:; Sheet; LED MATRIX 34X9; Block Diagram; Friday, January 06, 2023

LED Matrix Driver

D | D
Pin 1 | Pin 10

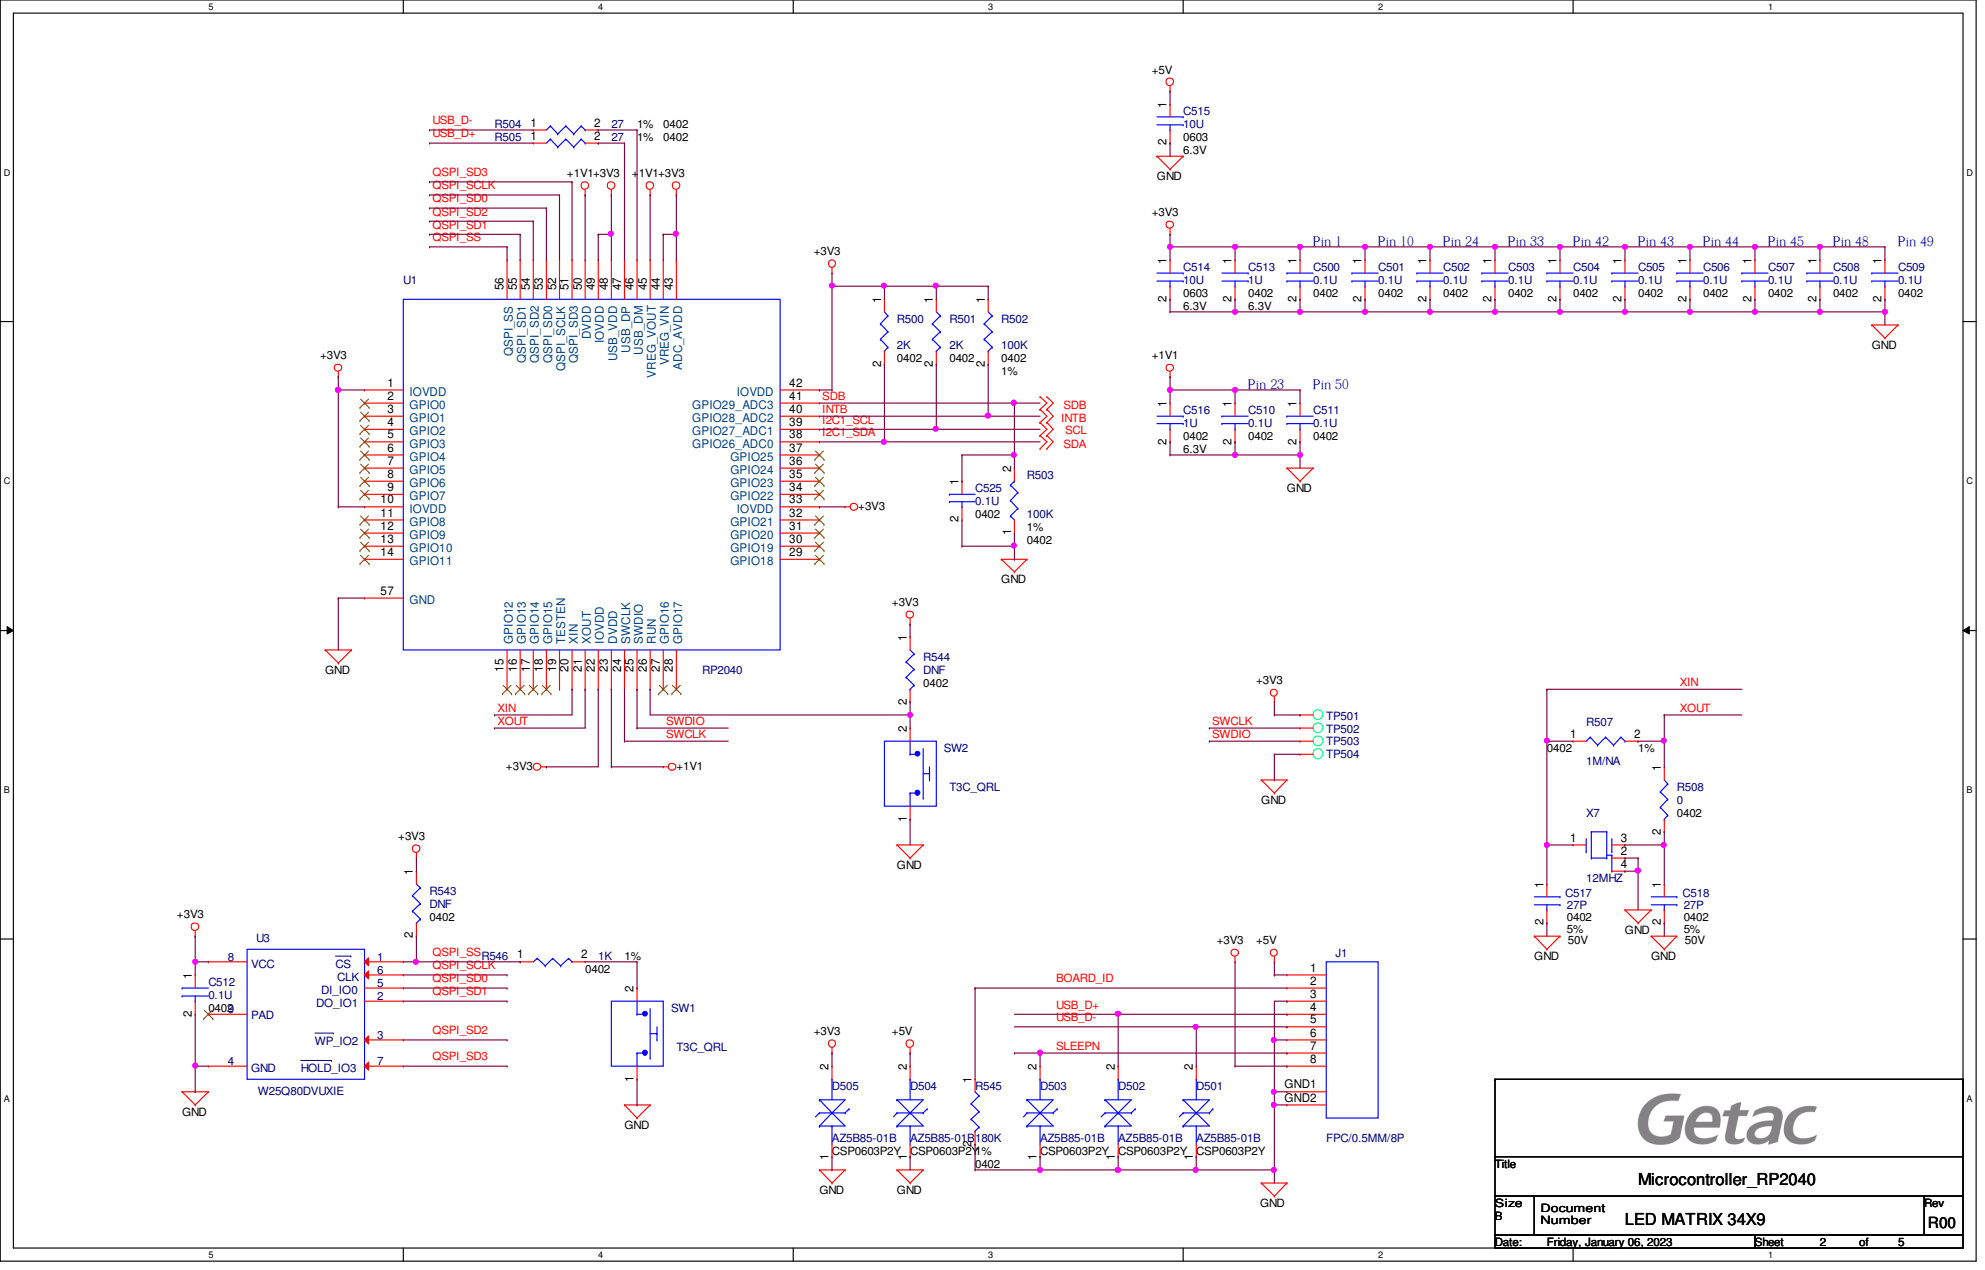
[picture p42: page 2]

D | D

# GND

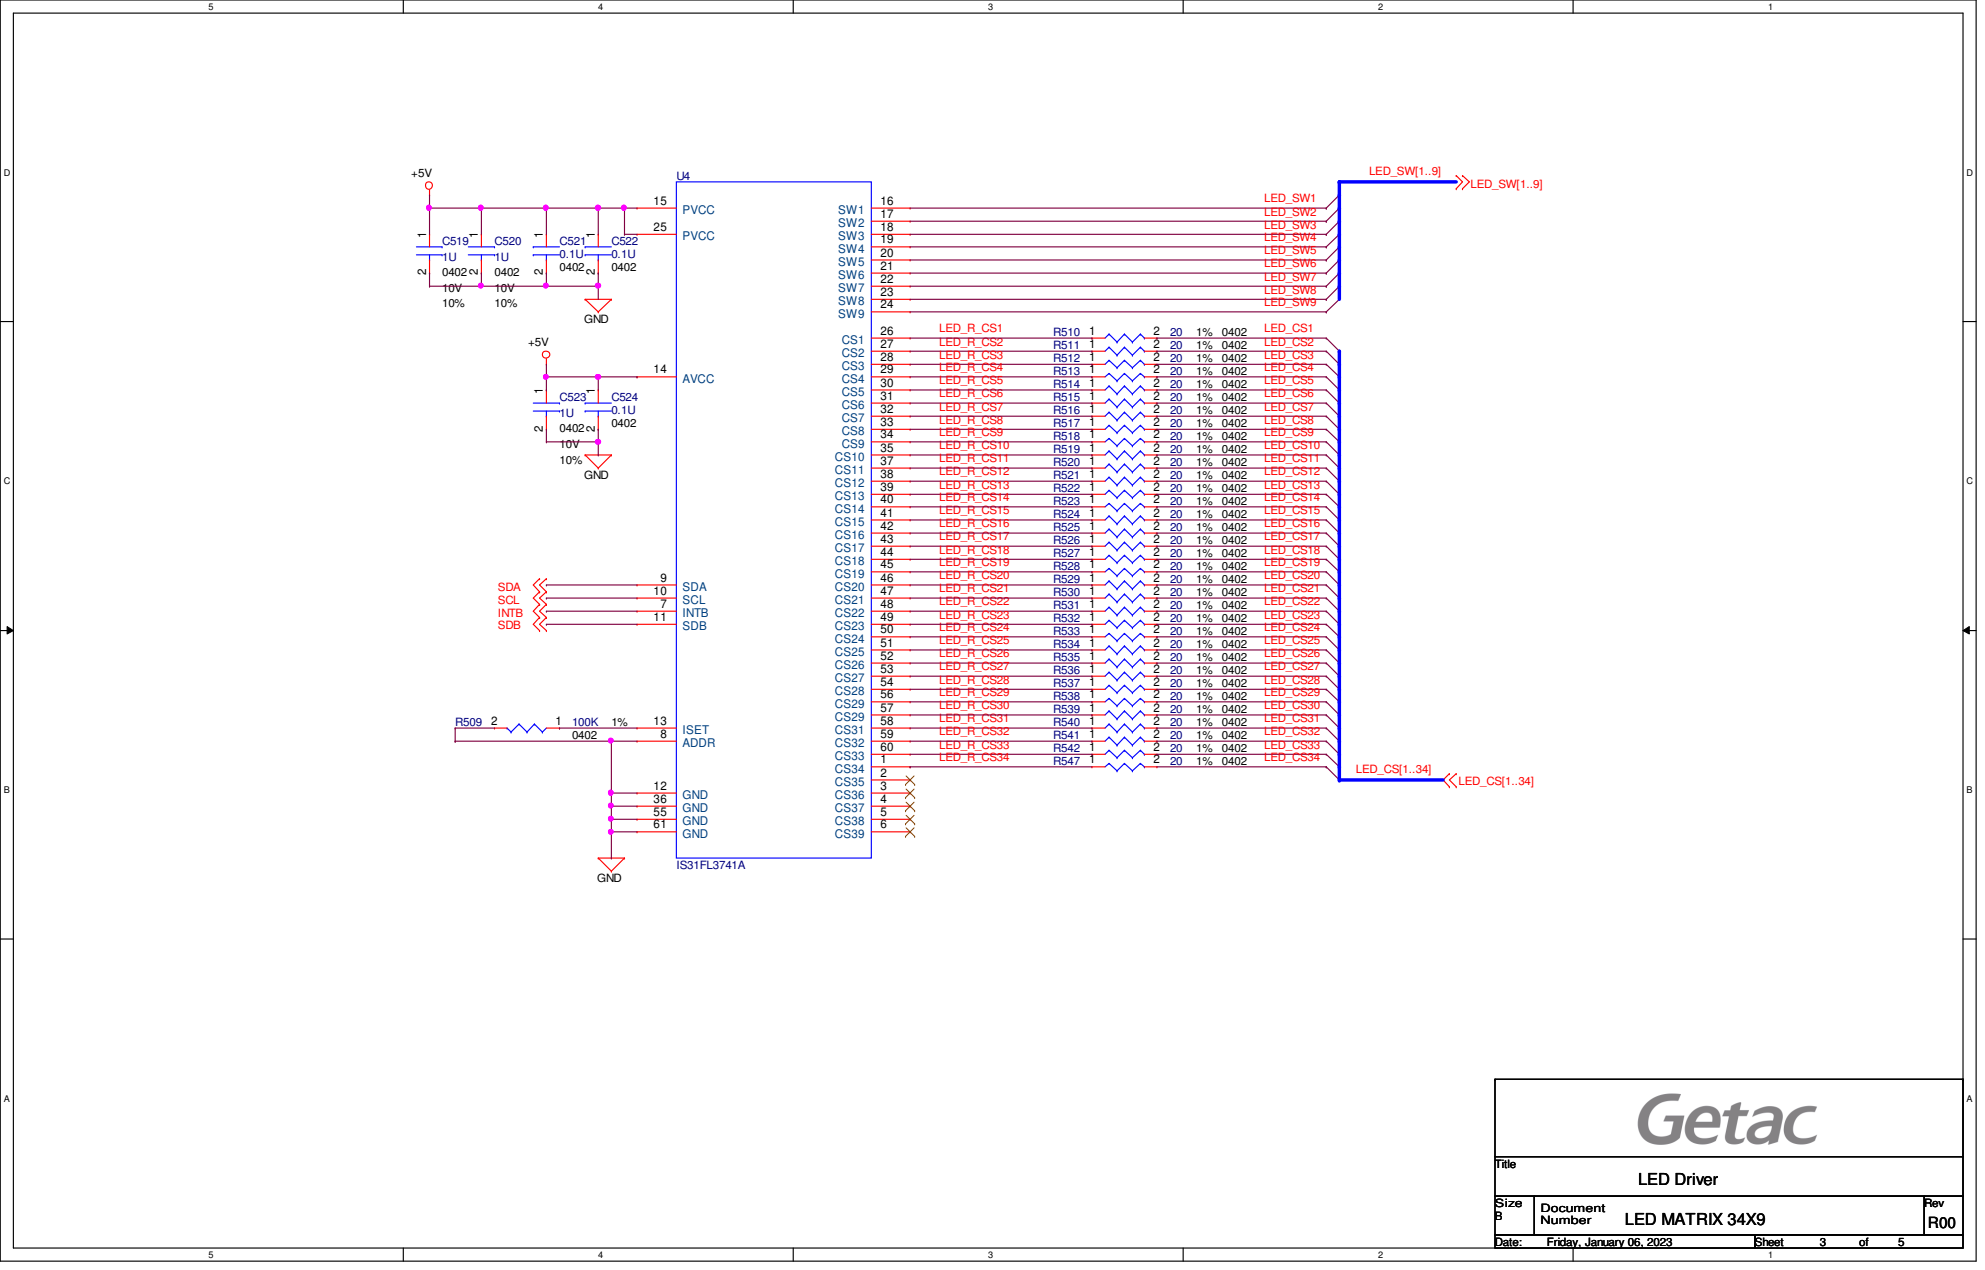
[picture p43: page 3]

A | K
A | K

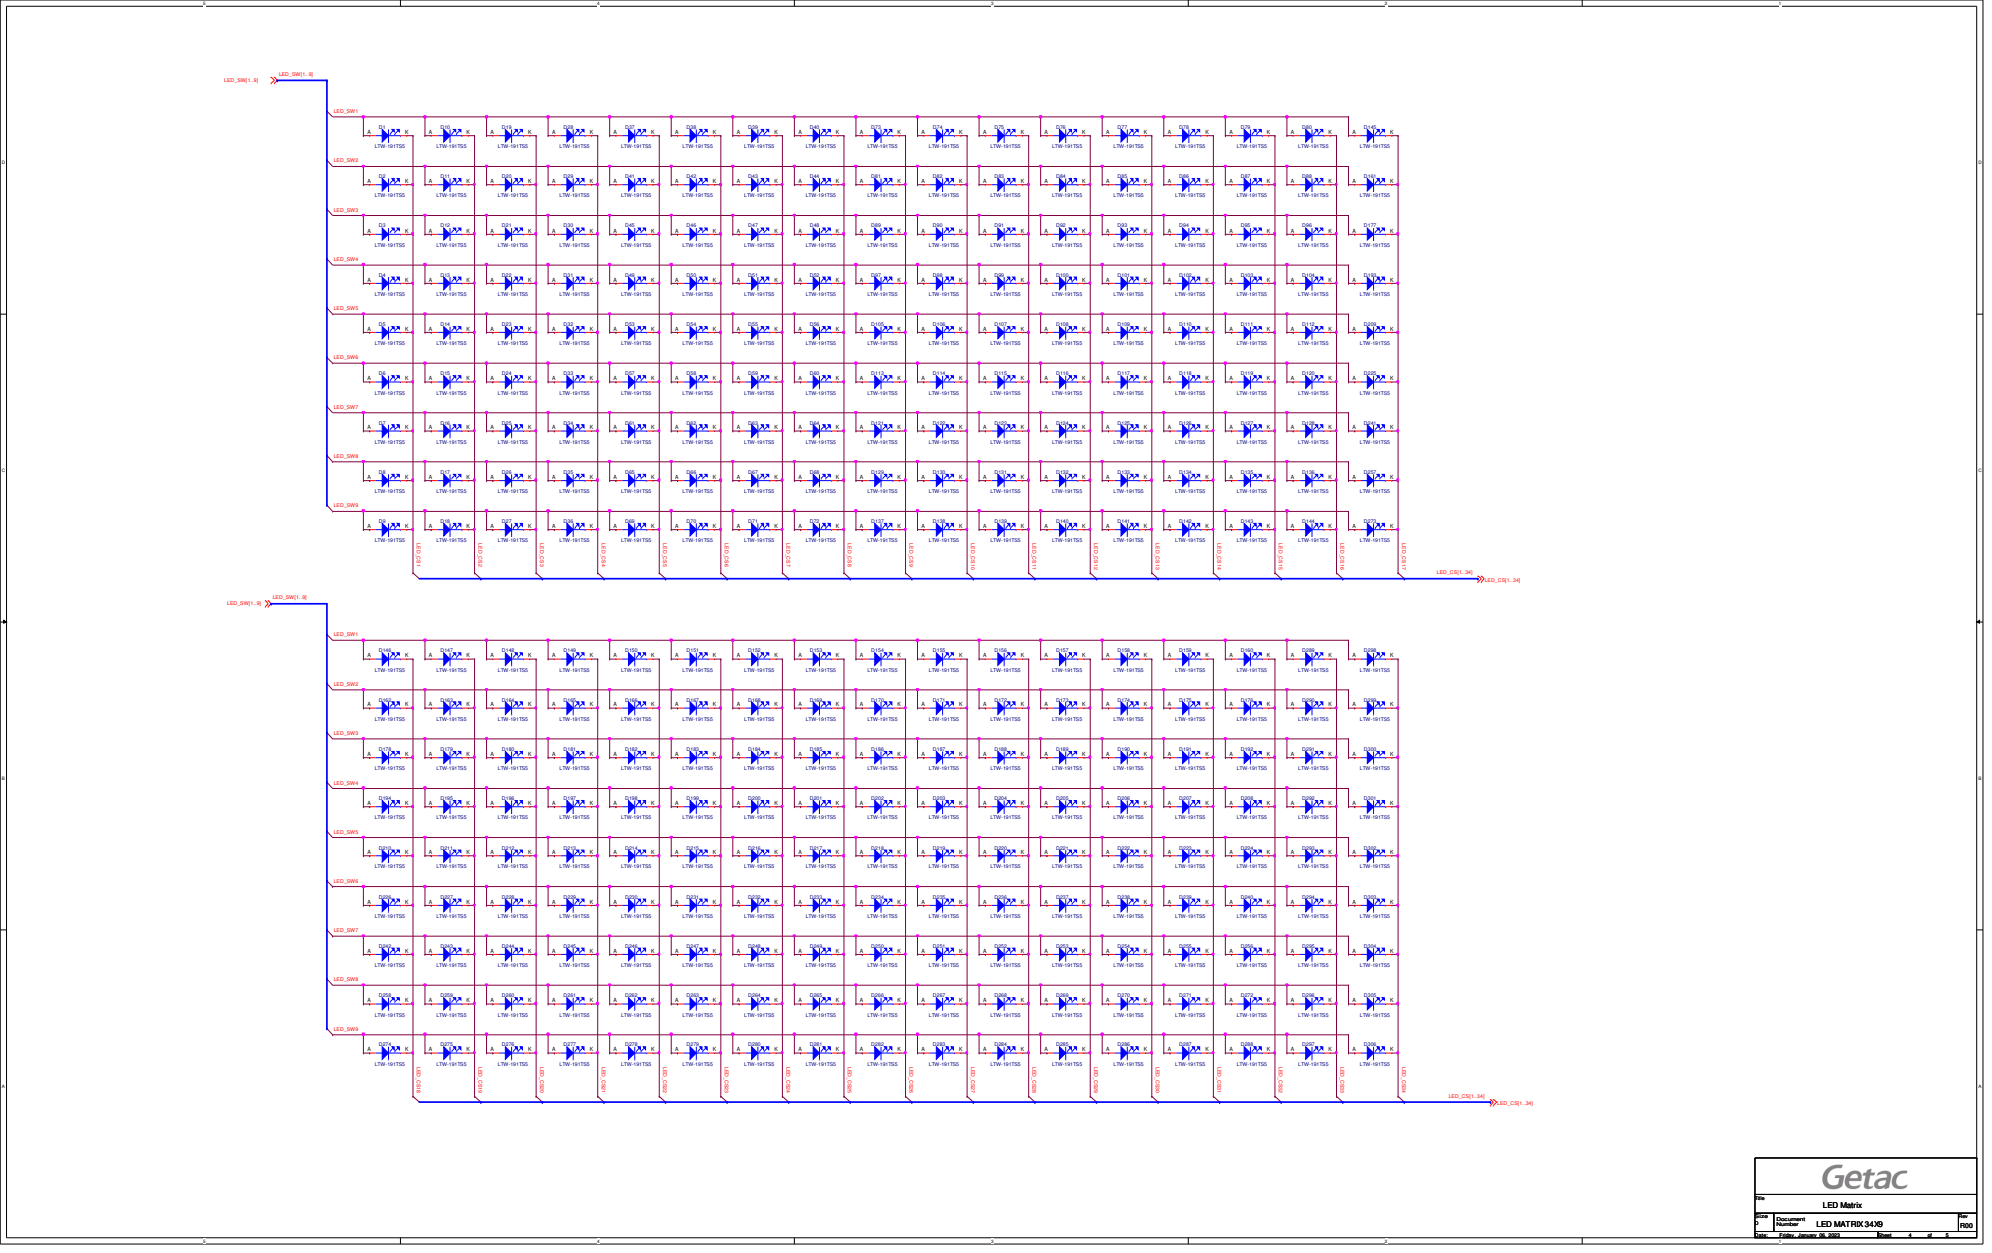
[picture p44: page 4]

D | D
Issued Date | Remark

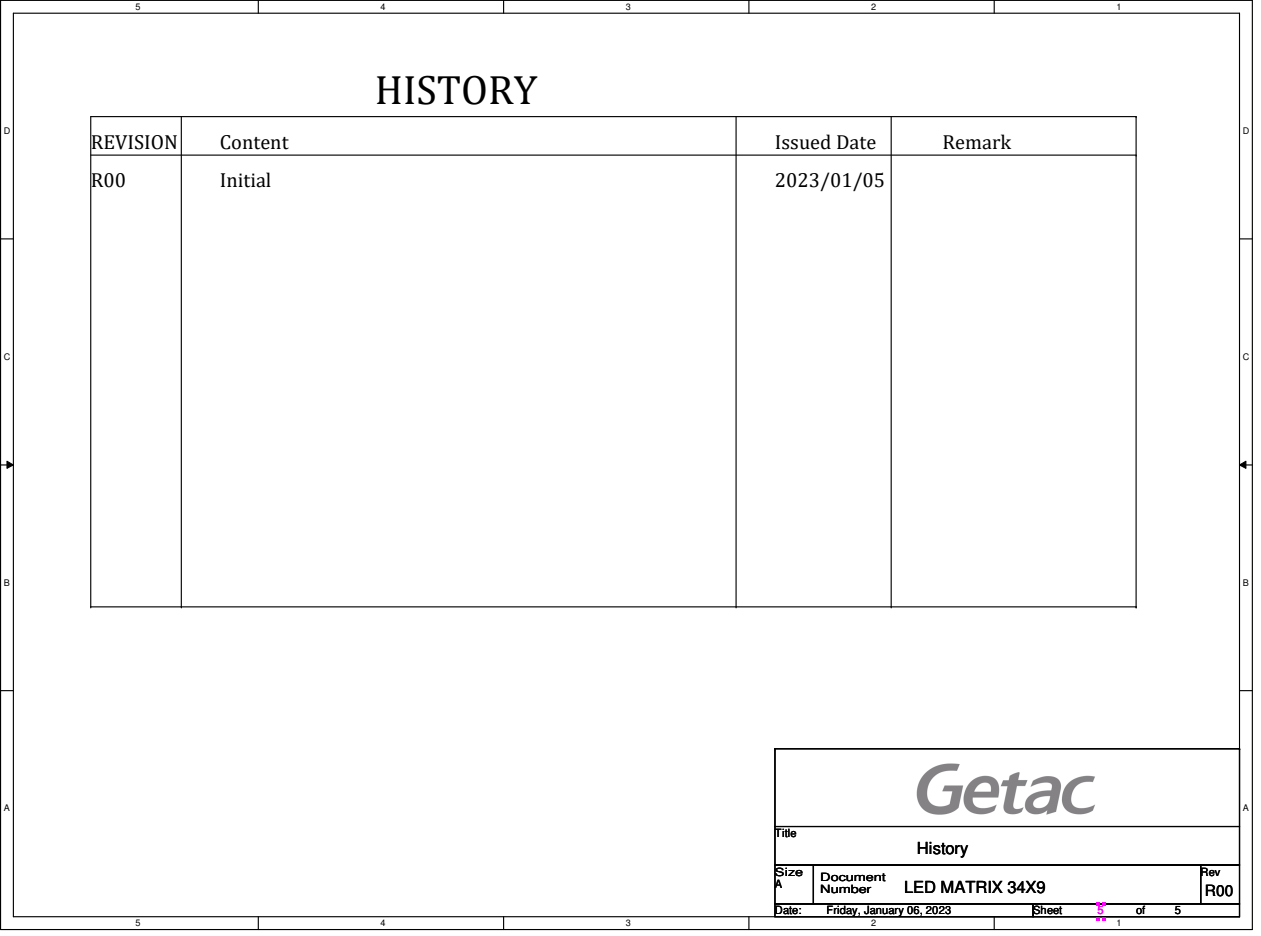
[picture p45: page 5]
HISTORY; Content; REVISION; Initial; Title; Size; Document; Number; Rev; Date:; Sheet; LED MATRIX 34X9; History; Friday, January 06, 2023
