FrameworkComputer/InputModules/(commit log)

2022-12-19 Initial version
    [Driver.kicad_sch, LEDMatrix.kicad_pcb, LEDMatrix.kicad_sch, Matrix.kicad_sch]
2022-12-30 Input module adapter
    [SpringAdapter.kicad_pcb, SpringAdapter.kicad_sch]
2023-01-14 Minimal reference design
    [MinimalInputModule.kicad_pcb, MinimalInputModule.kicad_sch]
2023-01-14 Testpoint silkscreen
    [MinimalInputModule.kicad_pcb]
2023-01-14 Radius board outline and notch
    [MinimalInputModule.kicad_pcb]
2023-01-23 Add second mounting hole
    [SpringAdapter.kicad_pcb, SpringAdapter.kicad_sch]
2023-02-06 Spring adapter add drawing and second mounting hole
    [SpringAdapter.kicad_sch]
2023-02-06 Use circular hole for the LED
    [MinimalInputModule.kicad_pcb, MinimalInputModule.kicad_sch]
2023-02-15 Fix Flash part and LED hole
    [MinimalInputModule.kicad_pcb, MinimalInputModule.kicad_sch]
2023-02-15 correct spring position
    [SpringAdapter.kicad_pcb, SpringAdapter.kicad_sch]
2023-02-15 Update PCB rev
    [SpringAdapter.kicad_pcb]
2023-03-01 Update to KiCAD 7.0.0
    Also reduce LED hole diameter
    [MinimalInputModule.kicad_pcb, MinimalInputModule.kicad_sch]
2023-03-08 Switch to pogo pins
    [SpringAdapter.kicad_pcb, SpringAdapter.kicad_sch]
2023-03-10 Add bosses to pogo connector
    [SpringAdapter.kicad_pcb]
2023-03-10 Add connector datasheets
2023-03-12 Switch to pogo pads
    [MinimalInputModule.kicad_pcb, MinimalInputModule.kicad_sch]
2023-03-12 Move into electrical folder
    [Driver.kicad_sch, LEDMatrix.kicad_pcb, LEDMatrix.kicad_sch, Matrix.kicad_sch, MinimalInputModule.kicad_pcb, MinimalInputModule.kicad_sch, SpringAdapter.kicad_pcb, SpringAdapter.kicad_sch]
2023-03-12 Draft mechanical CAD
    [C1_pcb_ref_design_0_8t_00.stp, C1_pcb_ref_design_1_0t_00.stp, a1_module_design_ref_00_1.dxf, c1_design_space_ref.stp, c1_design_space_ref_1.dxf, c1_design_space_ref_2.dxf, c1_design_space_ref_3.dxf, c1_design_space_ref_4.dxf]
2023-03-12 Rename to Microcontroller Input Module
    [MicrocontrollerInputModule.kicad_pro.kicad_pcb, MicrocontrollerInputModule.kicad_pro.kicad_sch]
2023-03-12 Rename again.
    [MicrocontrollerInputModule.kicad_pcb, MicrocontrollerInputModule.kicad_sch]
2023-03-12 Fix some footprints
    [MicrocontrollerInputModule.kicad_pcb]
2023-03-12 Adjust name on silkscreen
    [SpringAdapter.kicad_pcb]
2023-03-12 Minimal Small Input Module
    [MinimalSmallInputModule.kicad_pcb, MinimalSmallInputModule.kicad_sch]
2023-03-17 Slight dimensional fixes
    [SpringAdapter.kicad_pcb]
2023-03-20 Add sheet text and update to KiCAD 7.0.0
    [Driver.kicad_sch, LEDMatrix.kicad_pcb, LEDMatrix.kicad_sch, Matrix.kicad_sch]
2024-01-30 Add BOARD_ID values
2024-02-18 Remove obsoleted spring connector
2024-10-14 Electrical/LEDMatrix: Add pinout
2024-10-14 Electrical/LEDMatrix: Mention I2C address
2024-11-19 LEDMatrix: Document test pads of mass production unit
2025-10-15 Link to touchpad mechanical CAD
2025-10-18 Document touchpad silkscreen
2025-10-18 Document I2C HID Protocol
2025-12-29 Add OneKeyModule Folder (#23)
    Add One Key Module for developers to design custom input hardware for the Framework Laptop 16.
    [One_Key_Module_CAD.stp]
2026-01-20 Clarify board ID values
2026-01-20 README: Mention LED matrix drivers
2026-01-20 Document assumption that board ID is on the left of module
2026-01-20 Keyboard: Directly document led positions
2026-01-20 Zephyr board definitions are upstreamed now
2026-01-30 Clarify input deck board ID handling
2026-02-02 Fix touchpad pinout
    VCC and interrupt were swapped
