FrameworkComputer/InputModules/(notices)

Notices in the files:
Electrical/MicrocontrollerInputModule/MicrocontrollerInputModule.kicad_sch:
This work is licensed under a Creative Commons Attribution 4.0 International License
Electrical/MicrocontrollerInputModule/MicrocontrollerInputModule.kicad_pcb:
2023 Framework CC BY 4.0
